nguyenthanhthe/uet-robotic-arm/docs/media/frames_assembly_check/frame_12.5s.jpg

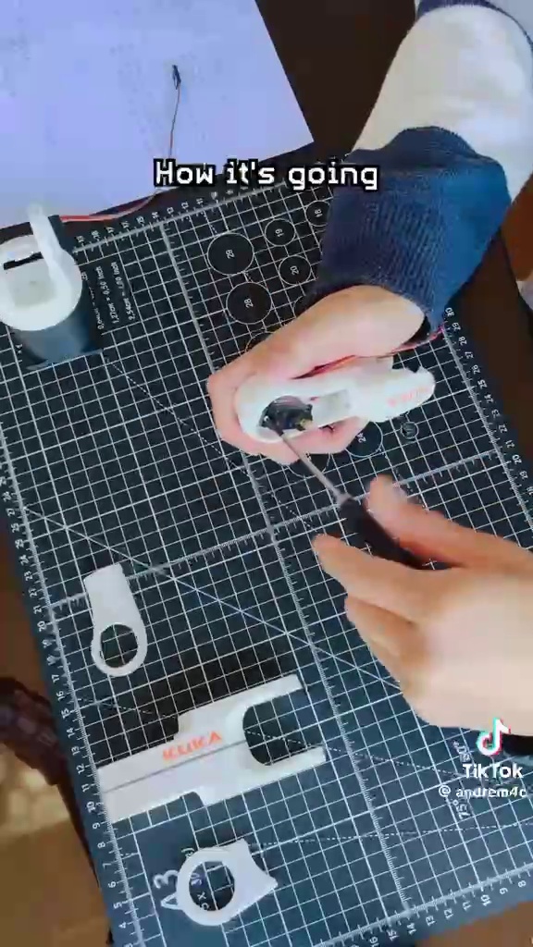
docs/media/frames_assembly_check/frame_12.5s.jpg
