nguyenthanhthe/uet-robotic-arm/docs/archive/rebrand-v2.md

note: not publish modified cad files, focus on completely on v2RAD, remove unnessary components detailed in cad step files: 
1, Base-Cover-rebranded.step: a triangle 55x68mm Protrude by 1mm. 
2, forearm-cover
3, forearm-main
