nguyenthanhthe/uet-robotic-arm/cad/exports/v2rad/engraving-Base-Cover.png

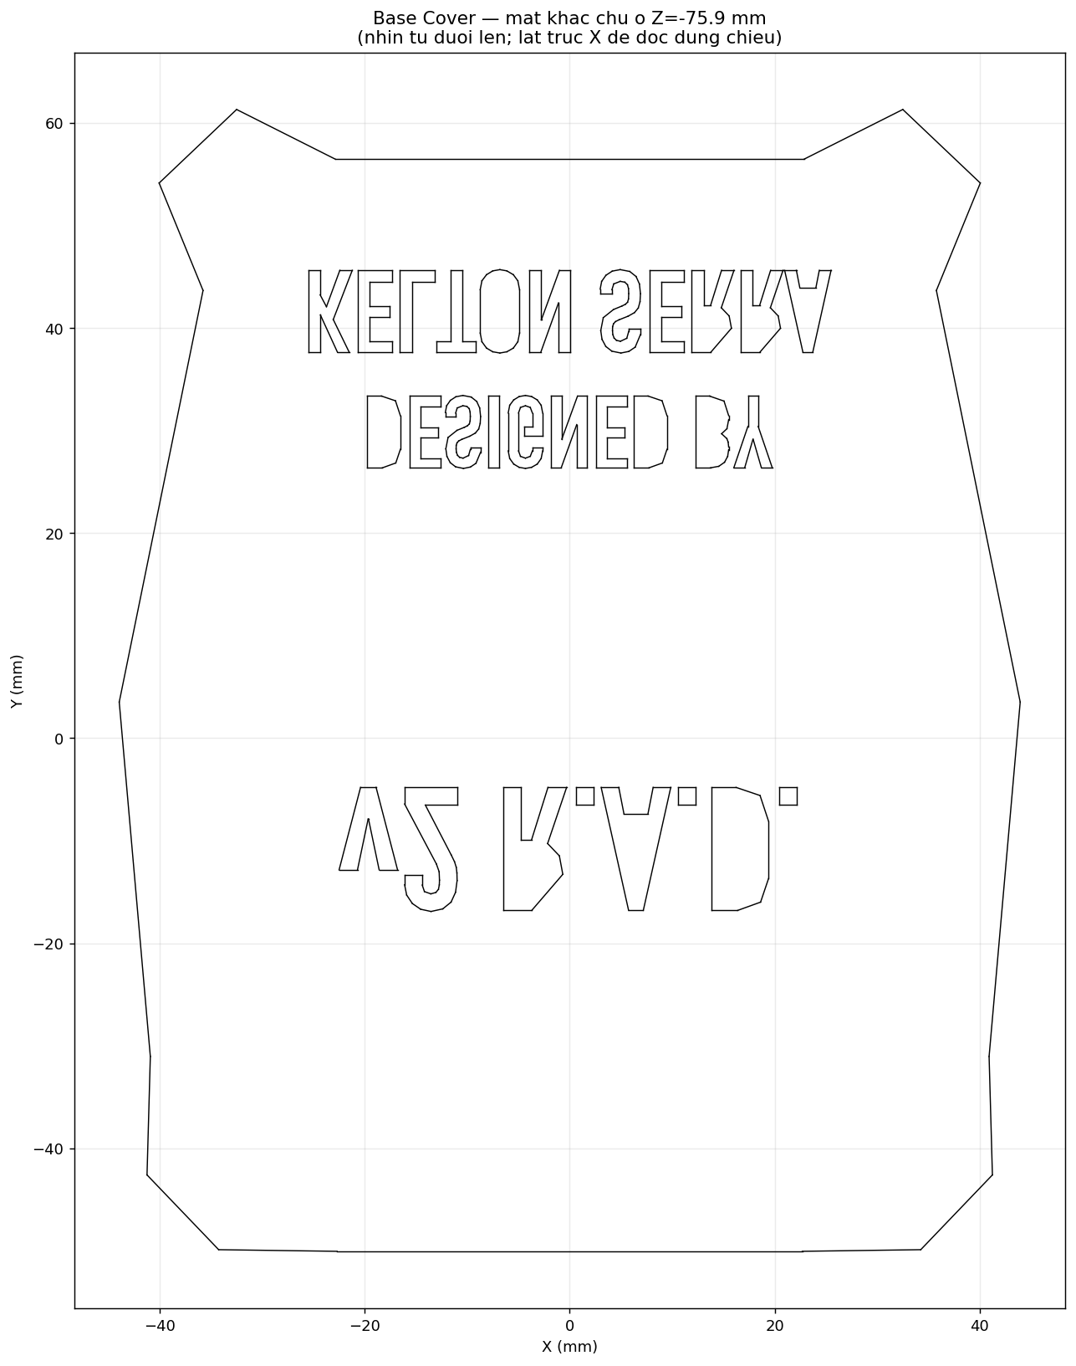
cad/exports/v2rad/engraving-Base-Cover.png
