nguyenthanhthe/uet-robotic-arm/cad/reference/02_Base_Turret_preview.png

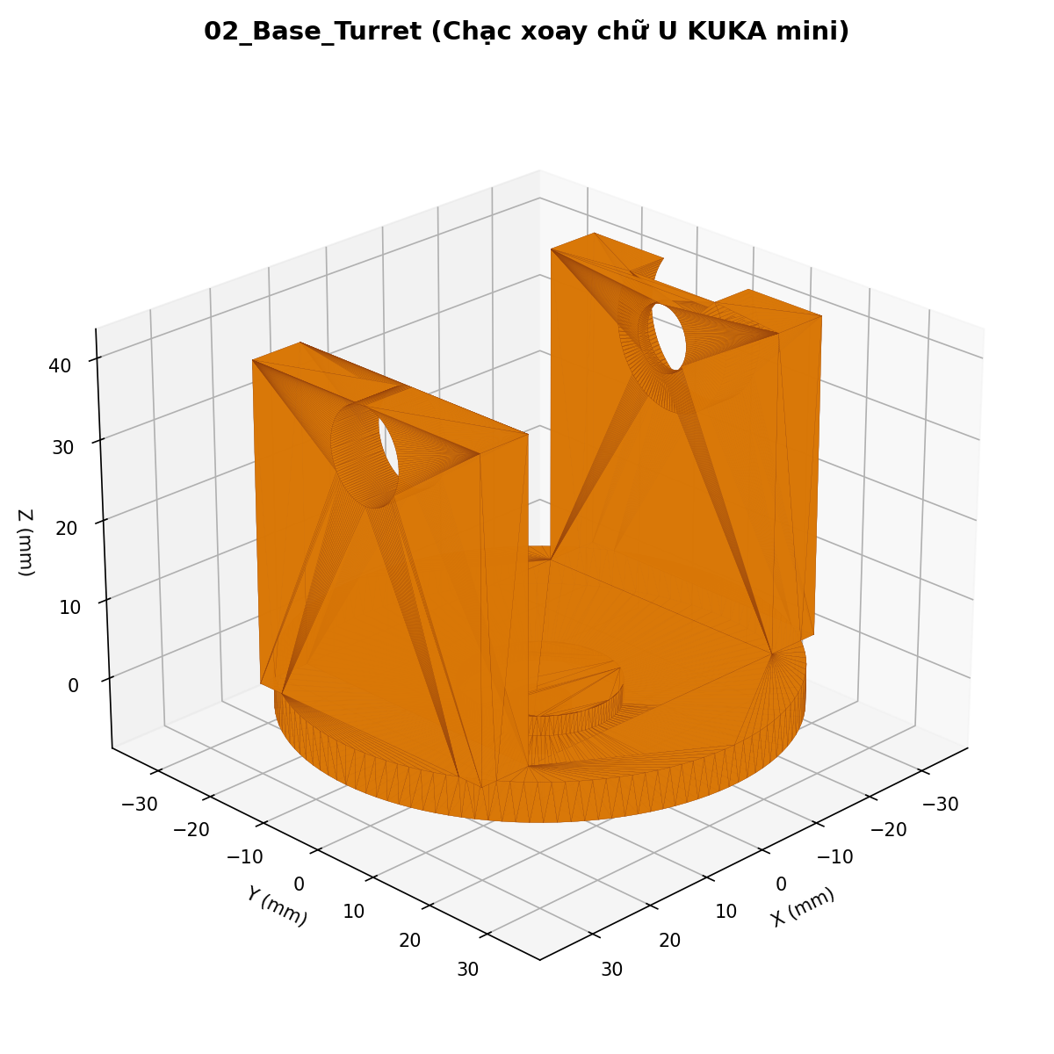
cad/reference/02_Base_Turret_preview.png
