nguyenthanhthe/uet-robotic-arm/cad/reference/fusion_live_viewport.png

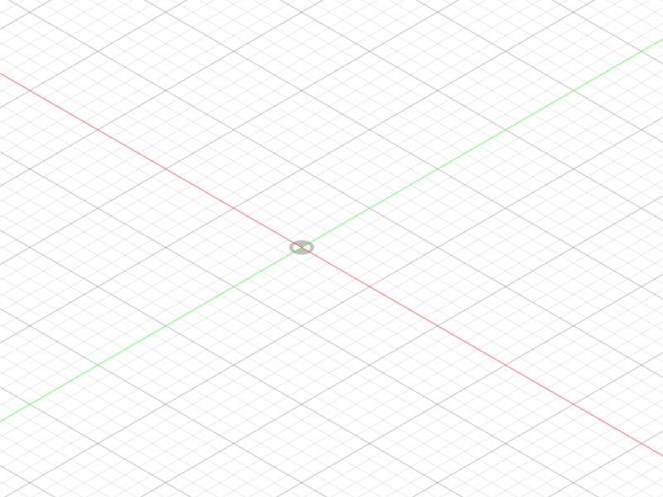
cad/reference/fusion_live_viewport.png
