nguyenthanhthe/uet-robotic-arm/cad/reference/fusion_skeleton_viewport.png

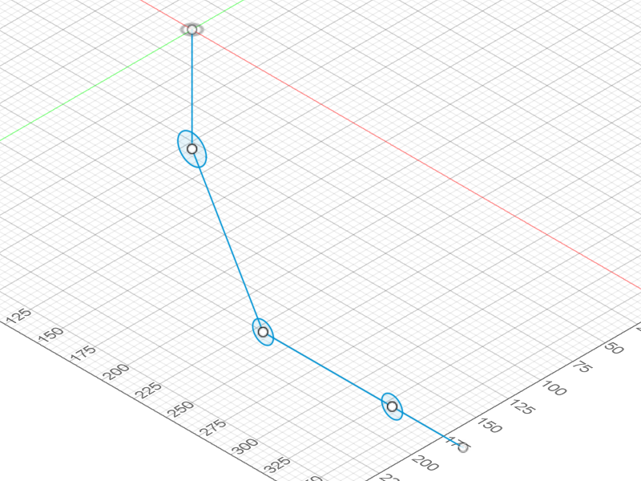
cad/reference/fusion_skeleton_viewport.png
