nguyenthanhthe/uet-robotic-arm/cad/reference/kuka_kr3_link_1_reference.png

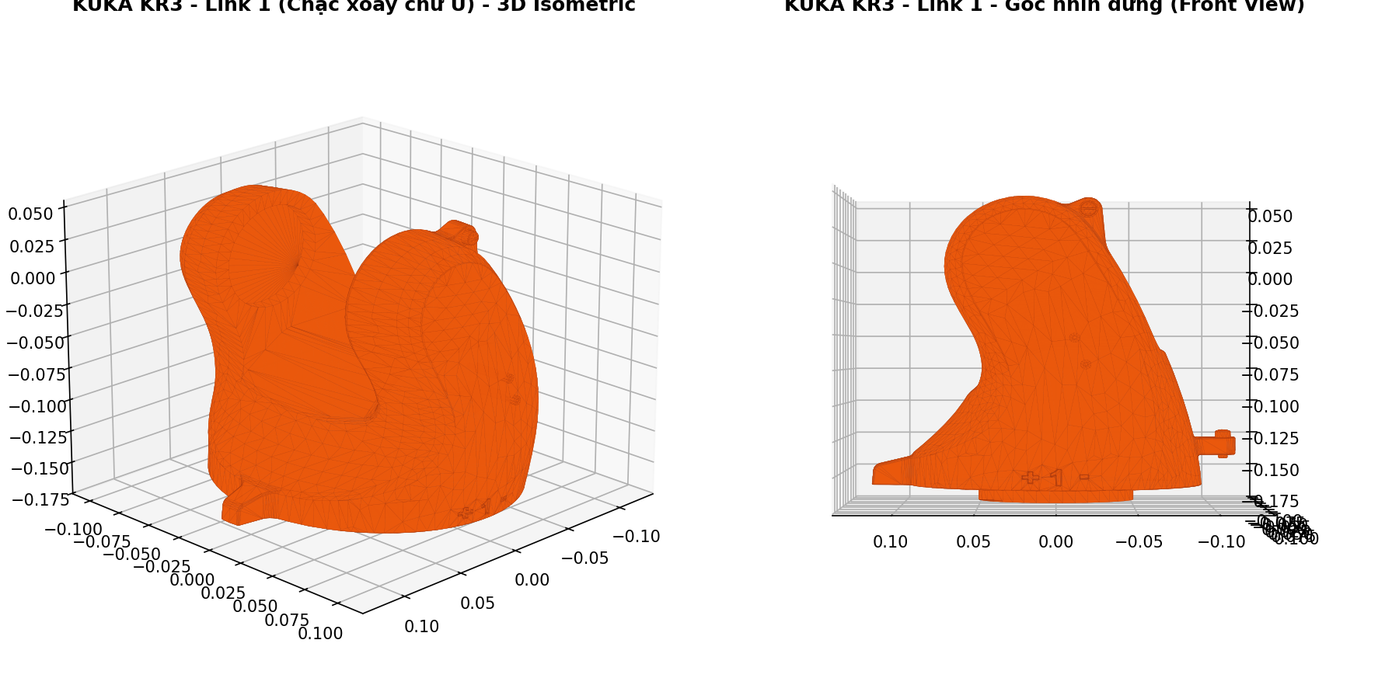
cad/reference/kuka_kr3_link_1_reference.png
