nguyenthanhthe/uet-robotic-arm/docs/images/v2rad.png

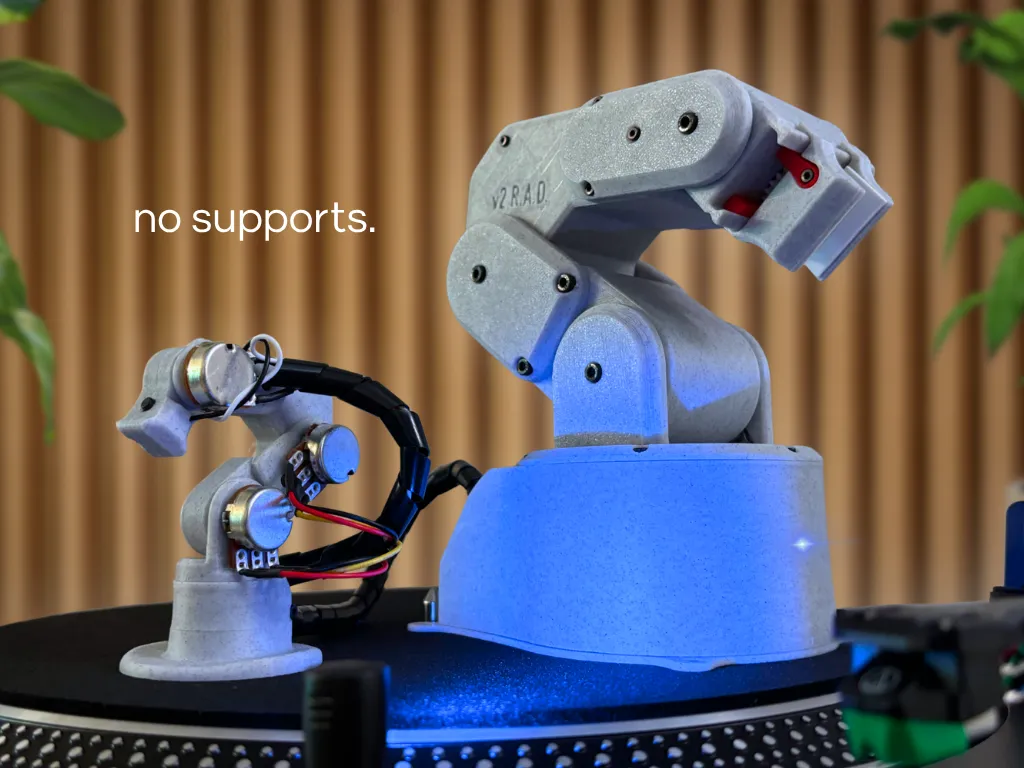
docs/images/v2rad.png
