nguyenthanhthe/uet-robotic-arm/docs/media/frames_base/asm_0_10.9s.jpg

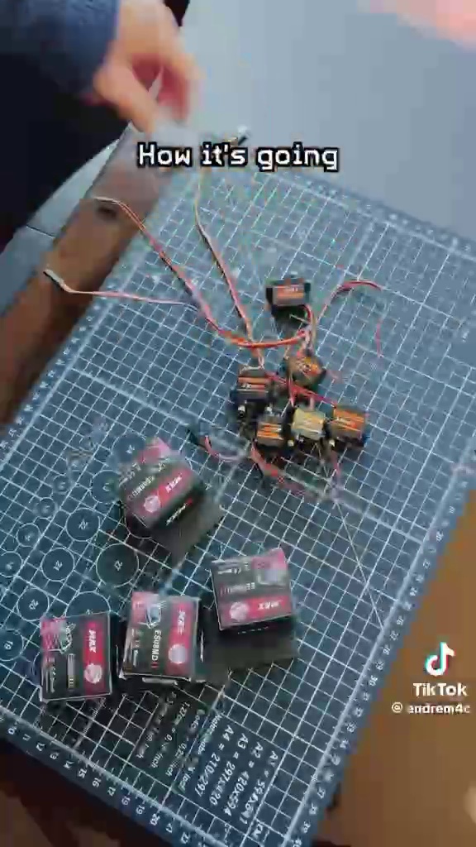
docs/media/frames_base/asm_0_10.9s.jpg
