nguyenthanhthe/uet-robotic-arm/docs/media/frames_base/asm_1_11.1s.jpg

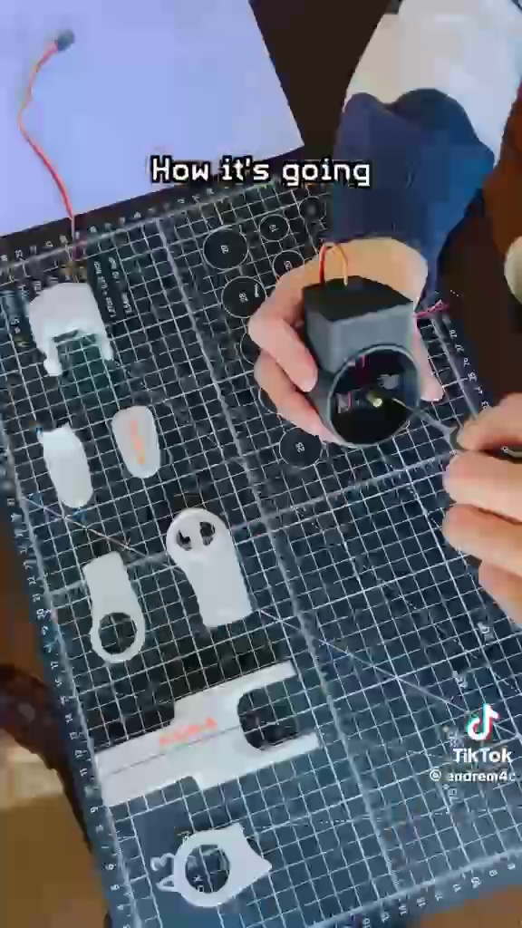
docs/media/frames_base/asm_1_11.1s.jpg
