nguyenthanhthe/uet-robotic-arm/docs/media/frames_base/asm_3_11.7s.jpg

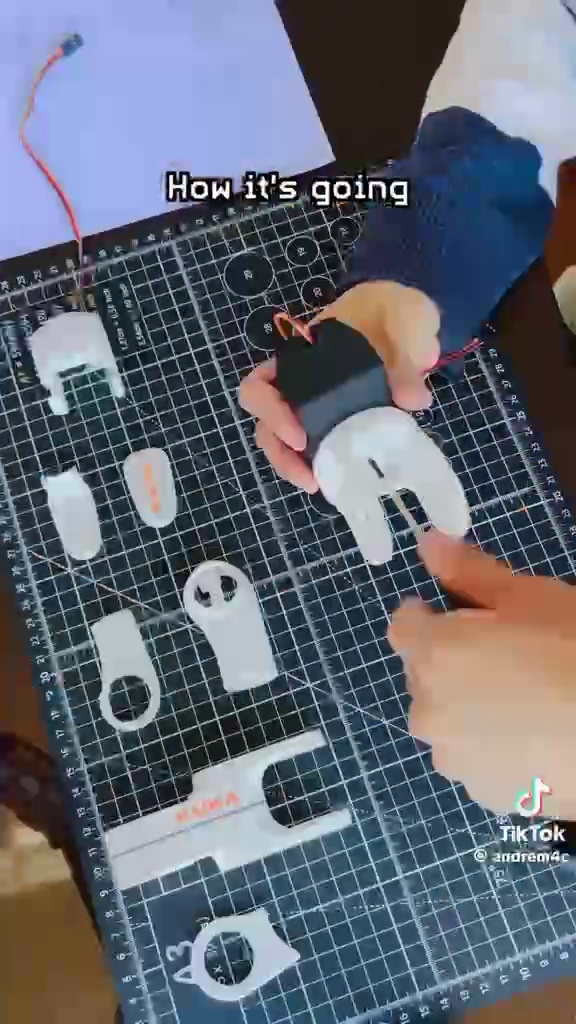
docs/media/frames_base/asm_3_11.7s.jpg
