nguyenthanhthe/uet-robotic-arm/docs/media/frames_base/detail_0_3.3s.jpg

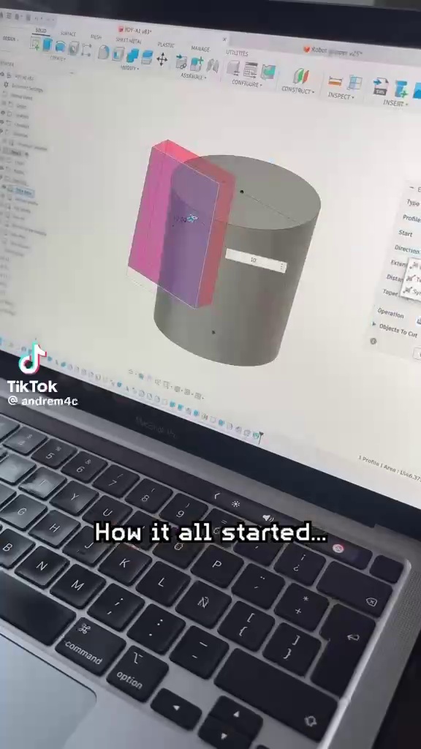
docs/media/frames_base/detail_0_3.3s.jpg
