nguyenthanhthe/uet-robotic-arm/docs/media/frames_base/detail_1_3.7s.jpg

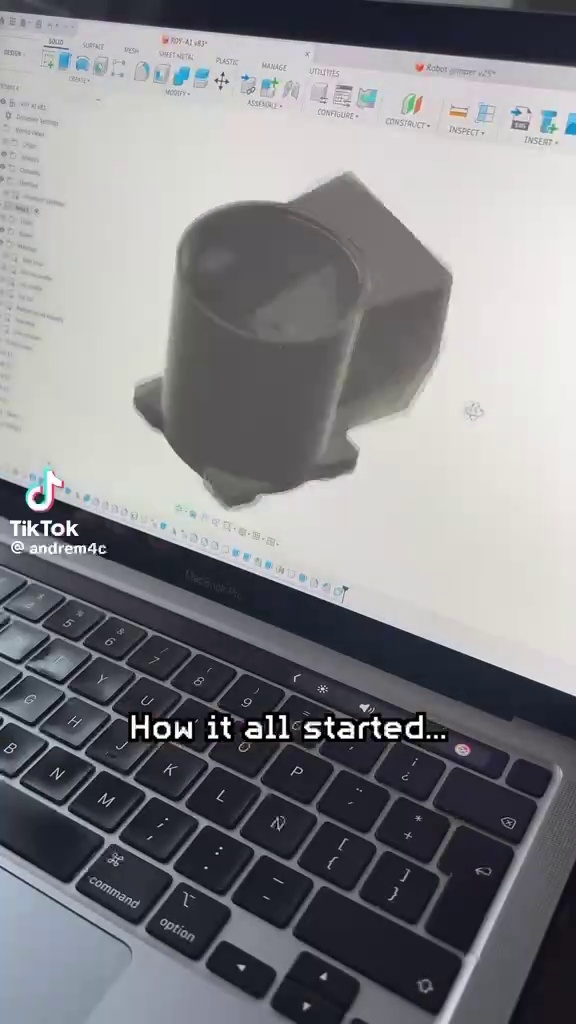
docs/media/frames_base/detail_1_3.7s.jpg
