nguyenthanhthe/uet-robotic-arm/docs/media/frames_base/detail_2_4.0s.jpg

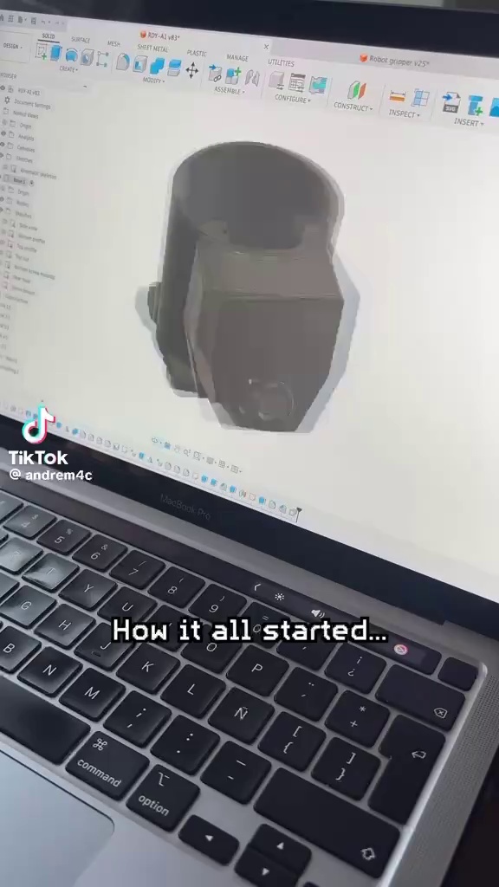
docs/media/frames_base/detail_2_4.0s.jpg
