nguyenthanhthe/uet-robotic-arm/docs/media/frames_base/detail_3_9.5s.jpg

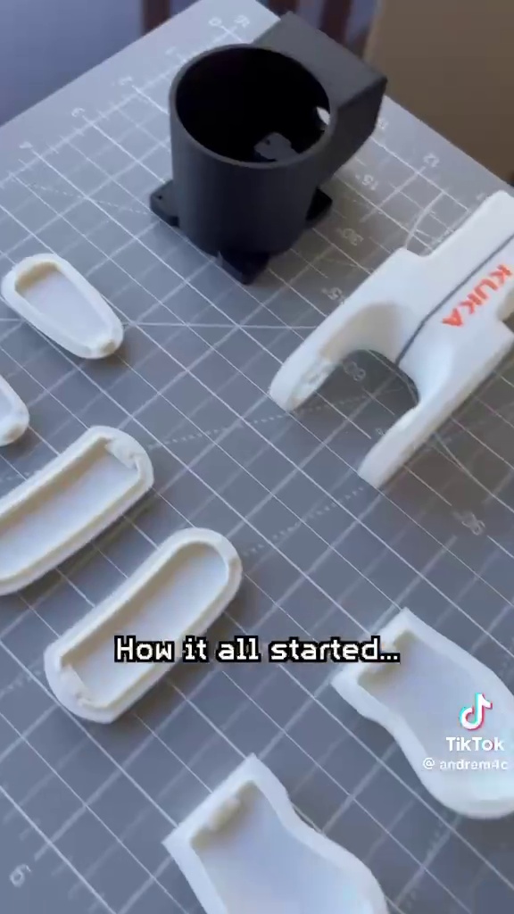
docs/media/frames_base/detail_3_9.5s.jpg
