nguyenthanhthe/uet-robotic-arm/docs/media/frames_base/detail_4_10.2s.jpg

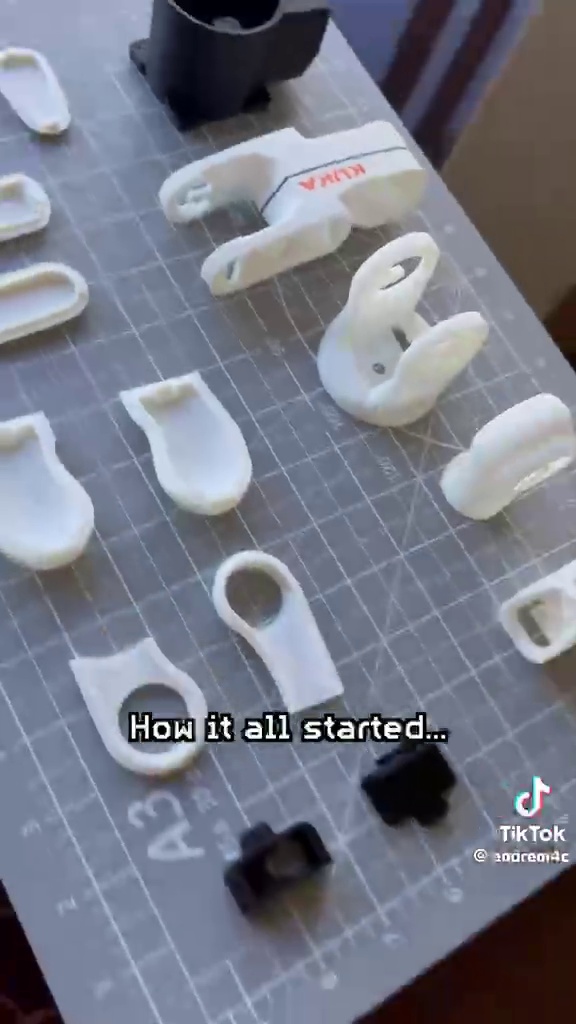
docs/media/frames_base/detail_4_10.2s.jpg
