nguyenthanhthe/uet-robotic-arm/docs/media/frames_base/frame_0_2.5s.jpg

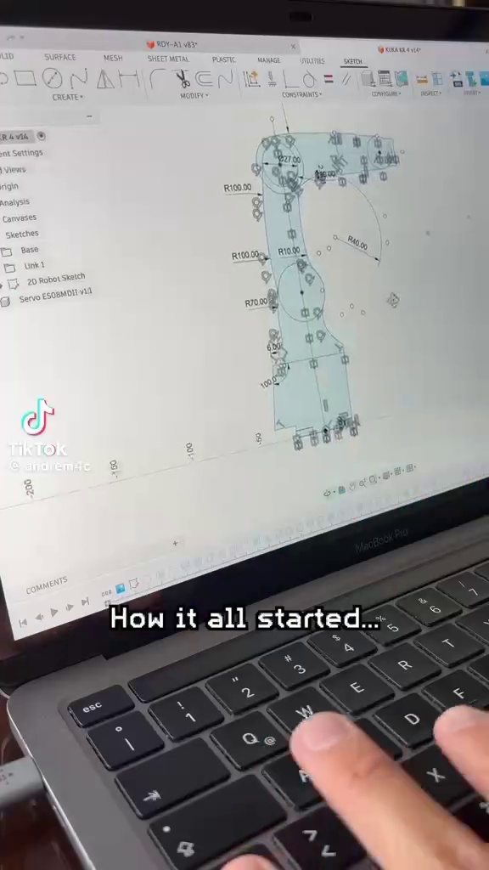
docs/media/frames_base/frame_0_2.5s.jpg
