nguyenthanhthe/uet-robotic-arm/docs/media/frames_base/frame_2_9.2s.jpg

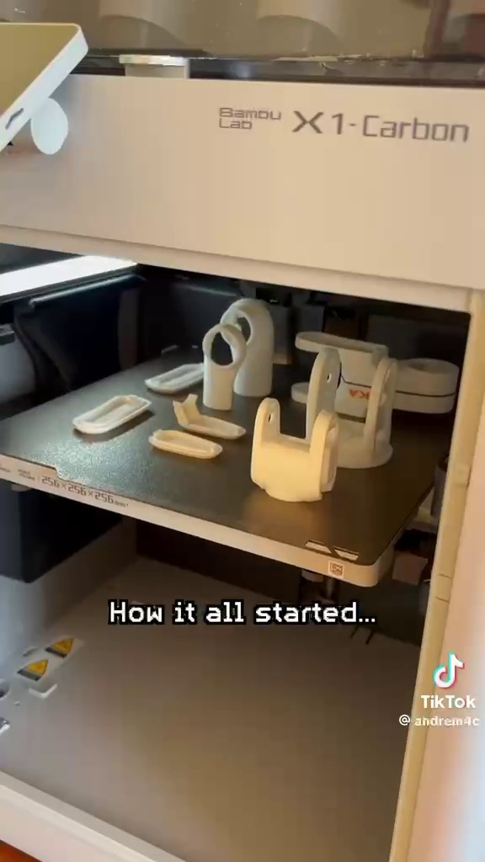
docs/media/frames_base/frame_2_9.2s.jpg
