nguyenthanhthe/uet-robotic-arm/docs/media/frames_base/frame_3_10.5s.jpg

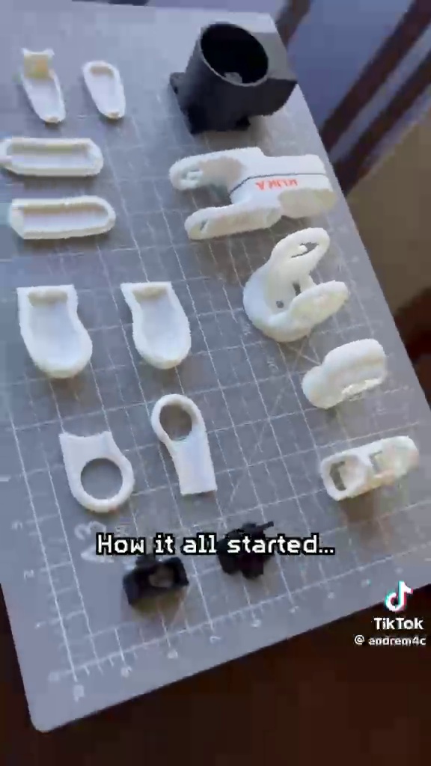
docs/media/frames_base/frame_3_10.5s.jpg
