nguyenthanhthe/uet-robotic-arm/docs/media/Metadata/plate_1.png

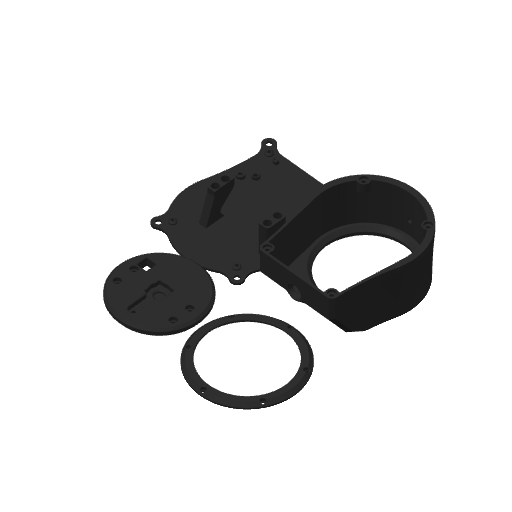
docs/media/Metadata/plate_1.png
