nguyenthanhthe/uet-robotic-arm/docs/media/Metadata/plate_2.png

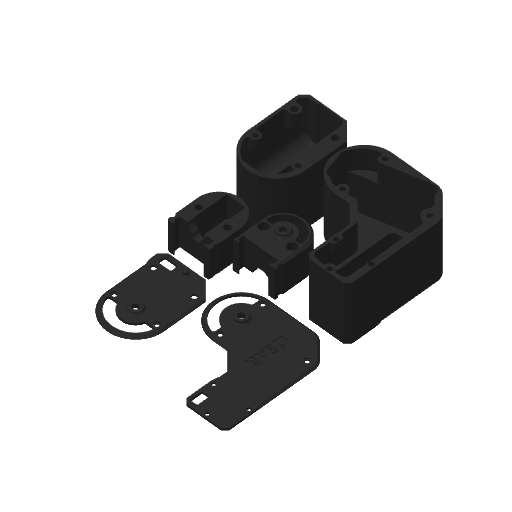
docs/media/Metadata/plate_2.png
