nguyenthanhthe/uet-robotic-arm/docs/media/Metadata/plate_3.png

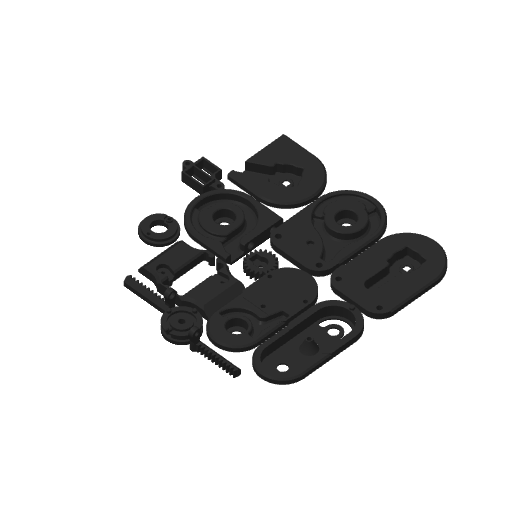
docs/media/Metadata/plate_3.png
