nguyenthanhthe/uet-robotic-arm/docs/media/Metadata/plate_4.png

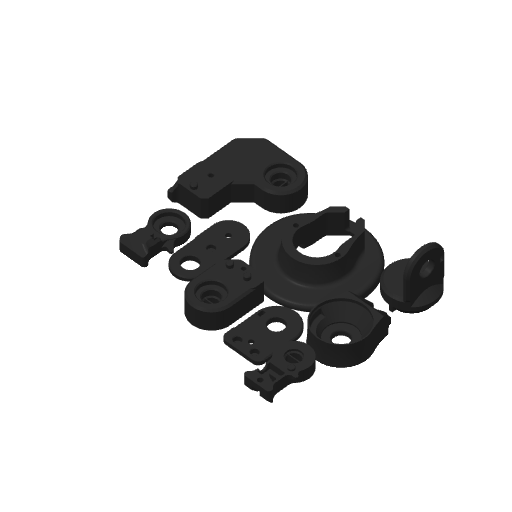
docs/media/Metadata/plate_4.png
