nguyenthanhthe/uet-robotic-arm/hardware/reference/kuka_kr3_r540/KR3-R450.png

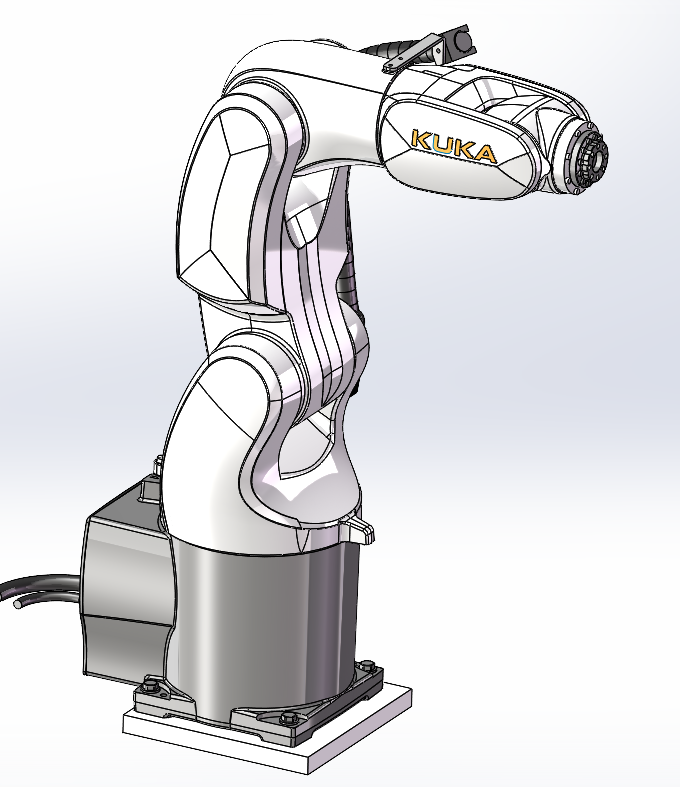
hardware/reference/kuka_kr3_r540/KR3-R450.png
