nguyenthanhthe/uet-robotic-arm/cad/exports/v2rad/PARTS.md

# Danh sách chi tiết — Cánh tay robot (v2RAD)

Nguồn: `hardware/reference/v2rad-all-parts.step`  
Số chi tiết: **24**  
Tổng thể tích: **317.31 cm³**  
Khối lượng PLA (1.24 g/cm³): **393.5 g**

> Sinh tự động bởi `cad/tools/split_step_parts.py` — **không sửa tay**.

## Cánh tay trên (main arm)

| # | Chi tiết | File | Kích thước (mm) | Thể tích | KL (PLA) | Lỗ ổ bi lớn nhất |
|---|---|---|---|---|---|---|
| 0 | **Main Arm Cover** | `Main-Arm-Cover.step` | 3.8 × 59.0 × 40.0 | 2.68 cm³ | 3.3 g | Ø33.0 mm |
| 5 | **Shoulder Right** | `Shoulder-Right.step` | 7.8 × 40.0 × 41.0 | 7.09 cm³ | 8.8 g | Ø33.0 mm |
| 6 | **Shoulder Left** | `Shoulder-Left.step` | 7.8 × 40.0 × 41.0 | 8.17 cm³ | 10.1 g | Ø40.0 mm |
| 7 | **Main Arm Right** | `Main-Arm-Right.step` | 8.0 × 59.0 × 40.0 | 11.49 cm³ | 14.2 g | Ø34.0 mm |
| 8 | **Main Arm Main** | `Main-Arm-Main.step` | 42.5 × 59.0 × 40.0 | 34.66 cm³ | 43.0 g | Ø40.0 mm |
| 9 | **Main Arm Left** | `Main-Arm-Left.step` | 8.0 × 59.0 × 40.0 | 12.76 cm³ | 15.8 g | Ø40.0 mm |

## Cẳng tay (forearm)

| # | Chi tiết | File | Kích thước (mm) | Thể tích | KL (PLA) | Lỗ ổ bi lớn nhất |
|---|---|---|---|---|---|---|
| 1 | **Forearm Main** | `Forearm-Main.step` | 42.5 × 81.5 × 70.0 | 60.44 cm³ | 74.9 g | Ø40.0 mm |
| 10 | **Forearm Cover** | `Forearm-Cover.step` | 3.8 × 81.5 × 70.0 | 5.06 cm³ | 6.3 g | Ø34.0 mm |
| 11 | **Forearm Right** | `Forearm-Right.step` | 8.0 × 65.5 × 30.0 | 10.88 cm³ | 13.5 g | Ø11.2 mm |
| 12 | **Forearm Left** | `Forearm-Left.step` | 9.5 × 65.5 × 30.0 | 4.72 cm³ | 5.9 g | Ø22.0 mm |

## Cổ tay (wrist)

| # | Chi tiết | File | Kích thước (mm) | Thể tích | KL (PLA) | Lỗ ổ bi lớn nhất |
|---|---|---|---|---|---|---|
| 2 | **Wrist Right** | `Wrist-Right.step` | 24.2 × 40.1 × 40.1 | 11.10 cm³ | 13.8 g | Ø30.0 mm |
| 13 | **Pulley Servo Horn** | `Pulley-Servo-Horn.step` | 4.0 × 20.8 × 20.8 | 0.89 cm³ | 1.1 g | Ø20.8 mm |
| 20 | **Wrist Pulley** | `Wrist-Pulley.step` | 8.5 × 20.8 × 20.8 | 1.83 cm³ | 2.3 g | Ø20.8 mm |
| 21 | **Wrist Left** | `Wrist-Left.step` | 22.0 × 40.1 × 40.1 | 12.45 cm³ | 15.4 g | Ø30.0 mm |

## Base / thân xoay

| # | Chi tiết | File | Kích thước (mm) | Thể tích | KL (PLA) | Lỗ ổ bi lớn nhất |
|---|---|---|---|---|---|---|
| 3 | **Shoulder Base** | `Shoulder-Base.step` | 74.0 × 74.0 × 8.0 | 29.89 cm³ | 37.1 g | Ø74.0 mm |
| 4 | **Shoulder Ring** | `Shoulder-Ring.step` | 88.0 × 88.0 × 4.5 | 7.12 cm³ | 8.8 g | Ø88.0 mm |
| 22 | **Base Main** | `Base-Main.step` | 92.0 × 112.5 × 48.4 | 61.95 cm³ | 76.8 g | Ø82.0 mm |
| 23 | **Base Cover** | `Base-Cover.step` | 92.0 × 119.5 × 30.5 | 25.07 cm³ | 31.1 g | Ø92.0 mm |

## Khác

| # | Chi tiết | File | Kích thước (mm) | Thể tích | KL (PLA) | Lỗ ổ bi lớn nhất |
|---|---|---|---|---|---|---|
| 14 | **Controller Plug Cover** | `Controller-Plug-Cover.step` | 27.2 × 14.0 × 16.4 | 0.80 cm³ | 1.0 g | — |

## Tay gắp (gripper)

| # | Chi tiết | File | Kích thước (mm) | Thể tích | KL (PLA) | Lỗ ổ bi lớn nhất |
|---|---|---|---|---|---|---|
| 15 | **Gripper Gear** | `Gripper-Gear.step` | 17.5 × 15.9 × 15.9 | 0.76 cm³ | 0.9 g | — |
| 16 | **Gripper Rack Left** | `Gripper-Rack-Left.step` | 30.3 × 14.1 × 12.6 | 0.65 cm³ | 0.8 g | — |
| 17 | **Gripper Left** | `Gripper-Left.step` | 7.0 × 37.9 × 37.9 | 3.11 cm³ | 3.9 g | Ø22.0 mm |
| 18 | **Gripper Rack Right** | `Gripper-Rack-Right.step` | 30.3 × 12.6 × 14.1 | 0.65 cm³ | 0.8 g | — |
| 19 | **Gripper Right** | `Gripper-Right.step` | 7.0 × 37.9 × 37.9 | 3.11 cm³ | 3.9 g | Ø22.0 mm |
