nguyenthanhthe/uet-robotic-arm/cad/exports/v2rad/step/Main-Arm-Left.step

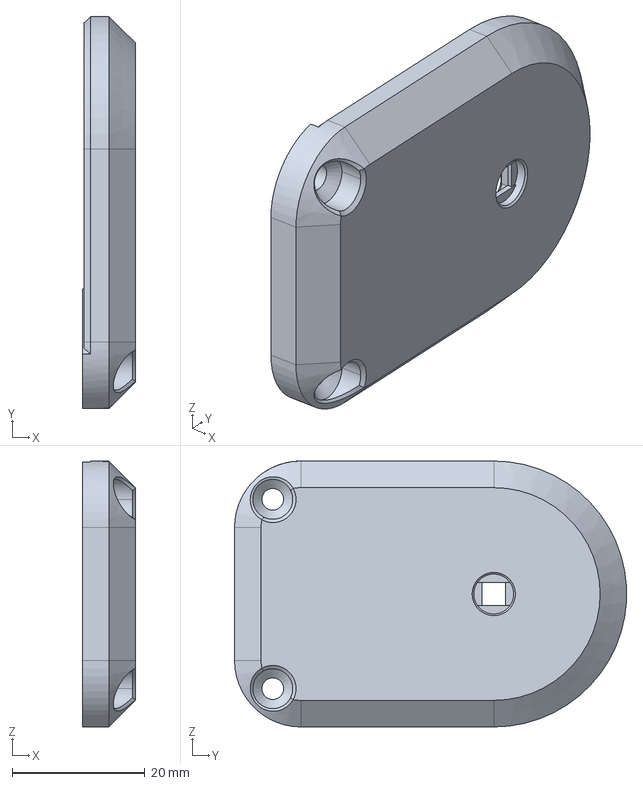
[picture p25: CAD file, 2026-09-25]
cad/exports/v2rad/step/Main-Arm-Left.step
8.00 x 59.0 x 40.0 mm
