nguyenthanhthe/uet-robotic-arm/cad/exports/v2rad/v2rad.SLDASM

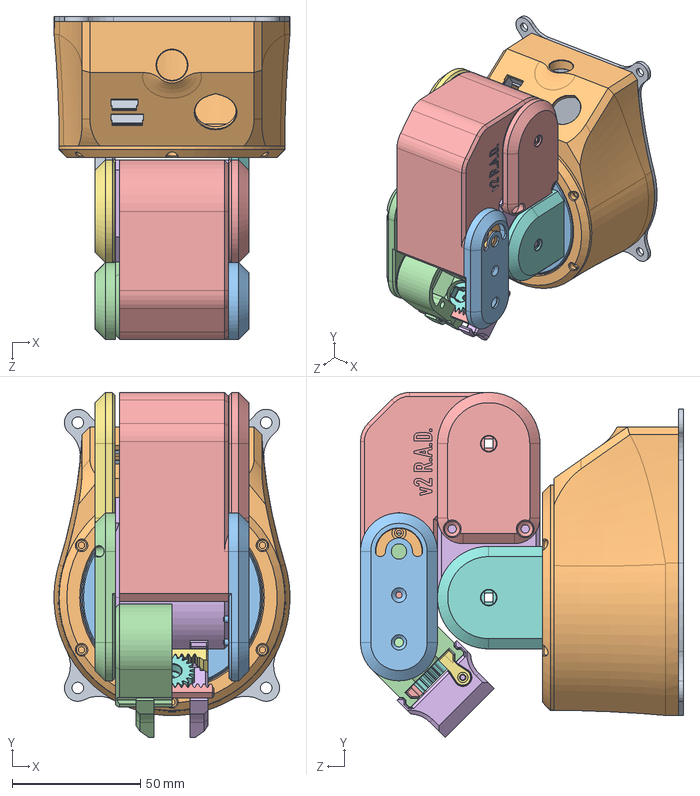
[picture p26: CAD file, 2026-09-25]
cad/exports/v2rad/v2rad.SLDASM
92.0 x 134.6 x 125.9 mm
Main Arm Cover[1]
Forearm Main[1]
Wrist Right[1]
Shoulder Base[1]
Shoulder Ring[1]
Shoulder Right[1]
Shoulder Left[1]
Main Arm Right[1]
Main Arm Main[1]
Main Arm Left[1]
Forearm Right[1]
Forearm Left[1]
Pulley Servo Horn[1]
Controller Plug Cover[1]
Gripper Gear[1]
Gripper Rack Left[1]
Gripper Left[1]
Gripper Rack Right[1]
Gripper Right[1]
Wrist Pulley[1]
Base Main[1]
Base Cover[1]
