nguyenthanhthe/uet-robotic-arm/cad/parts/00_Robot_J1J2_Assembly.SLDASM

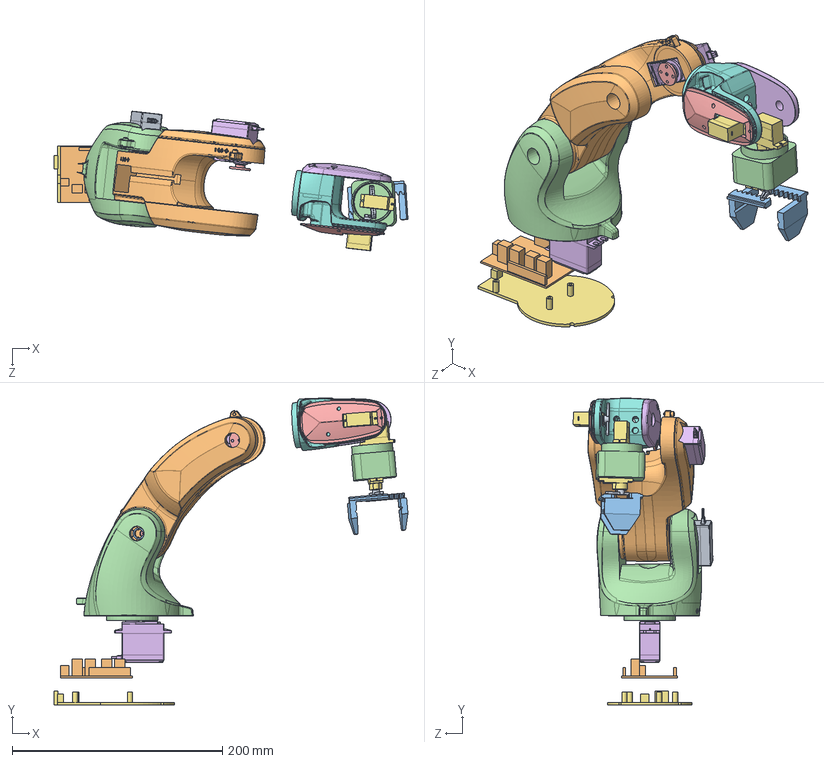
[picture p27: CAD file, 2026-10-11]
cad/parts/00_Robot_J1J2_Assembly.SLDASM
336.8 x 291.9 x 132.9 mm
01_Base_Tray
servoMotorMG996R x 2
Servo horn v2 x 3
02_Turret_ForkKuka
03_J2_BearingSpacer
03_UpperArmKuka
DS3225SG
04_Forearm_ForkKuka
MG90S_body x 3
04_Forearm_CoverPivot
04_Forearm_CoverServo
06_Gripper_Base
06_Gripper_Jaw x 2
PCA9685_Servo_Shield
MG90S_Horn_2arm x 3
