nguyenthanhthe/uet-robotic-arm/hardware/reference/v2rad_parts/Forearm Main[1].SLDPRT

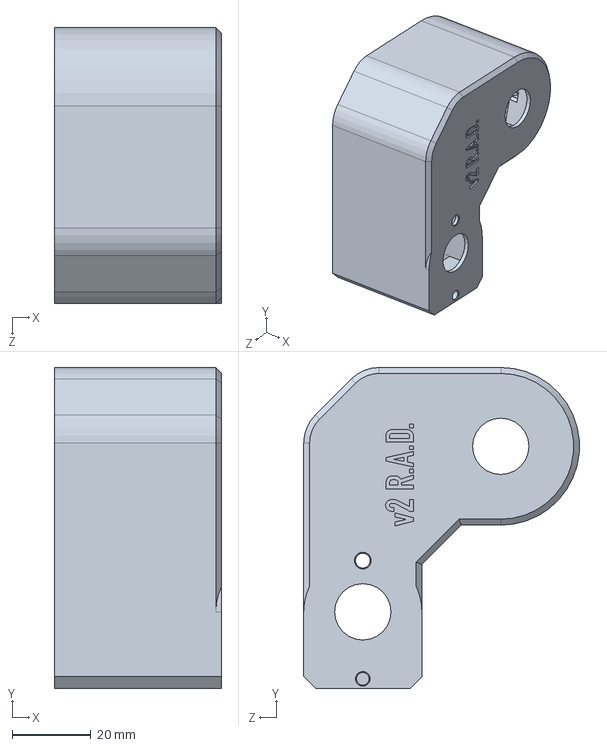
[picture p28: CAD file, 2026-09-27]
hardware/reference/v2rad_parts/Forearm Main[1].SLDPRT
42.5 x 81.5 x 69.9 mm
