nguyenthanhthe/uet-robotic-arm/hardware/reference/v2rad_parts/Main Arm Main[1].SLDPRT

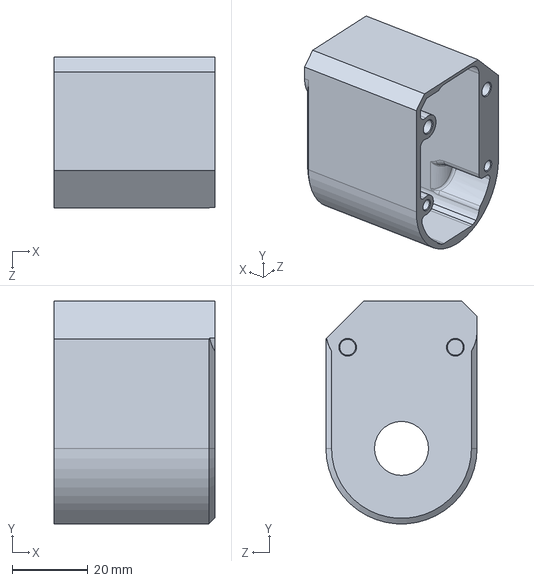
[picture p29: CAD file, 2026-09-27]
hardware/reference/v2rad_parts/Main Arm Main[1].SLDPRT
42.5 x 59.0 x 40.0 mm
