nguyenthanhthe/uet-robotic-arm/cad/exports/v2rad/step/Main-Arm-Right.step

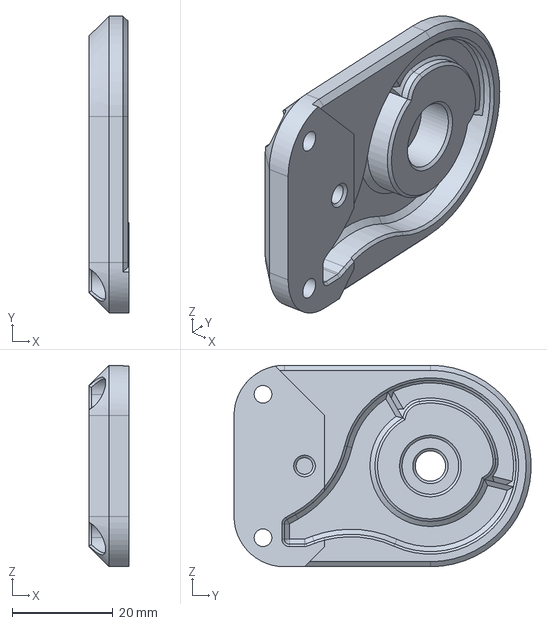
[picture p30: CAD file, 2026-09-25]
cad/exports/v2rad/step/Main-Arm-Right.step
8.00 x 59.0 x 40.0 mm
