nguyenthanhthe/uet-robotic-arm/hardware/reference/v2rad_parts/Base Main[1].SLDPRT

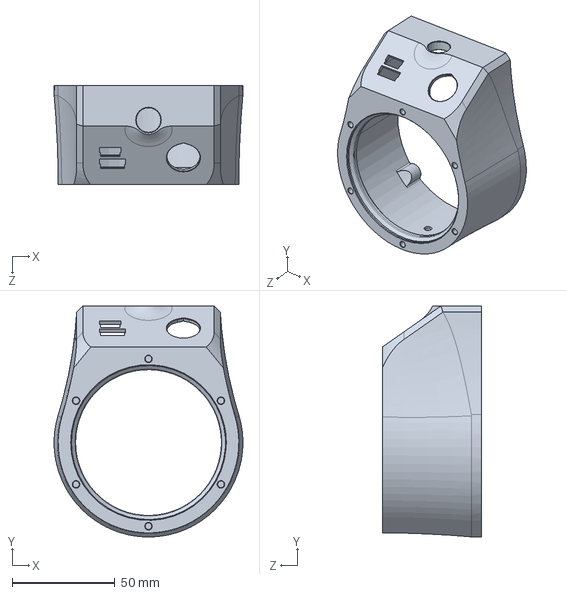
[picture p31: CAD file, 2026-09-27]
hardware/reference/v2rad_parts/Base Main[1].SLDPRT
91.9 x 112.5 x 48.4 mm
