nguyenthanhthe/uet-robotic-arm/cad/exports/v2rad/step/Main-Arm-Cover.step

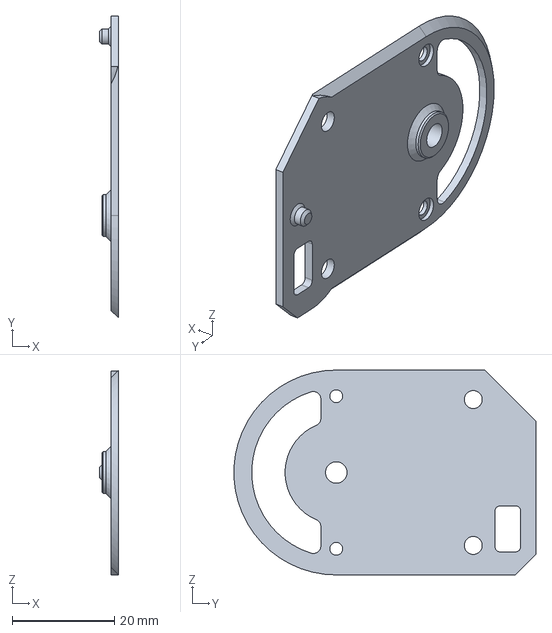
[picture p32: CAD file, 2026-09-25]
cad/exports/v2rad/step/Main-Arm-Cover.step
3.75 x 59.0 x 40.0 mm
