nguyenthanhthe/uet-robotic-arm/hardware/reference/cots_parts/Assembly SERVO.stp

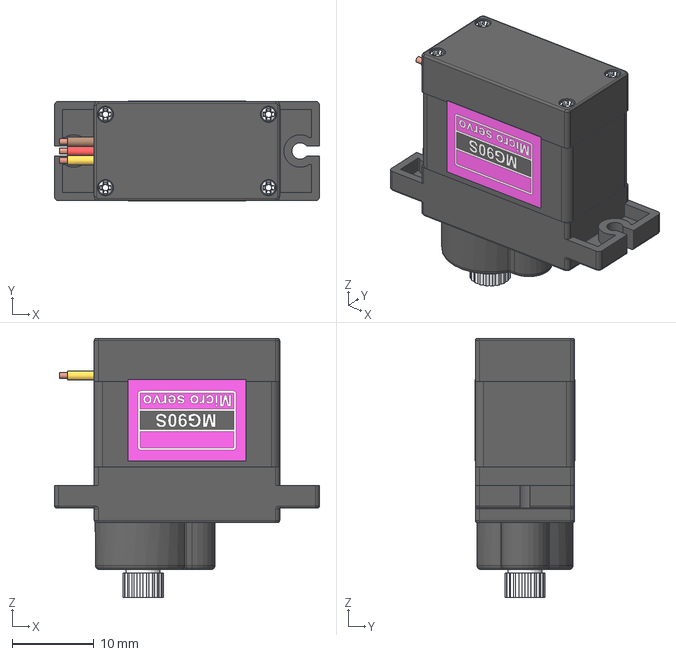
[picture p33: CAD file, 2026-09-27]
hardware/reference/cots_parts/Assembly SERVO.stp
32.5 x 12.3 x 31.8 mm
Assembly servo inside
Assembly servo outside
