nguyenthanhthe/uet-robotic-arm/cad/parts/02_Turret_ForkKuka_SubAssembly.SLDASM

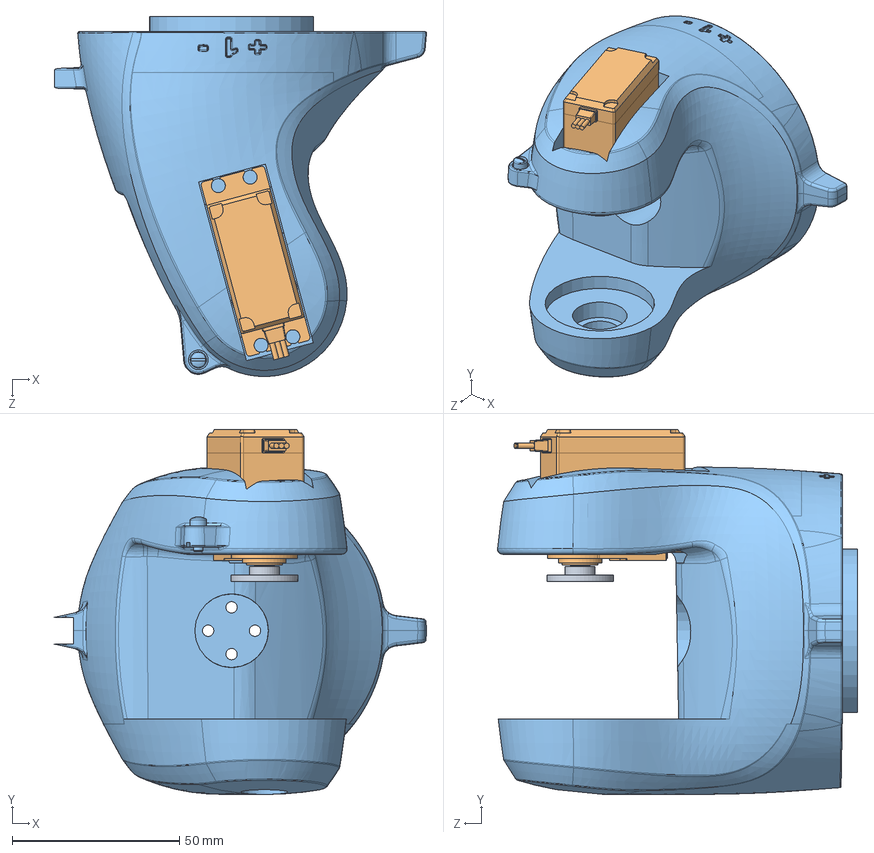
[picture p34: CAD file, 2026-10-10]
cad/parts/02_Turret_ForkKuka_SubAssembly.SLDASM
111.3 x 109.2 x 107.7 mm
02_Turret_ForkKuka
servoMotorMG996R
Servo horn v2
