nguyenthanhthe/uet-robotic-arm/hardware/reference/cots_parts/Servo horn v2.SLDPRT

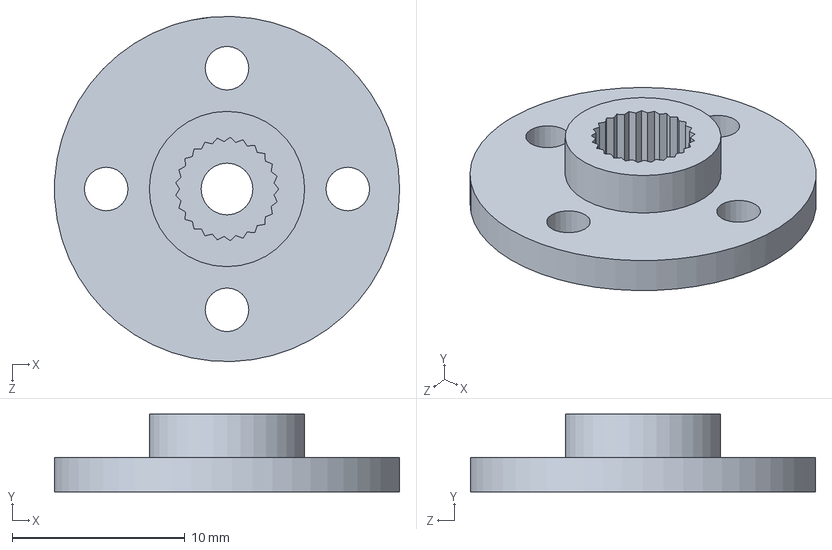
[picture p35: CAD file, 2026-10-10]
hardware/reference/cots_parts/Servo horn v2.SLDPRT
20.0 x 4.50 x 20.0 mm
