nguyenthanhthe/uet-robotic-arm/hardware/reference/cults3d_kuka/5.stl

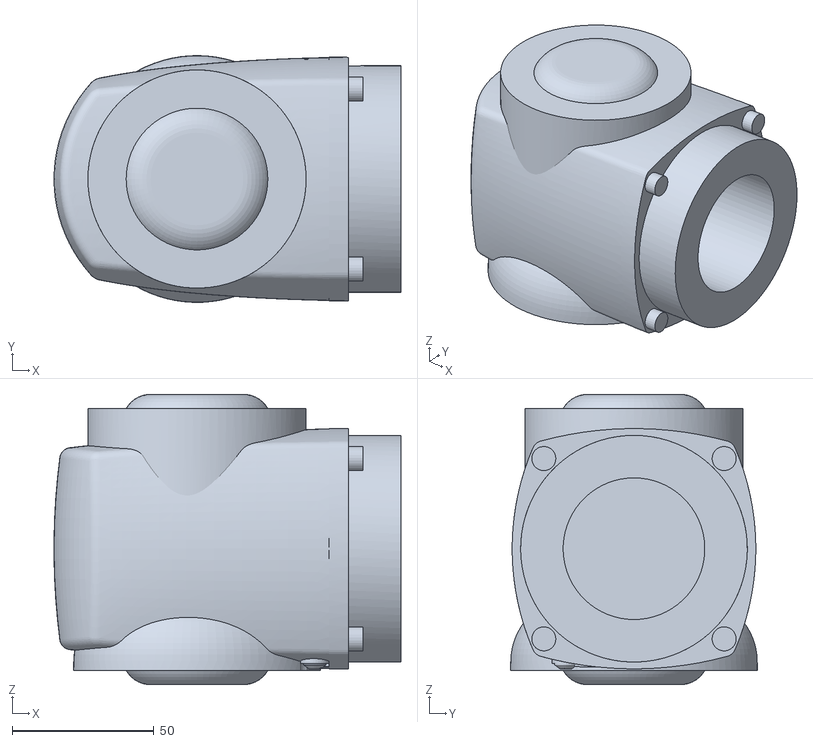
[picture p36: CAD file, 2026-09-27]
hardware/reference/cults3d_kuka/5.stl
122.5 x 87.1 x 102.5
