nguyenthanhthe/uet-robotic-arm/hardware/reference/Forearm Left[1].SLDPRT

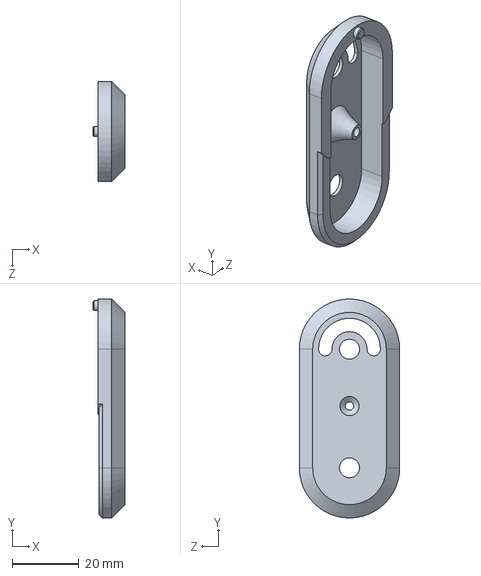
[picture p37: CAD file, 2026-09-25]
hardware/reference/Forearm Left[1].SLDPRT
9.50 x 65.5 x 30.0 mm
