nguyenthanhthe/uet-robotic-arm/cad/exports/v2rad/step/Gripper-Gear.step

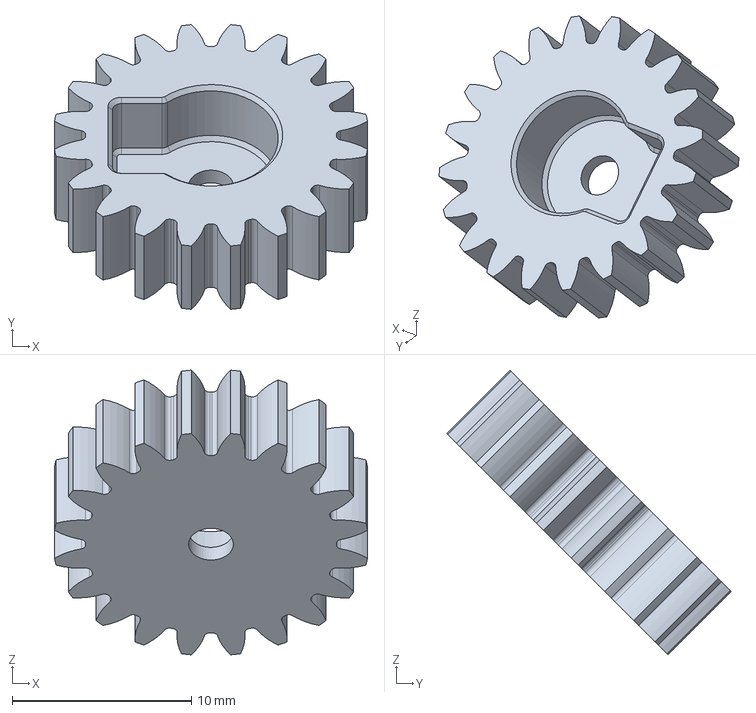
[picture p38: CAD file, 2026-09-25]
cad/exports/v2rad/step/Gripper-Gear.step
17.5 x 15.9 x 15.9 mm
