nguyenthanhthe/uet-robotic-arm/cad/parts/04_Forearm_CoverServo.SLDPRT

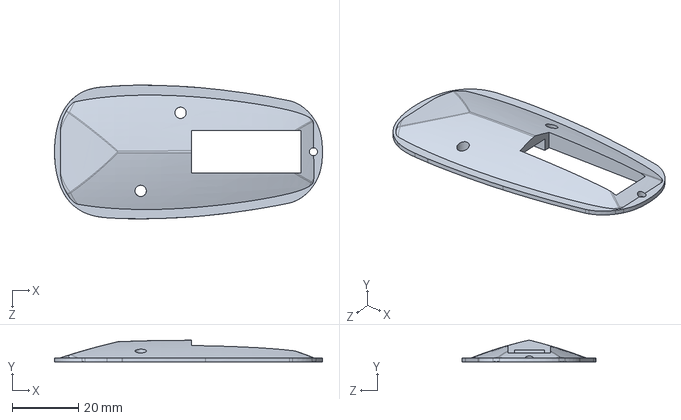
[picture p39: CAD file, 2026-10-11]
cad/parts/04_Forearm_CoverServo.SLDPRT
80.7 x 6.49 x 40.3 mm
