nguyenthanhthe/uet-robotic-arm/hardware/reference/cots_parts/MG90S_Horn_2arm.SLDPRT

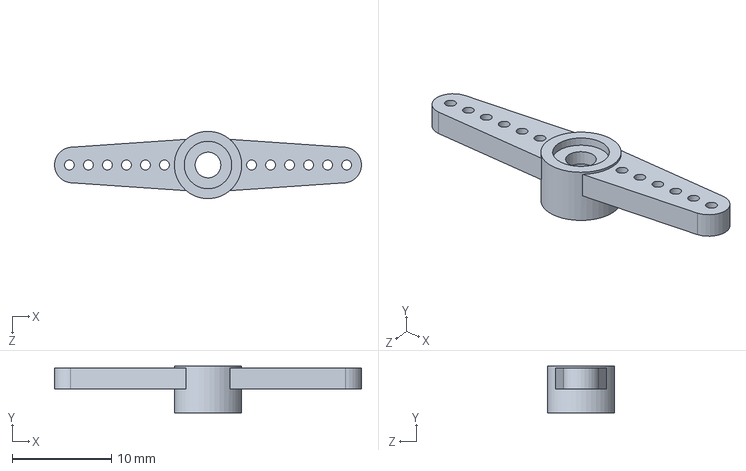
[picture p40: CAD file, 2026-10-10]
hardware/reference/cots_parts/MG90S_Horn_2arm.SLDPRT
31.0 x 4.70 x 6.80 mm
