nguyenthanhthe/uet-robotic-arm/hardware/reference/cults3d_kuka/0.stl

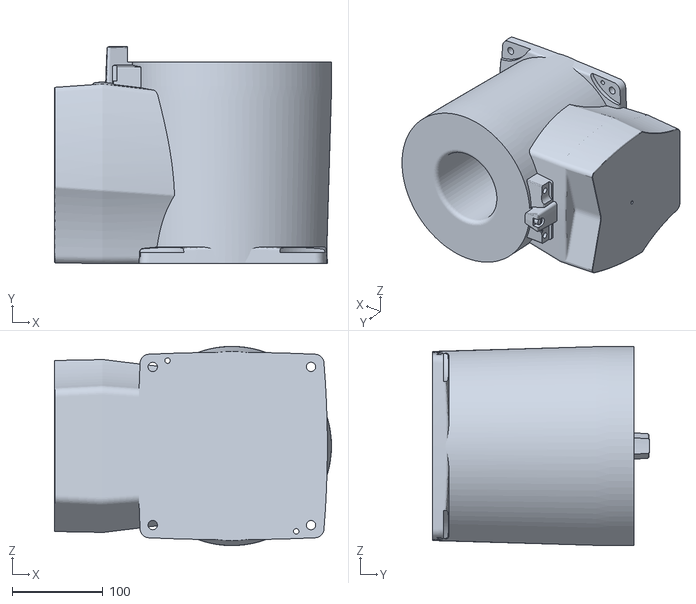
[picture p41: CAD file, 2026-09-27]
hardware/reference/cults3d_kuka/0.stl
304.5 x 238.8 x 219.0
