nguyenthanhthe/uet-robotic-arm/hardware/reference/v2rad_parts/Wrist Pulley[1].SLDPRT

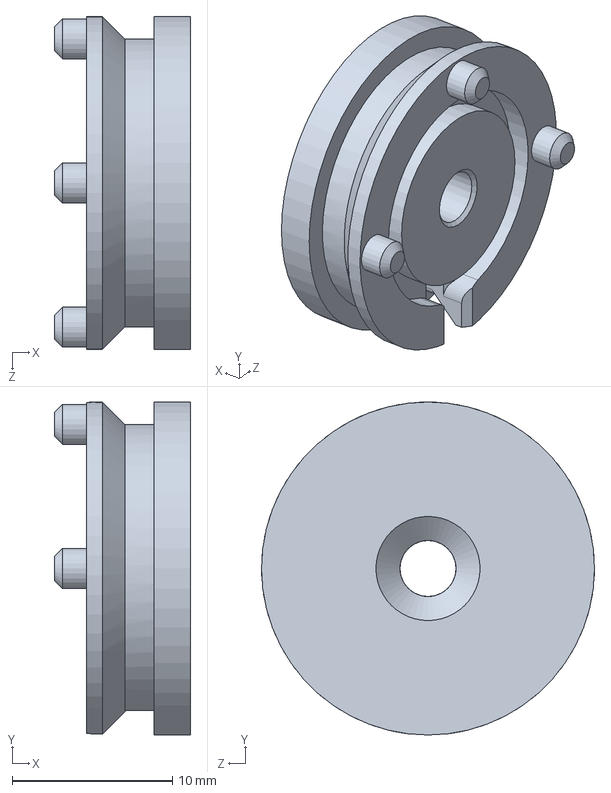
[picture p42: CAD file, 2026-09-27]
hardware/reference/v2rad_parts/Wrist Pulley[1].SLDPRT
8.50 x 20.8 x 20.8 mm
