nguyenthanhthe/uet-robotic-arm/cad/parts/02_Turret_ForkKuka.SLDPRT

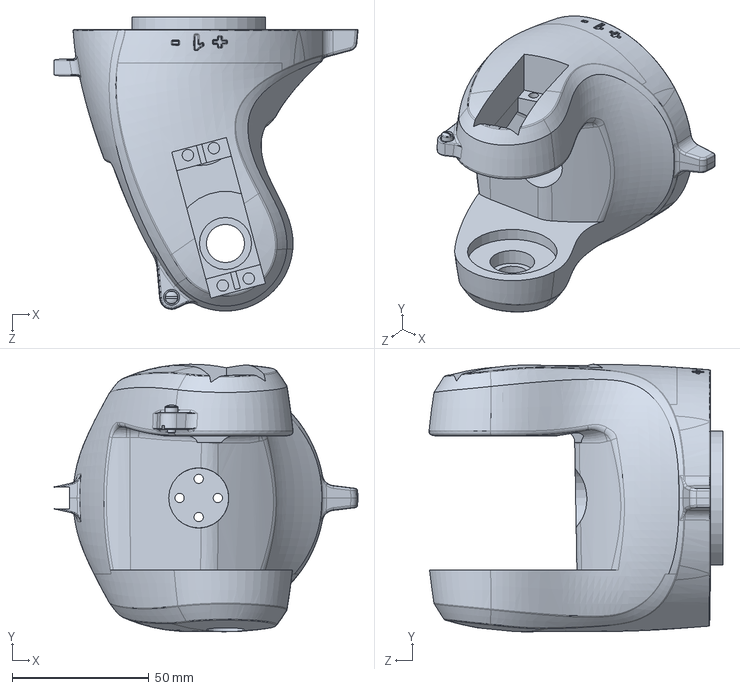
[picture p43: CAD file, 2026-10-11]
cad/parts/02_Turret_ForkKuka.SLDPRT
111.3 x 98.0 x 107.7 mm
