nguyenthanhthe/uet-robotic-arm/hardware/reference/cots_parts/servoMotorMG996R.SLDPRT

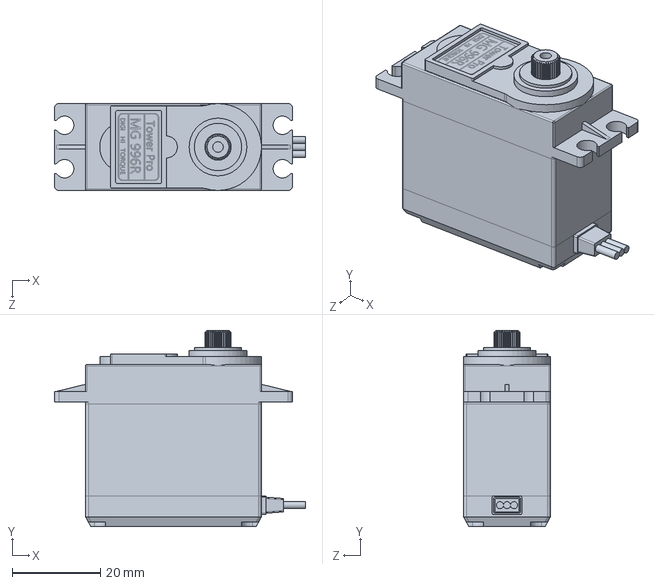
[picture p44: CAD file, 2026-10-10]
hardware/reference/cots_parts/servoMotorMG996R.SLDPRT
57.0 x 44.5 x 19.7 mm
