nguyenthanhthe/uet-robotic-arm/hardware/reference/cults3d_kuka/2.stl

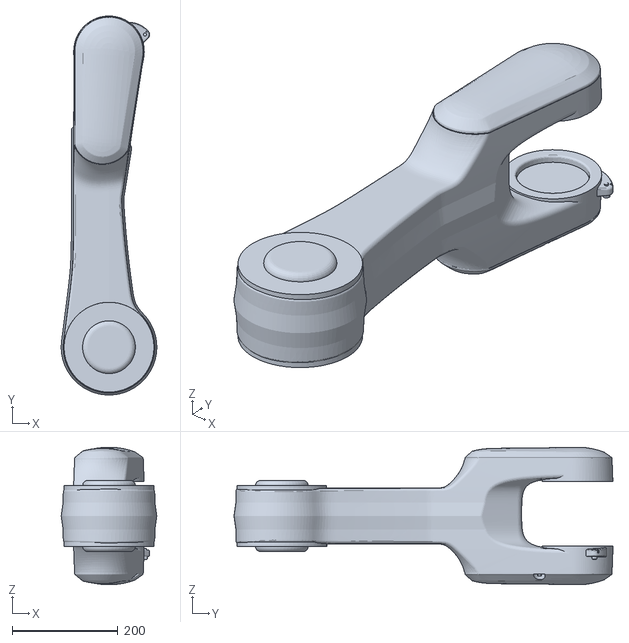
[picture p45: CAD file, 2026-09-27]
hardware/reference/cults3d_kuka/2.stl
180.9 x 717.2 x 260.1
