nguyenthanhthe/uet-robotic-arm/hardware/reference/Gripper Right[1].SLDPRT

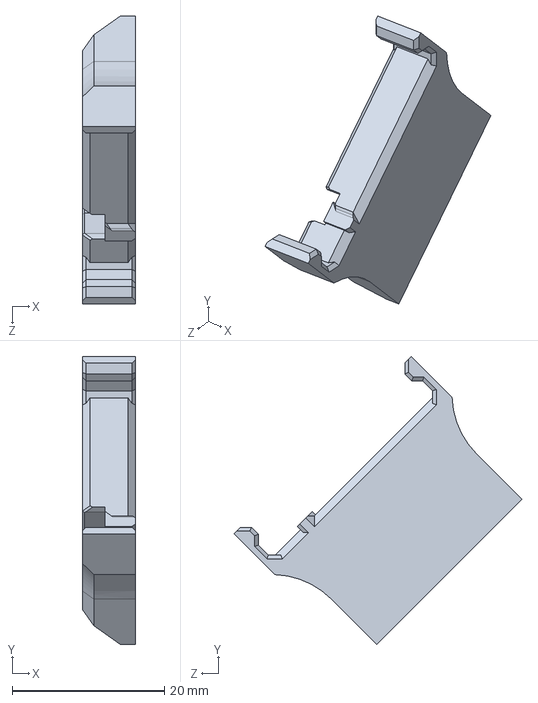
[picture p46: CAD file, 2026-09-25]
hardware/reference/Gripper Right[1].SLDPRT
7.00 x 37.9 x 37.9 mm
