nguyenthanhthe/uet-robotic-arm/cad/parts/06_Gripper_Base.SLDPRT

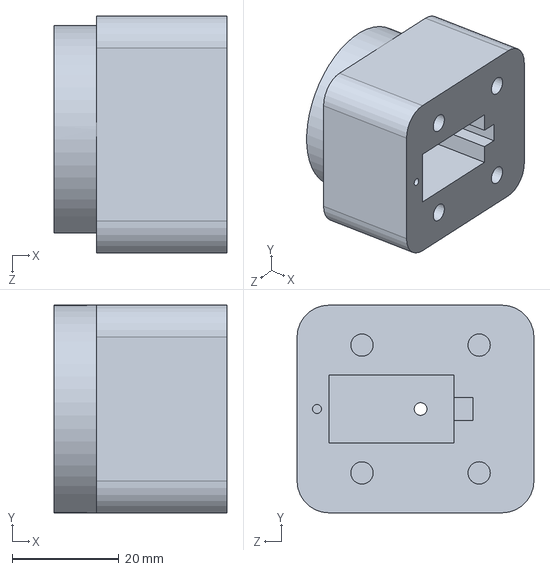
[picture p47: CAD file, 2026-10-11]
cad/parts/06_Gripper_Base.SLDPRT
32.4 x 39.0 x 44.5 mm
