nguyenthanhthe/uet-robotic-arm/hardware/reference/cots_parts/PCA9685_Servo_Shield.SLDPRT

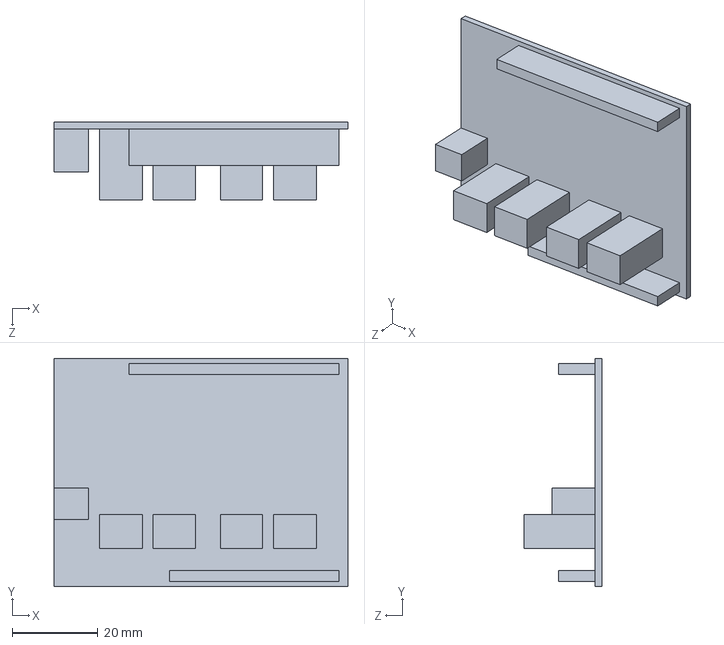
[picture p48: CAD file, 2026-10-10]
hardware/reference/cots_parts/PCA9685_Servo_Shield.SLDPRT
68.6 x 53.3 x 18.1 mm
