nguyenthanhthe/uet-robotic-arm/hardware/reference/cults3d_kuka/4.stl

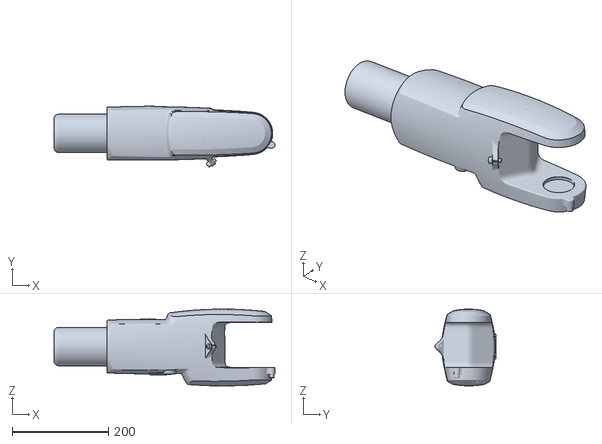
[picture p49: CAD file, 2026-09-27]
hardware/reference/cults3d_kuka/4.stl
458.5 x 127.0 x 159.5
