nguyenthanhthe/uet-robotic-arm/cad/parts/06_Gripper_Jaw.SLDPRT

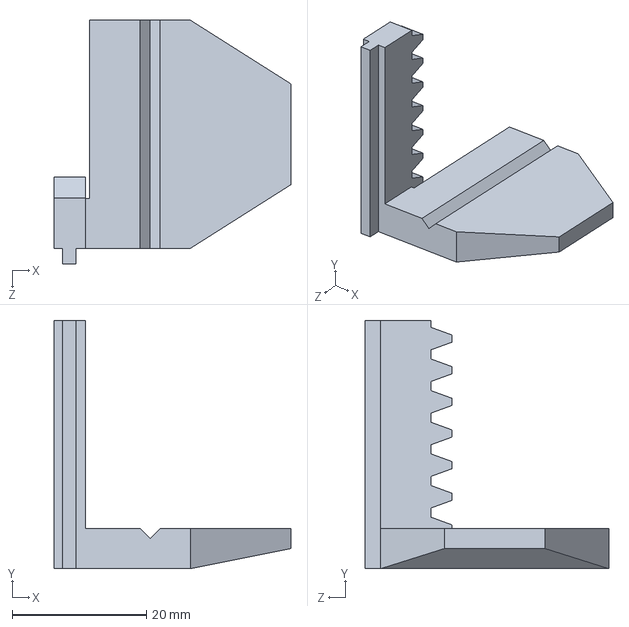
[picture p50: CAD file, 2026-10-11]
cad/parts/06_Gripper_Jaw.SLDPRT
35.3 x 37.0 x 36.3 mm
