nguyenthanhthe/uet-robotic-arm/hardware/reference/cots_parts/DS3225SG 25KG + Its Horns.STEP

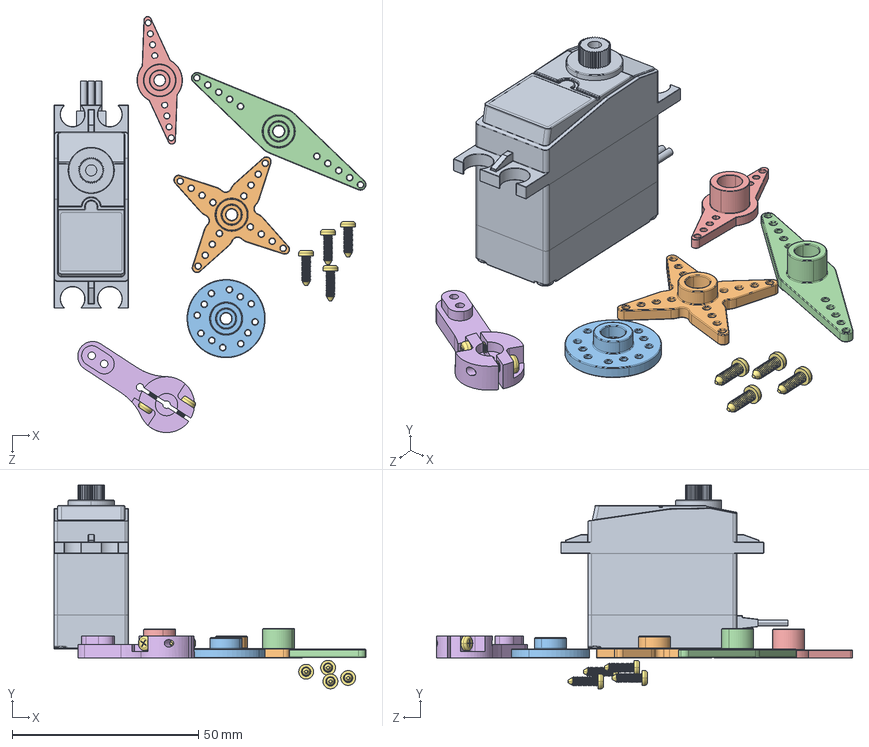
[picture p51: CAD file, 2026-10-10]
hardware/reference/cots_parts/DS3225SG 25KG + Its Horns.STEP
83.8 x 54.7 x 111.7 mm
DS3225SG 25KG
Star-Shaped Servo Horn
Circular Servo Horn
Dual Arm Servo Horn
Single Arm Servo Horn
Metal Servo Arm
M2X8 x 6
