nguyenthanhthe/uet-robotic-arm/hardware/reference/cults3d_kuka/6.stl

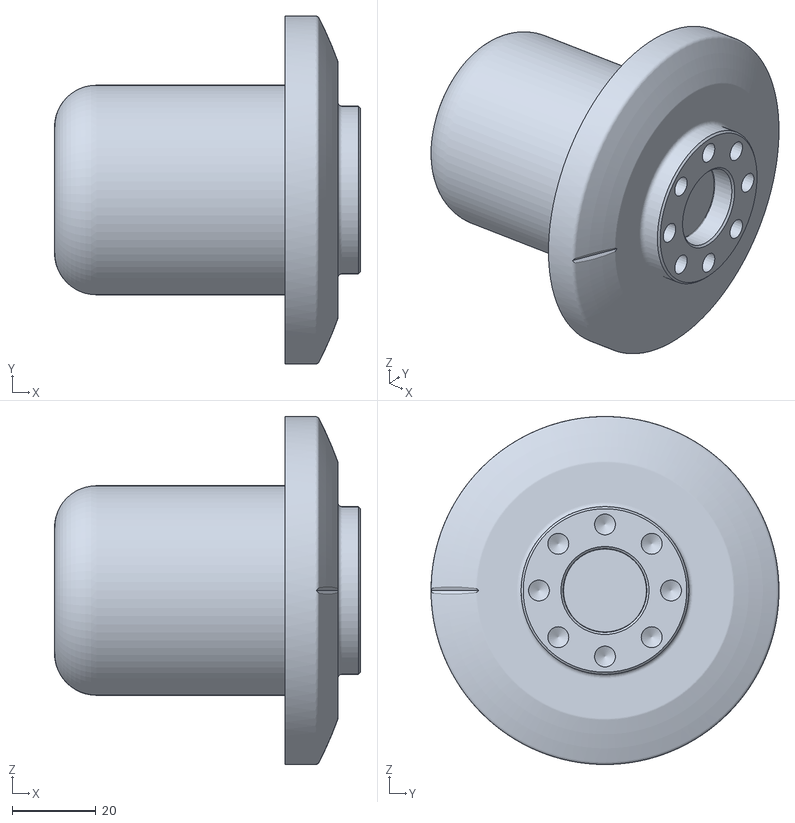
[picture p52: CAD file, 2026-09-27]
hardware/reference/cults3d_kuka/6.stl
73.0 x 83.0 x 83.0
