nguyenthanhthe/uet-robotic-arm/hardware/reference/Shoulder Ring[1].SLDPRT

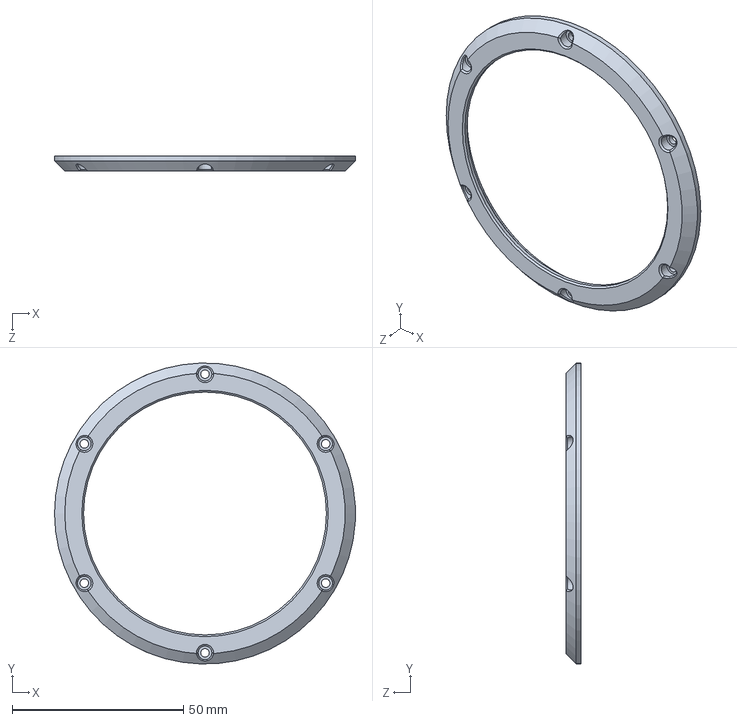
[picture p53: CAD file, 2026-09-25]
hardware/reference/Shoulder Ring[1].SLDPRT
88.0 x 88.0 x 4.50 mm
