nguyenthanhthe/uet-robotic-arm/hardware/reference/v2rad_parts/Pulley Servo Horn[1].SLDPRT

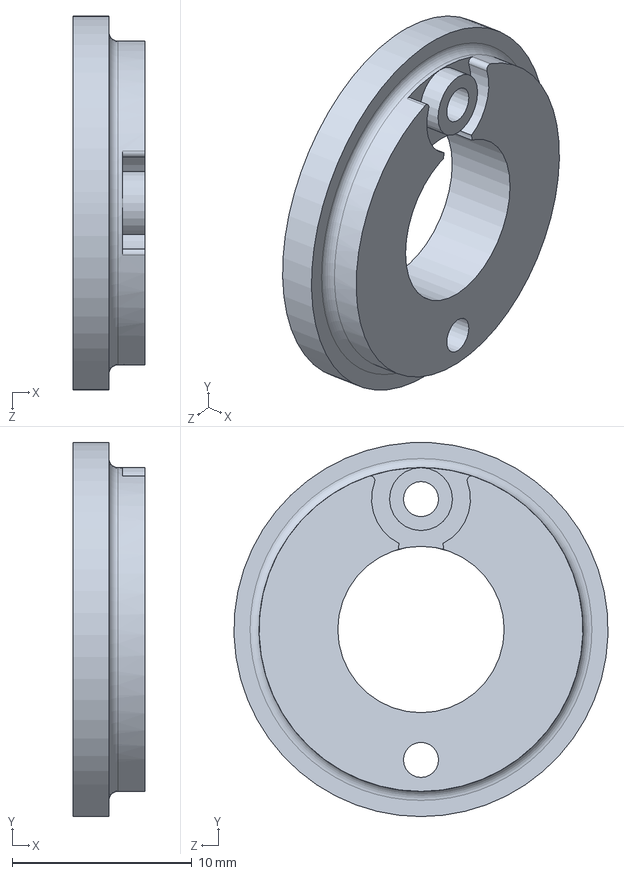
[picture p54: CAD file, 2026-09-27]
hardware/reference/v2rad_parts/Pulley Servo Horn[1].SLDPRT
4.00 x 20.8 x 20.8 mm
