nguyenthanhthe/uet-robotic-arm/cad/exports/v2rad/step/Controller-Plug-Cover.step

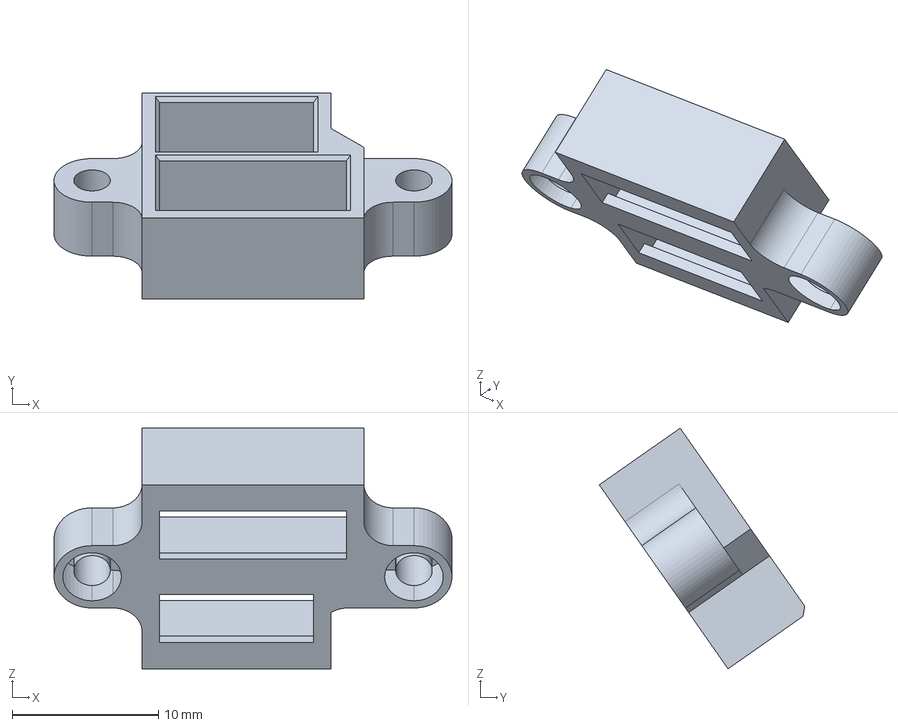
[picture p55: CAD file, 2026-09-25]
cad/exports/v2rad/step/Controller-Plug-Cover.step
27.2 x 14.0 x 16.4 mm
