nguyenthanhthe/uet-robotic-arm/cad/parts/04_Forearm_CoverPivot.SLDPRT

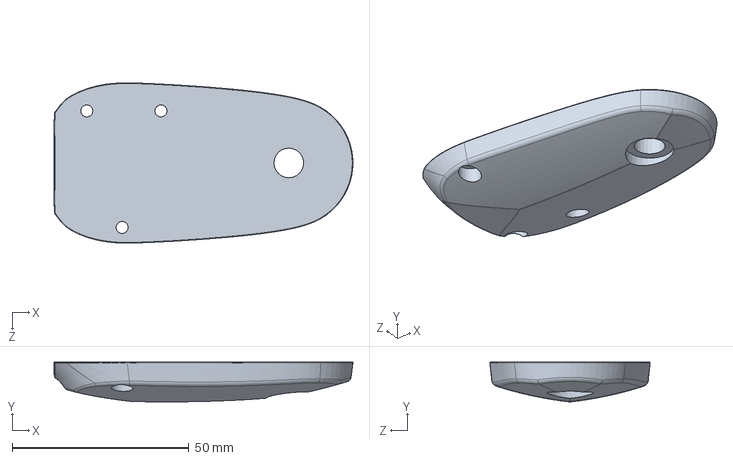
[picture p56: CAD file, 2026-10-11]
cad/parts/04_Forearm_CoverPivot.SLDPRT
84.7 x 11.3 x 45.4 mm
