nguyenthanhthe/uet-robotic-arm/hardware/reference/cots_parts/MG90S_body.SLDPRT

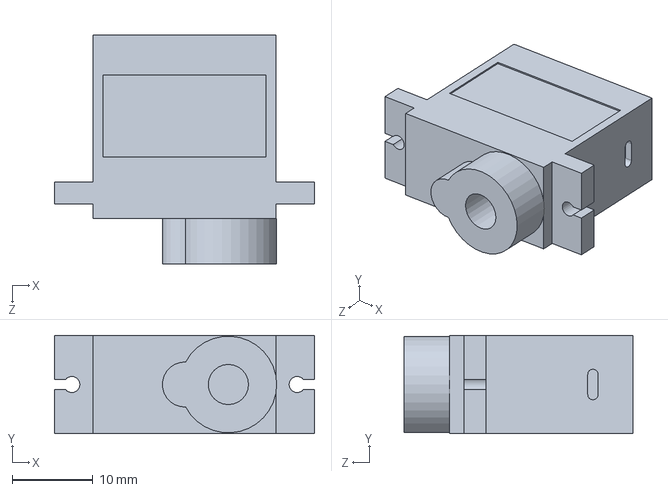
[picture p57: CAD file, 2026-10-10]
hardware/reference/cots_parts/MG90S_body.SLDPRT
32.3 x 12.2 x 28.5 mm
