nguyenthanhthe/uet-robotic-arm/hardware/reference/cults3d_kuka/1.stl

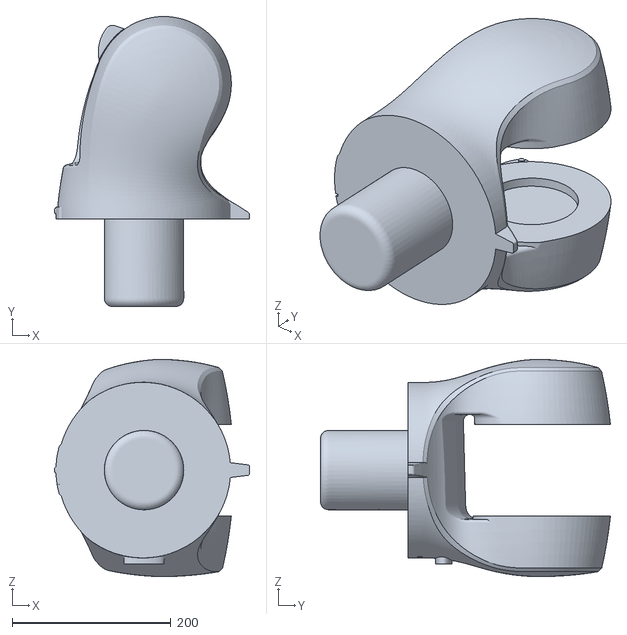
[picture p58: CAD file, 2026-09-27]
hardware/reference/cults3d_kuka/1.stl
246.0 x 365.3 x 273.7
