nguyenthanhthe/uet-robotic-arm/hardware/reference/v2rad-all-parts.step.SLDPRT

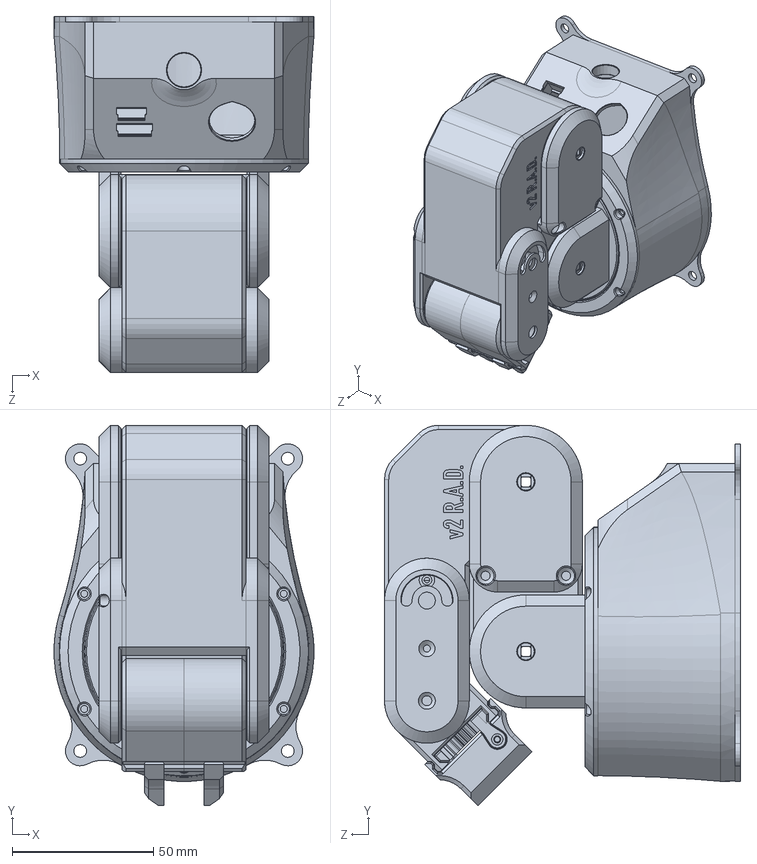
[picture p59: CAD file, 2026-09-25]
hardware/reference/v2rad-all-parts.step.SLDPRT
92.0 x 134.6 x 125.9 mm
