nguyenthanhthe/uet-robotic-arm/hardware/reference/v2rad_parts/Gripper Rack Left[1].SLDPRT

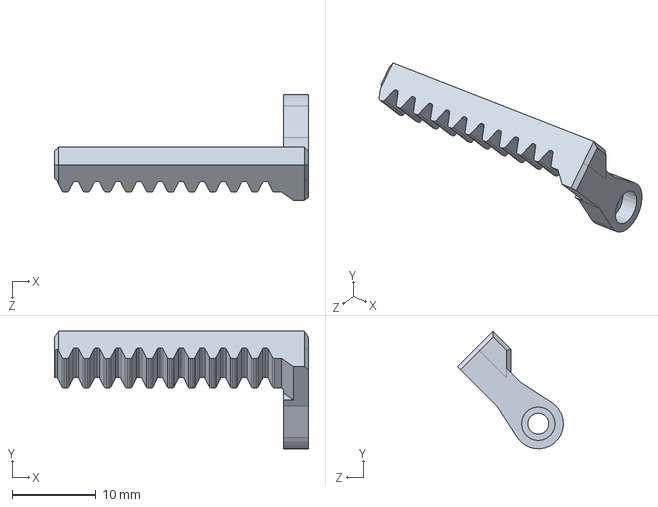
[picture p60: CAD file, 2026-09-27]
hardware/reference/v2rad_parts/Gripper Rack Left[1].SLDPRT
30.3 x 14.0 x 12.6 mm
