nguyenthanhthe/uet-robotic-arm/cad/parts/03_J2_BearingSpacer.SLDPRT

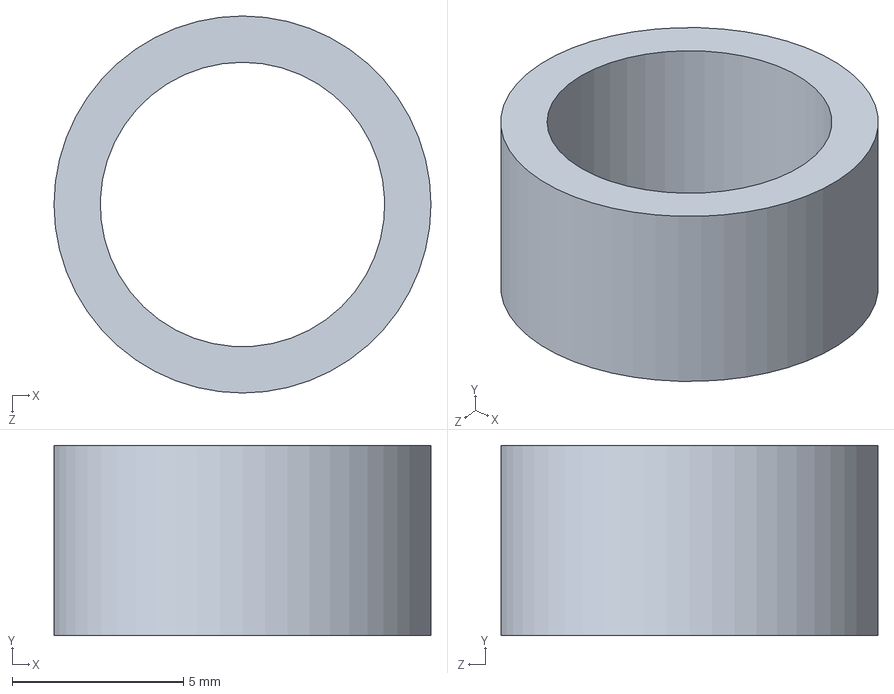
[picture p61: CAD file, 2026-10-11]
cad/parts/03_J2_BearingSpacer.SLDPRT
11.0 x 5.55 x 11.0 mm
