nguyenthanhthe/uet-robotic-arm/hardware/reference/Base Cover[1].SLDPRT

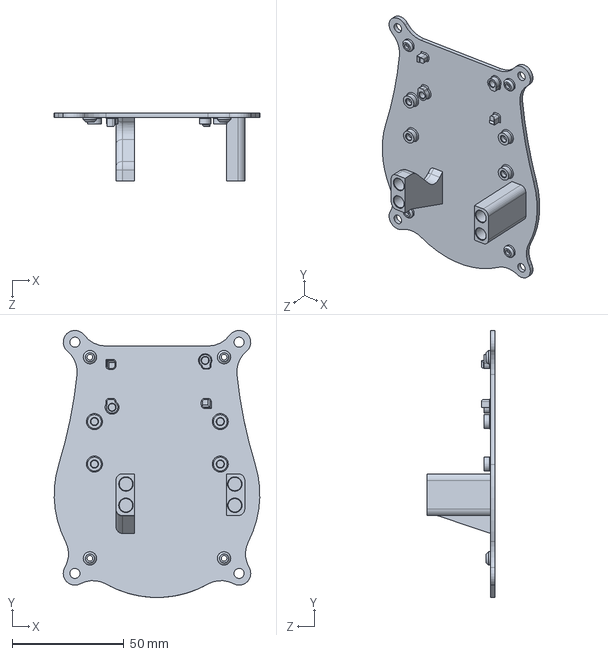
[picture p62: CAD file, 2026-09-25]
hardware/reference/Base Cover[1].SLDPRT
92.0 x 119.4 x 30.5 mm
