nguyenthanhthe/uet-robotic-arm/hardware/reference/cots_parts/DS3225SG.SLDPRT

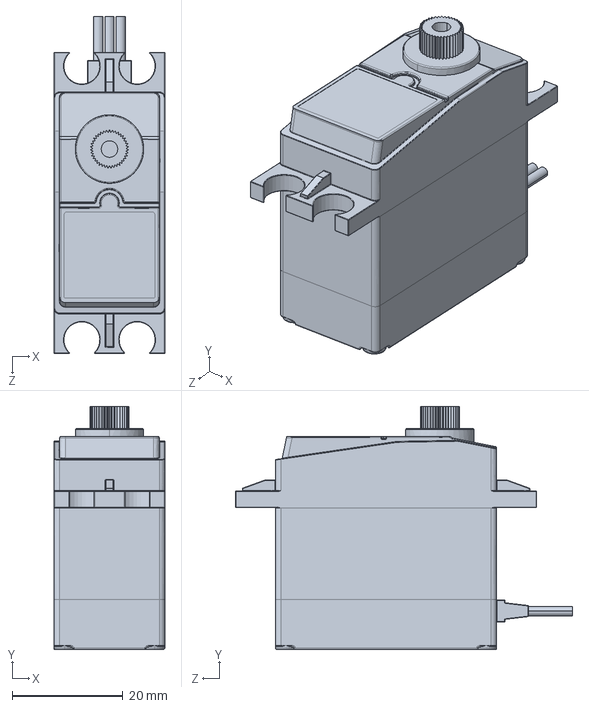
[picture p63: CAD file, 2026-10-10]
hardware/reference/cots_parts/DS3225SG.SLDPRT
20.0 x 44.0 x 61.0 mm
