nguyenthanhthe/uet-robotic-arm/hardware/reference/v2rad_parts/Wrist Right[1].SLDPRT

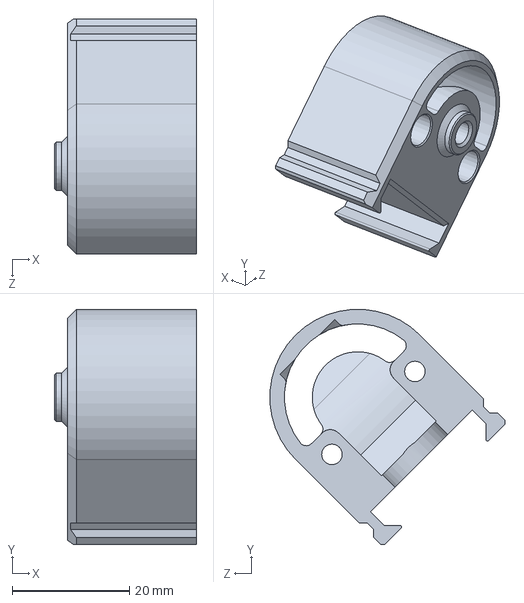
[picture p64: CAD file, 2026-09-27]
hardware/reference/v2rad_parts/Wrist Right[1].SLDPRT
24.2 x 40.1 x 40.1 mm
