nguyenthanhthe/uet-robotic-arm/cad/parts/01_Base_Tray.SLDPRT

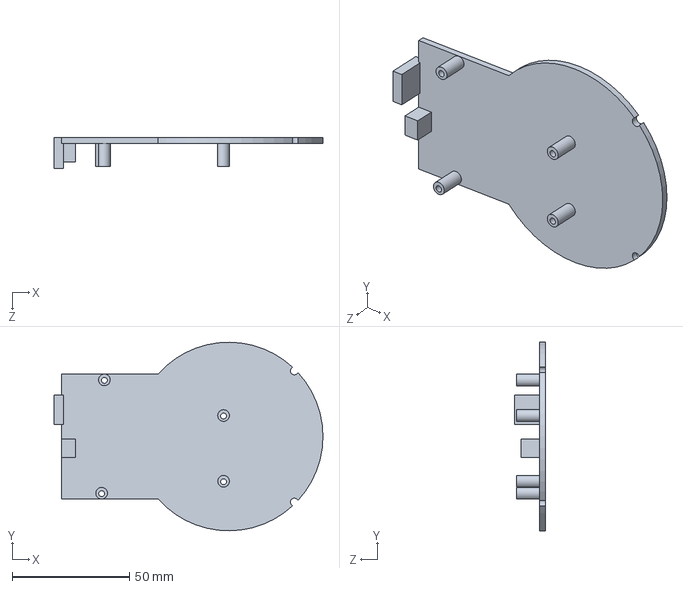
[picture p65: CAD file, 2026-10-11]
cad/parts/01_Base_Tray.SLDPRT
114.7 x 80.4 x 13.3 mm
