nguyenthanhthe/uet-robotic-arm/hardware/reference/Shoulder Right[1].SLDPRT

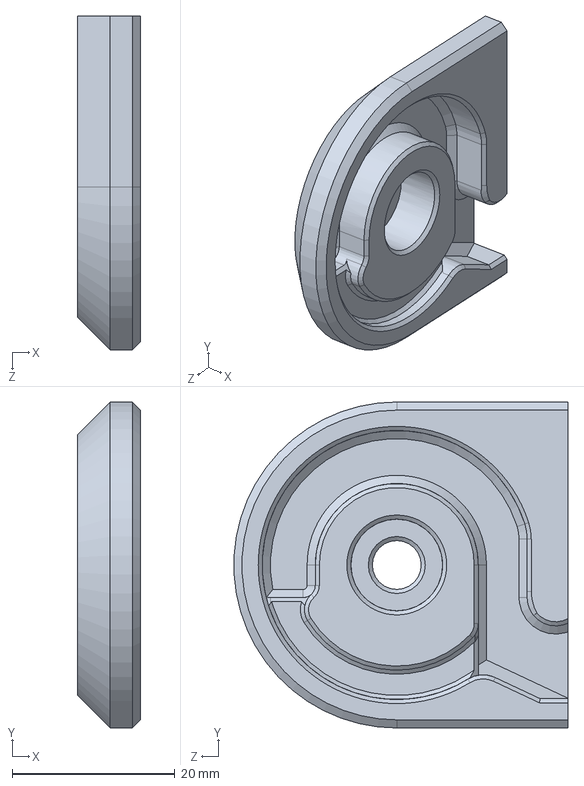
[picture p66: CAD file, 2026-09-25]
hardware/reference/Shoulder Right[1].SLDPRT
7.75 x 40.0 x 41.0 mm
