nguyenthanhthe/uet-robotic-arm/hardware/reference/v2rad_parts/Shoulder Base[1].SLDPRT

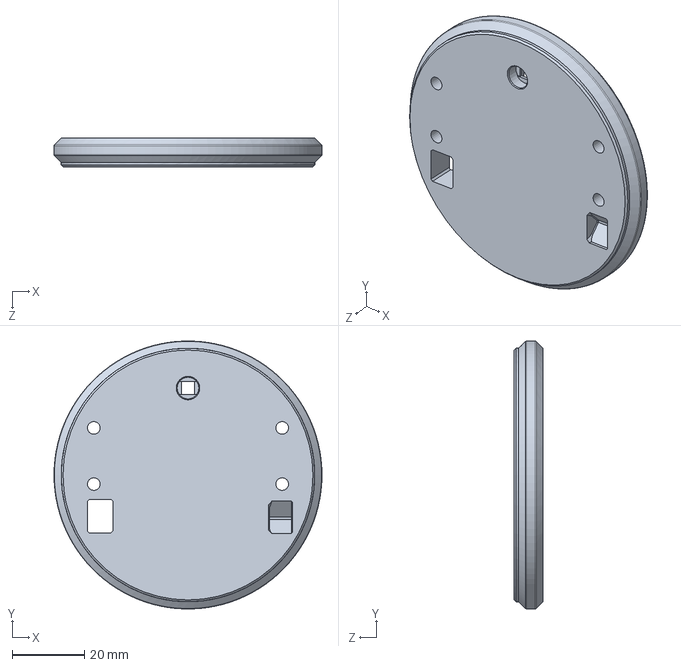
[picture p67: CAD file, 2026-09-27]
hardware/reference/v2rad_parts/Shoulder Base[1].SLDPRT
74.0 x 74.0 x 8.00 mm
