nguyenthanhthe/uet-robotic-arm/cad/exports/v2rad/step/Shoulder-Left.step

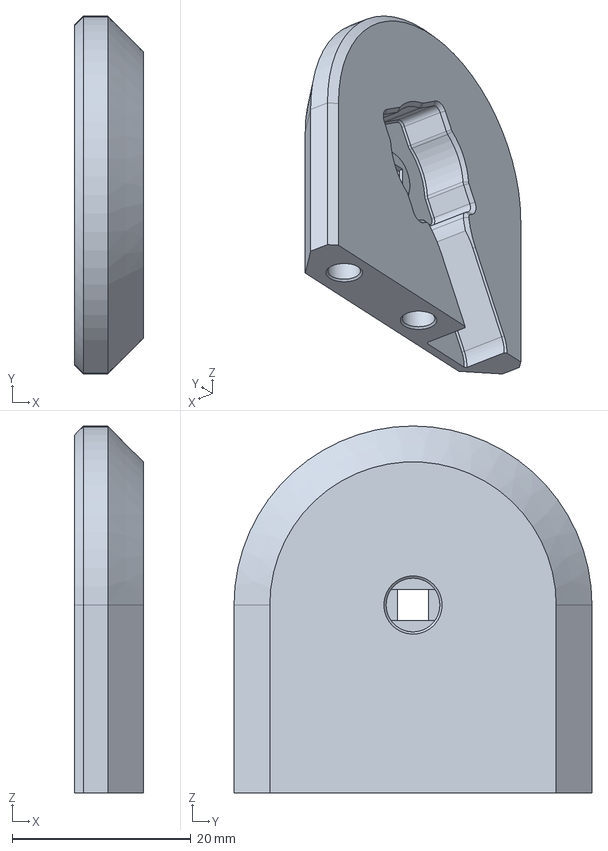
[picture p68: CAD file, 2026-09-25]
cad/exports/v2rad/step/Shoulder-Left.step
7.75 x 40.0 x 41.0 mm
