nguyenthanhthe/uet-robotic-arm/cad/parts/04_Forearm_ForkKuka.SLDPRT

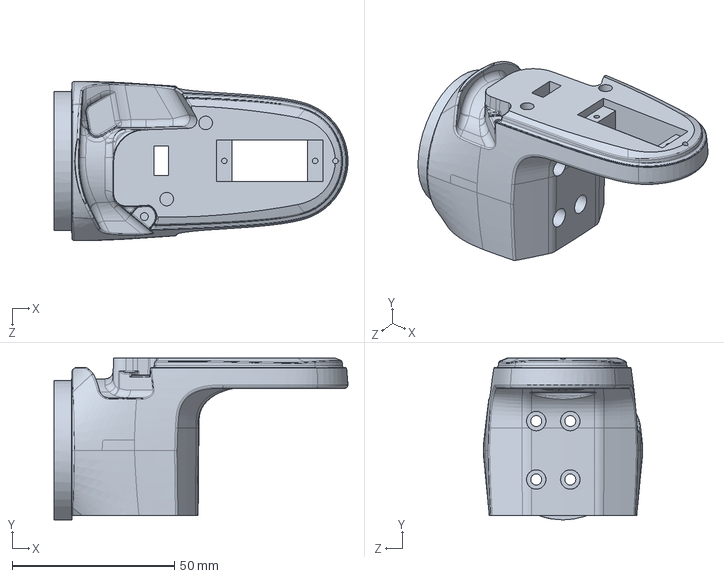
[picture p69: CAD file, 2026-10-11]
cad/parts/04_Forearm_ForkKuka.SLDPRT
90.6 x 49.9 x 49.2 mm
