nguyenthanhthe/uet-robotic-arm/hardware/reference/Forearm Right[1].SLDPRT

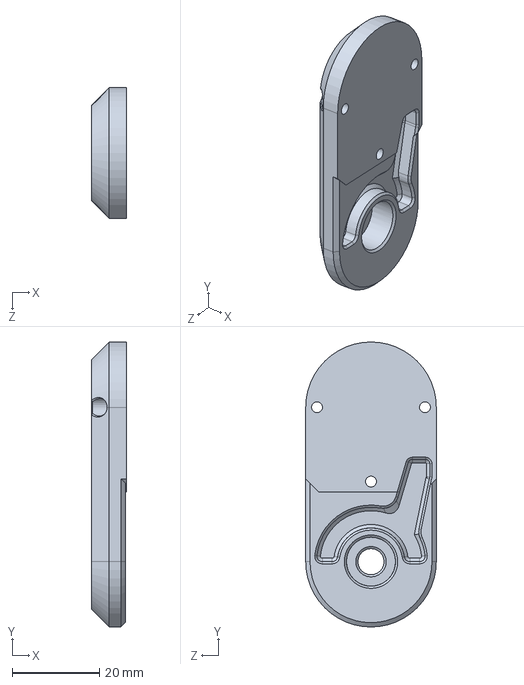
[picture p70: CAD file, 2026-09-25]
hardware/reference/Forearm Right[1].SLDPRT
8.00 x 65.5 x 30.0 mm
