nguyenthanhthe/uet-robotic-arm/hardware/reference/v2rad_parts/Shoulder Left[1].SLDPRT

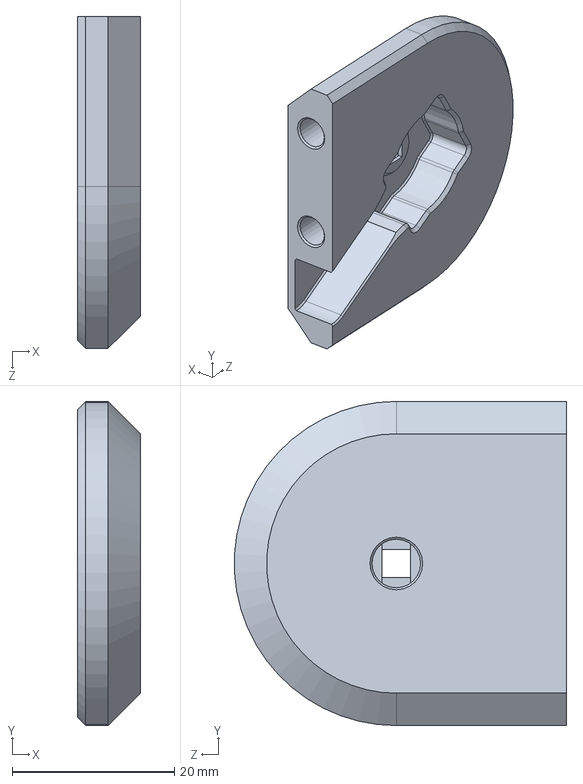
[picture p71: CAD file, 2026-09-27]
hardware/reference/v2rad_parts/Shoulder Left[1].SLDPRT
7.75 x 40.0 x 41.0 mm
