nguyenthanhthe/uet-robotic-arm/cad/parts/03_UpperArmKuka.SLDPRT

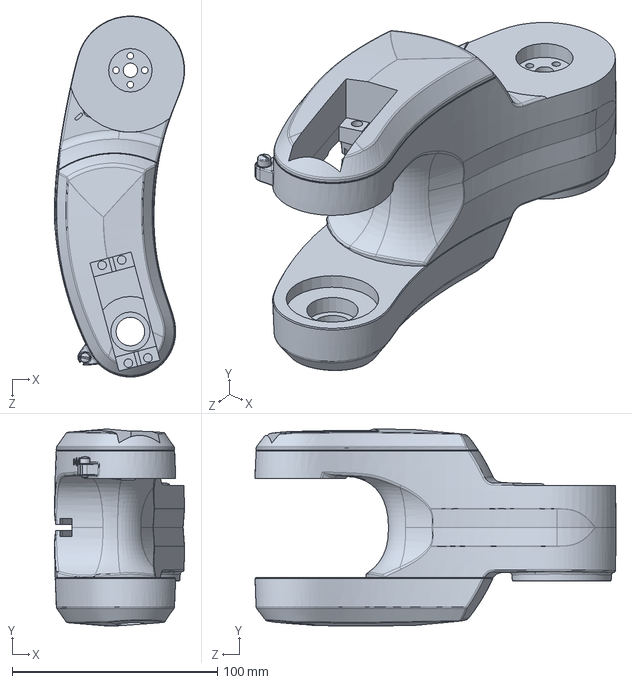
[picture p72: CAD file, 2026-10-11]
cad/parts/03_UpperArmKuka.SLDPRT
63.4 x 96.0 x 176.0 mm
