nguyenthanhthe/uet-robotic-arm/hardware/reference/cots_parts/bergE5F4F25F1bc4[3].SLDPRT

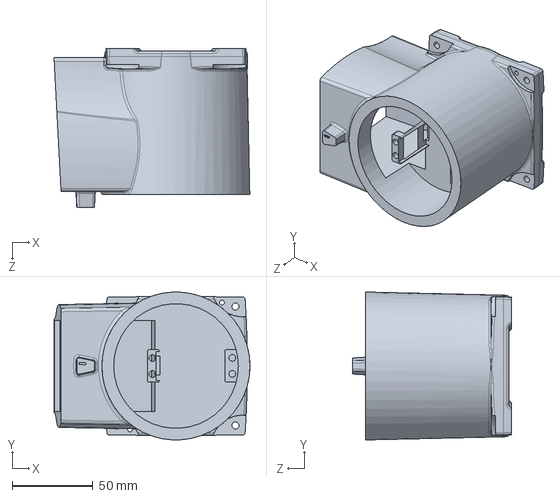
[picture p73: CAD file, 2026-09-27]
hardware/reference/cots_parts/bergE5F4F25F1bc4[3].SLDPRT
121.1 x 91.4 x 98.0 mm
