nguyenthanhthe/uet-robotic-arm/hardware/reference/v2rad_parts/Controller Plug Cover[1].SLDPRT

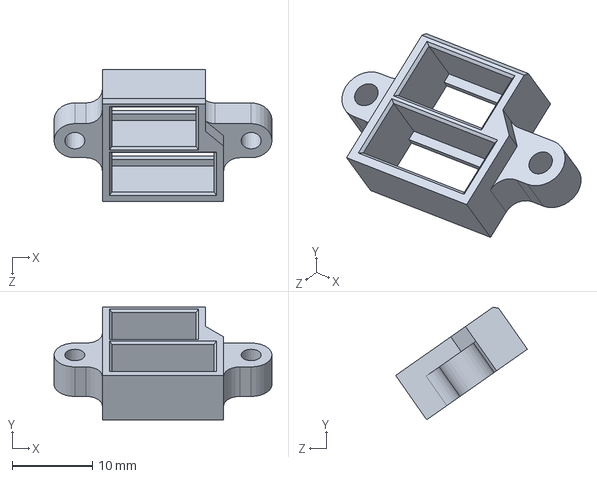
[picture p74: CAD file, 2026-09-27]
hardware/reference/v2rad_parts/Controller Plug Cover[1].SLDPRT
27.2 x 14.0 x 16.4 mm
