nguyenthanhthe/uet-robotic-arm/cad/exports/v2rad/step/Forearm-Cover.step

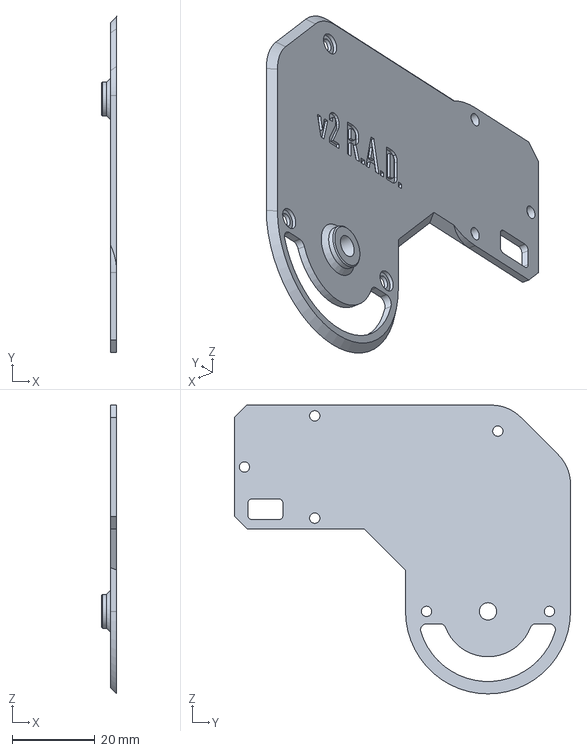
[picture p75: CAD file, 2026-09-25]
cad/exports/v2rad/step/Forearm-Cover.step
3.75 x 81.5 x 70.0 mm
