nguyenthanhthe/uet-robotic-arm/cad/parts/05_WristKuka.SLDPRT

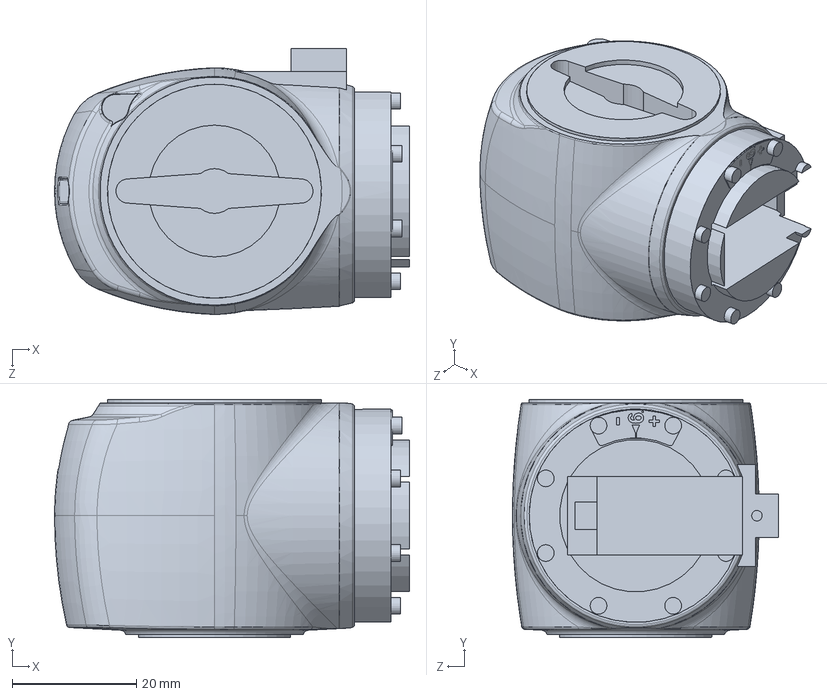
[picture p76: CAD file, 2026-10-11]
cad/parts/05_WristKuka.SLDPRT
57.1 x 38.3 x 42.8 mm
