nguyenthanhthe/uet-robotic-arm/hardware/reference/cots_parts/Part4.SLDPRT

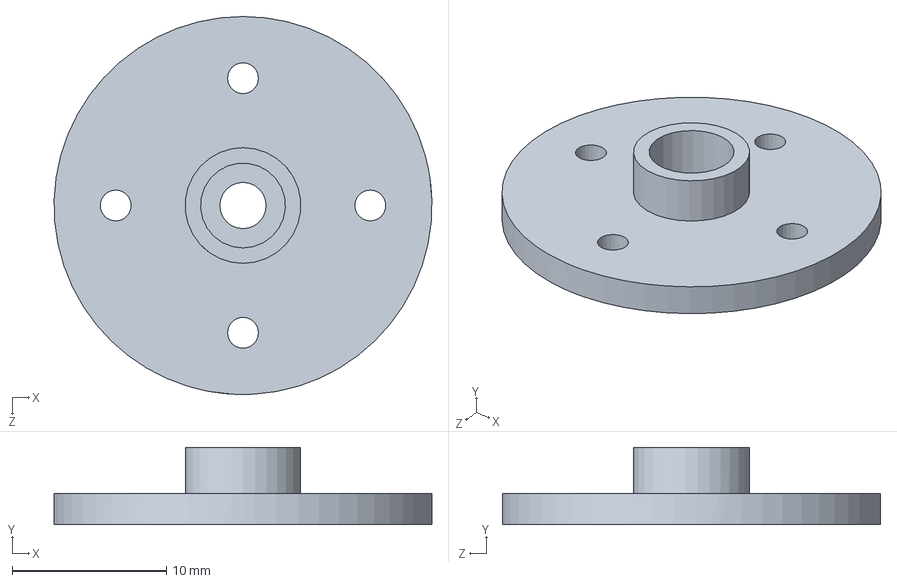
[picture p77: CAD file, 2026-09-27]
hardware/reference/cots_parts/Part4.SLDPRT
24.5 x 5.00 x 24.5 mm
