nguyenthanhthe/uet-robotic-arm/hardware/reference/v2rad_parts/Wrist Left[1].SLDPRT

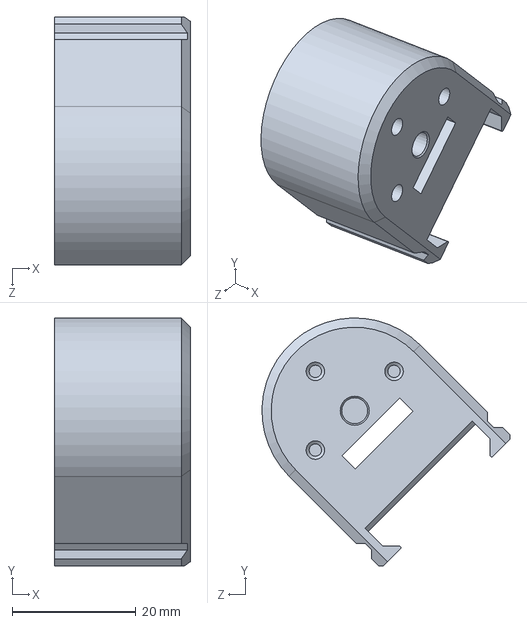
[picture p78: CAD file, 2026-09-27]
hardware/reference/v2rad_parts/Wrist Left[1].SLDPRT
22.0 x 40.1 x 40.1 mm
