nguyenthanhthe/uet-robotic-arm/cad/parts/06_Gripper_Pinion.SLDPRT

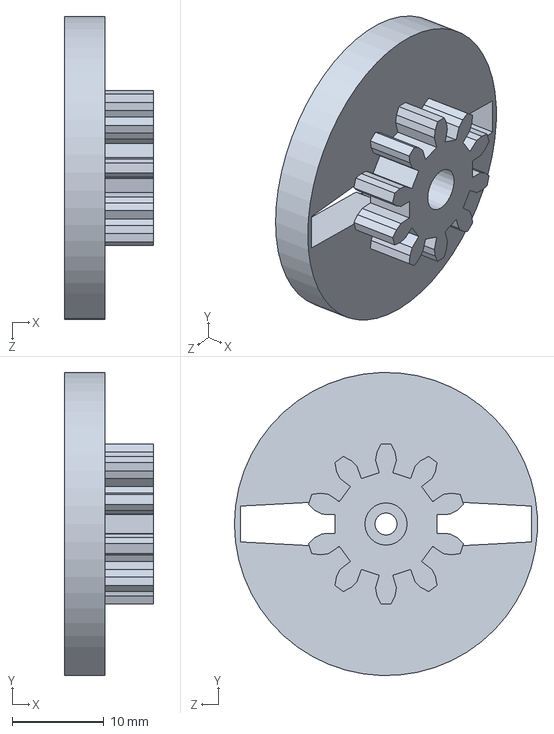
[picture p79: CAD file, 2026-10-11]
cad/parts/06_Gripper_Pinion.SLDPRT
9.70 x 33.0 x 33.0 mm
