nguyenthanhthe/uet-robotic-arm/cad/parts/06_Gripper_Guide.SLDPRT

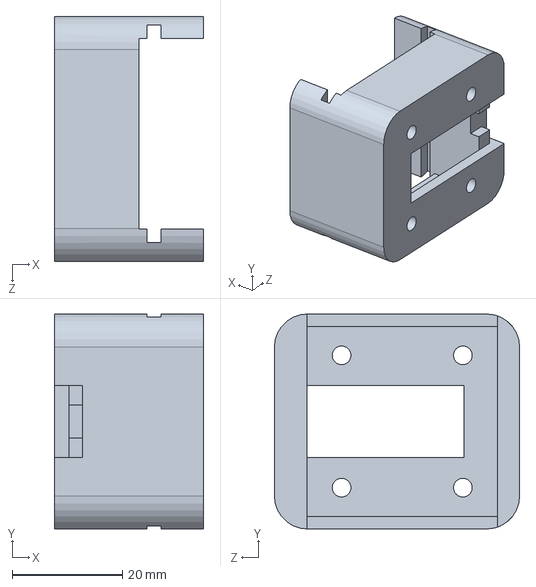
[picture p80: CAD file, 2026-10-11]
cad/parts/06_Gripper_Guide.SLDPRT
27.1 x 39.0 x 44.5 mm
