nguyenthanhthe/uet-robotic-arm/cad/parts/04_J4_PivotPin.SLDPRT

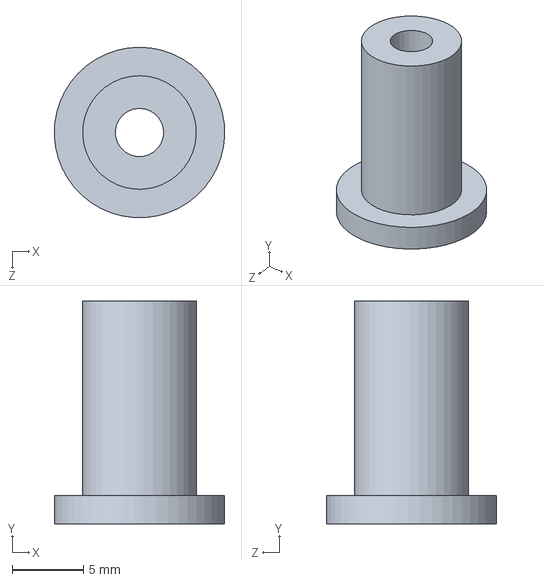
[picture p81: CAD file, 2026-10-10]
cad/parts/04_J4_PivotPin.SLDPRT
12.0 x 15.7 x 12.0 mm
