nguyenthanhthe/uet-robotic-arm/cad/parts/KR3 R540.SLDPRT

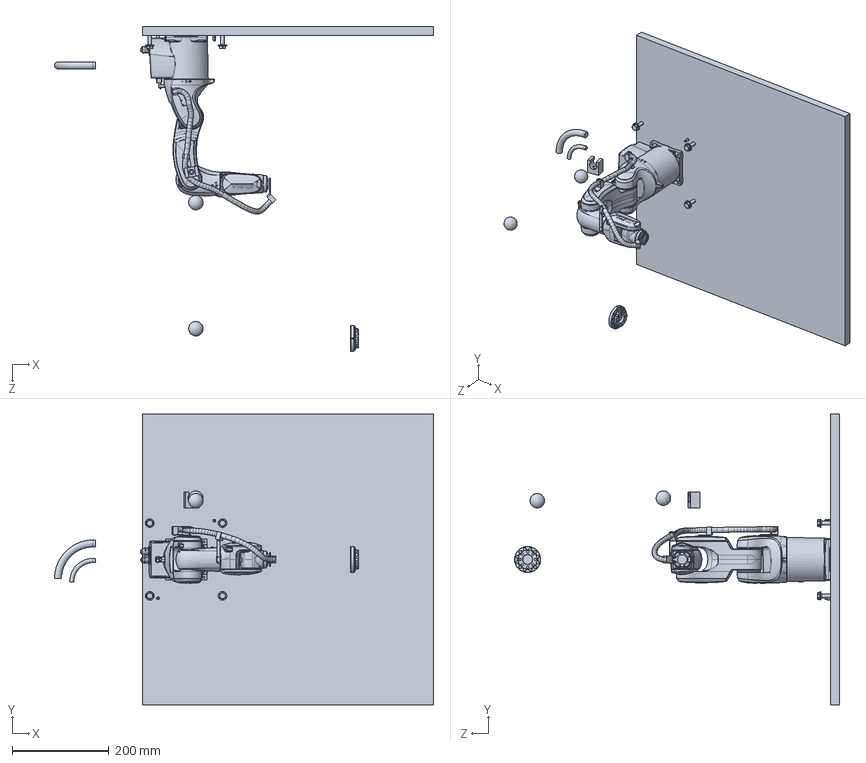
[picture p82: CAD file, 2026-10-10]
cad/parts/KR3 R540.SLDPRT
781.5 x 600.0 x 670.0 mm
