nguyenthanhthe/uet-robotic-arm/hardware/reference/cots_parts/MG90S Servo Horn (4 spork).step

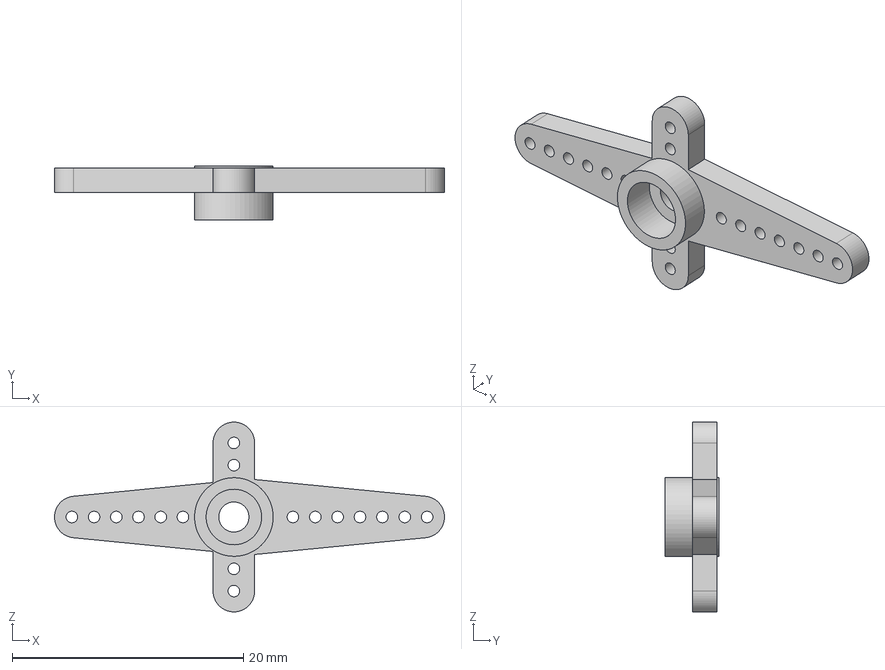
[picture p83: CAD file, 2026-09-27]
hardware/reference/cots_parts/MG90S Servo Horn (4 spork).step
33.7 x 4.70 x 16.4 mm
