nguyenthanhthe/uet-robotic-arm/cad/parts/02_Turret_BaseDisc.SLDPRT

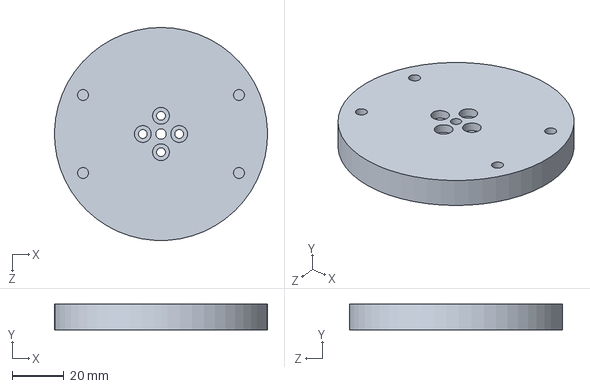
[picture p84: CAD file, 2026-10-10]
cad/parts/02_Turret_BaseDisc.SLDPRT
82.0 x 10.0 x 82.0 mm
