nguyenthanhthe/uet-robotic-arm/hardware/reference/cots_parts/KR3 R540.stp

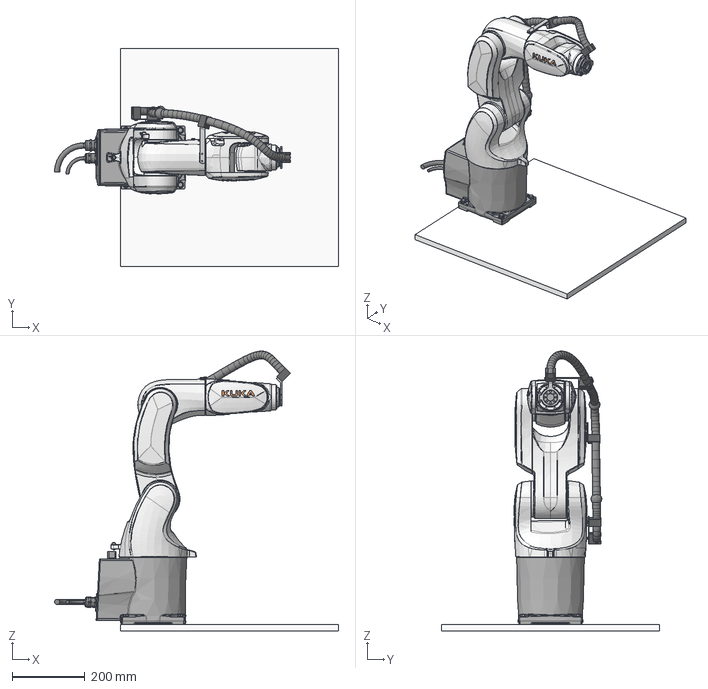
[picture p85: CAD file, 2026-09-27]
hardware/reference/cots_parts/KR3 R540.stp
781.5 x 600.0 x 770.3 mm
