nguyenthanhthe/uet-robotic-arm/cad/parts/Body3.SLDPRT

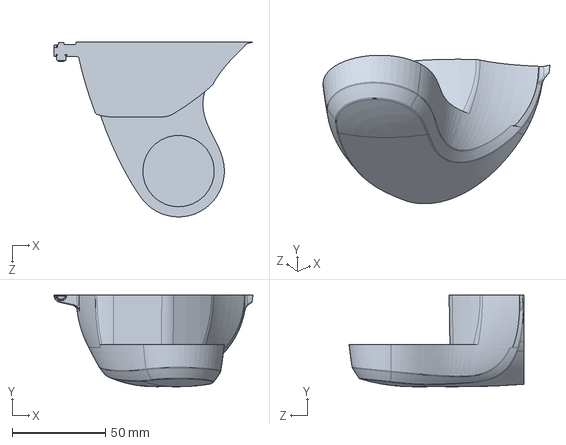
[picture p86: CAD file, 2026-10-10]
cad/parts/Body3.SLDPRT
106.5 x 49.0 x 93.6 mm
