nguyenthanhthe/uet-robotic-arm/hardware/reference/cots_parts/Arduino Uno.STEP

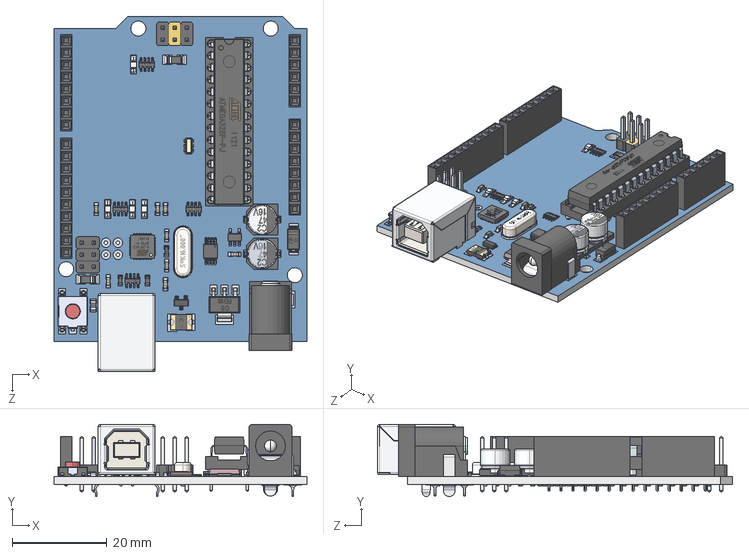
[picture p87: CAD file, 2026-09-27]
hardware/reference/cots_parts/Arduino Uno.STEP
53.3 x 15.3 x 74.9 mm
