nguyenthanhthe/uet-robotic-arm/cad/parts/Solid1[1].SLDPRT

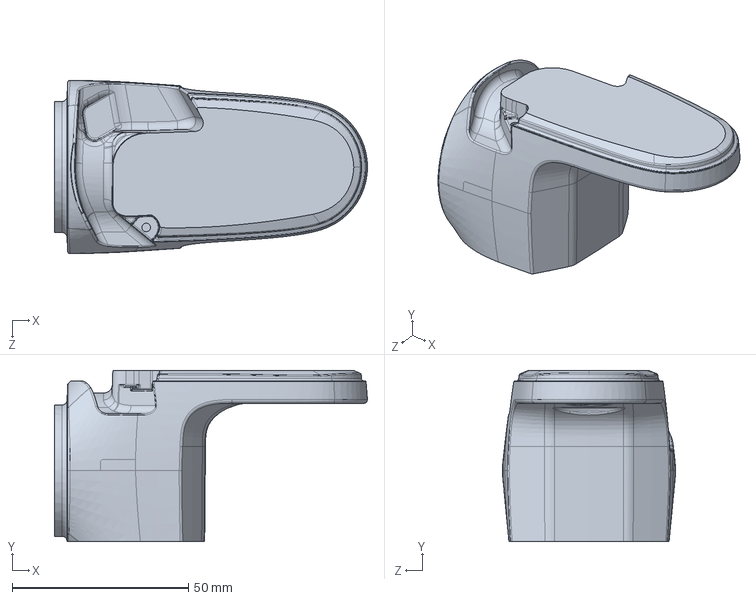
[picture p88: CAD file, 2026-10-10]
cad/parts/Solid1[1].SLDPRT
88.8 x 48.5 x 49.2 mm
