nguyenthanhthe/uet-robotic-arm/cad/exports/v2rad/step/Shoulder-Right.step

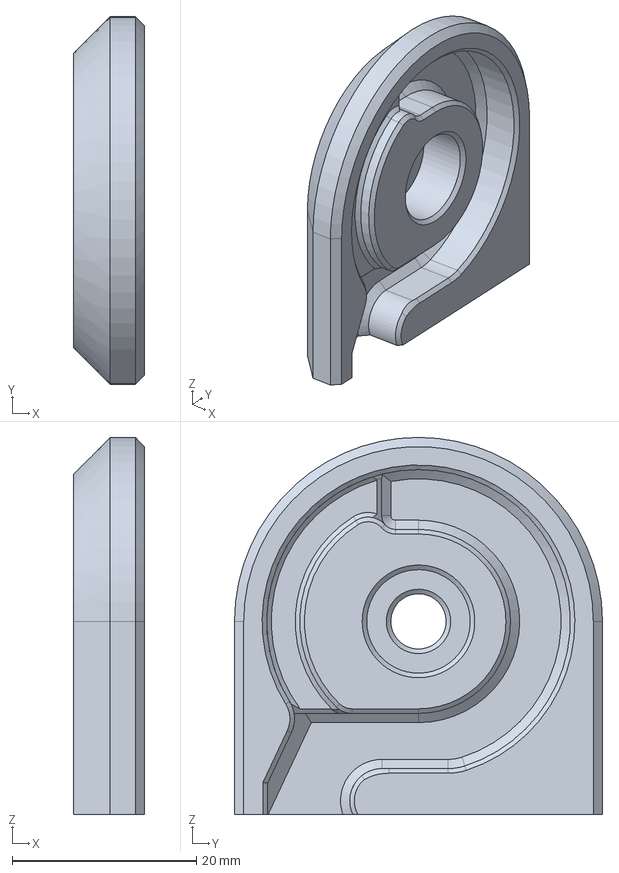
[picture p89: CAD file, 2026-09-25]
cad/exports/v2rad/step/Shoulder-Right.step
7.75 x 40.0 x 41.0 mm
