nguyenthanhthe/uet-robotic-arm/cad/parts/01_Base_Kuka.SLDPRT

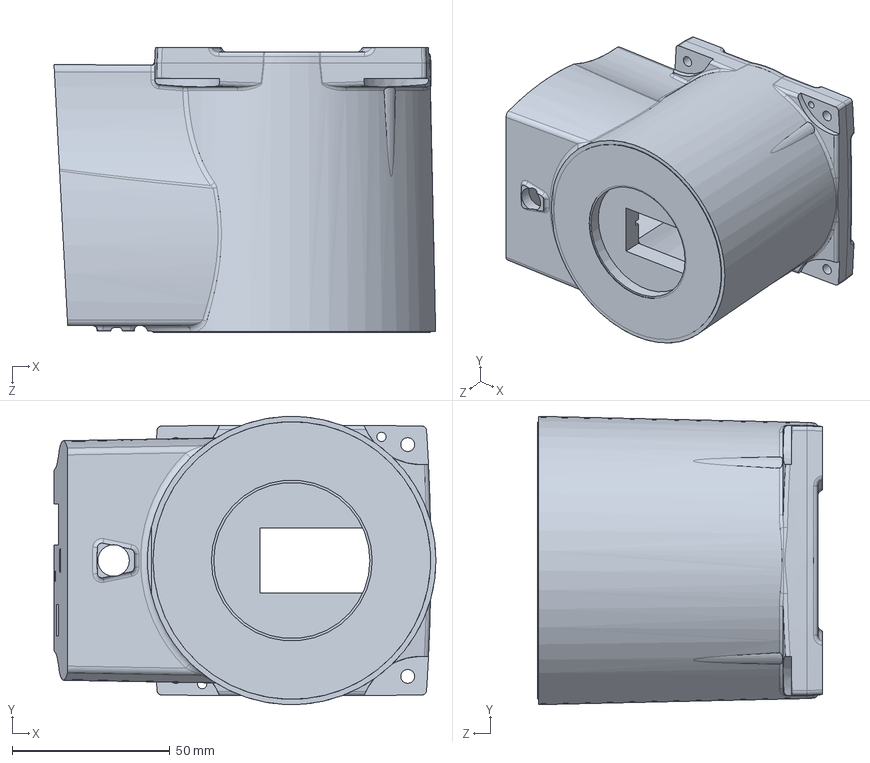
[picture p90: CAD file, 2026-10-10]
cad/parts/01_Base_Kuka.SLDPRT
121.1 x 91.4 x 90.4 mm
