nguyenthanhthe/uet-robotic-arm/hardware/reference/cots_parts/m3-insert-m3x574-insert.step

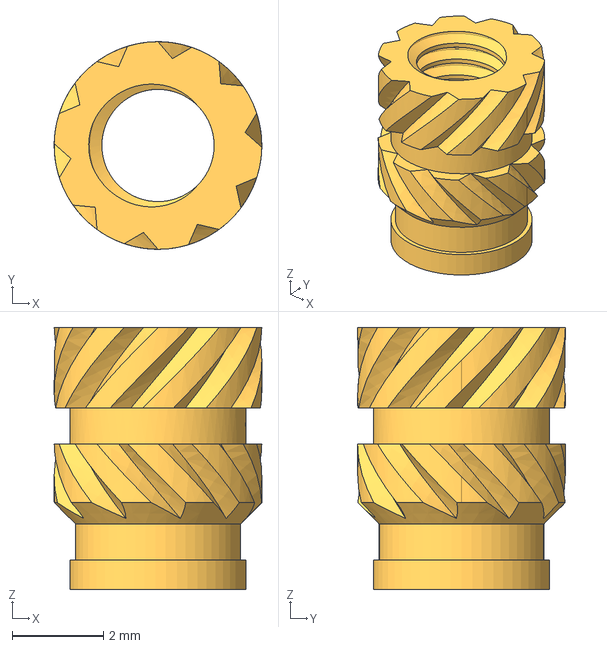
[picture p91: CAD file, 2026-09-27]
hardware/reference/cots_parts/m3-insert-m3x574-insert.step
4.55 x 4.55 x 5.74 mm
