nguyenthanhthe/uet-robotic-arm/cad/exports/v2rad/step/Base-Cover.step

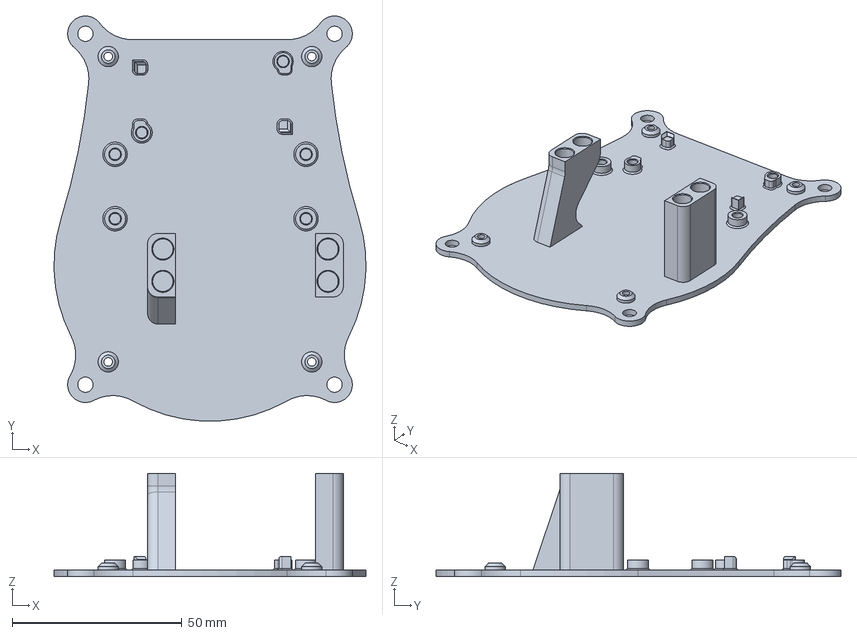
[picture p92: CAD file, 2026-09-25]
cad/exports/v2rad/step/Base-Cover.step
92.0 x 119.4 x 30.5 mm
