nguyenthanhthe/uet-robotic-arm/cad/parts/Part1.SLDPRT

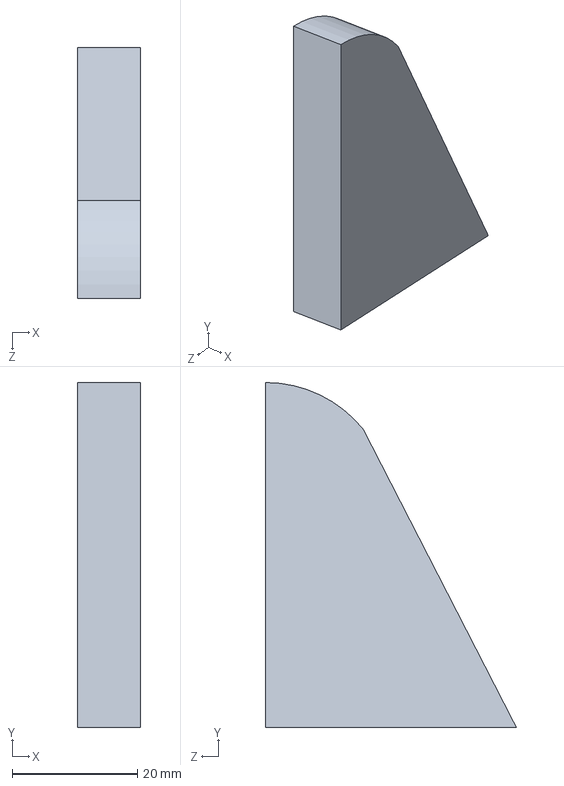
[picture p93: CAD file, 2026-10-10]
cad/parts/Part1.SLDPRT
10.0 x 55.0 x 40.0 mm
