nguyenthanhthe/uet-robotic-arm/hardware/reference/cots_parts/698zz Bearing.STEP

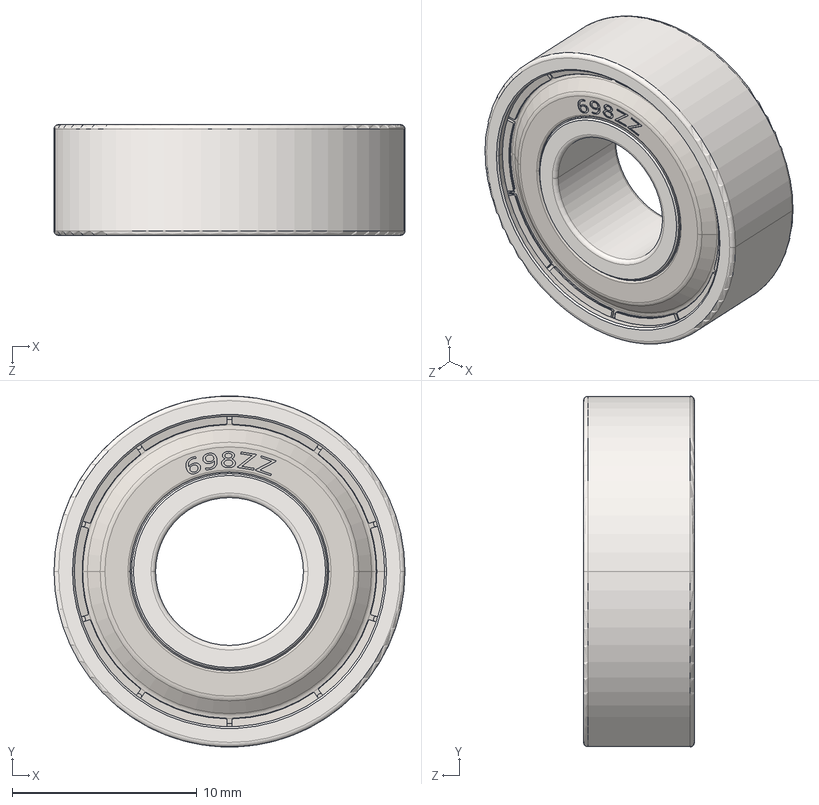
[picture p94: CAD file, 2026-09-27]
hardware/reference/cots_parts/698zz Bearing.STEP
19.0 x 19.0 x 6.00 mm
