nguyenthanhthe/uet-robotic-arm/hardware/reference/cots_parts/bergE5F4F25F1bc4[21].SLDPRT

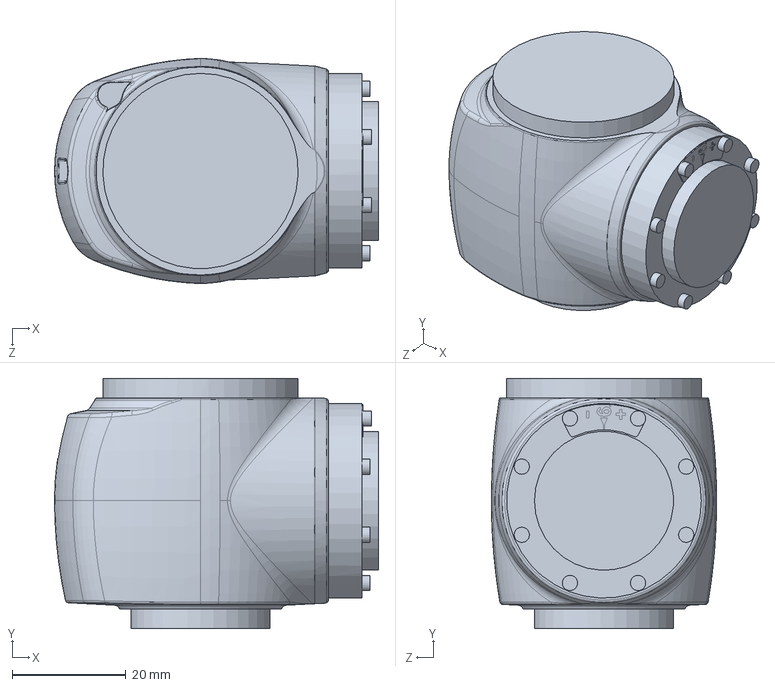
[picture p95: CAD file, 2026-09-27]
hardware/reference/cots_parts/bergE5F4F25F1bc4[21].SLDPRT
57.1 x 44.1 x 39.7 mm
