nguyenthanhthe/uet-robotic-arm/cad/parts/bergE5F4F25F1bc4[45].SLDPRT

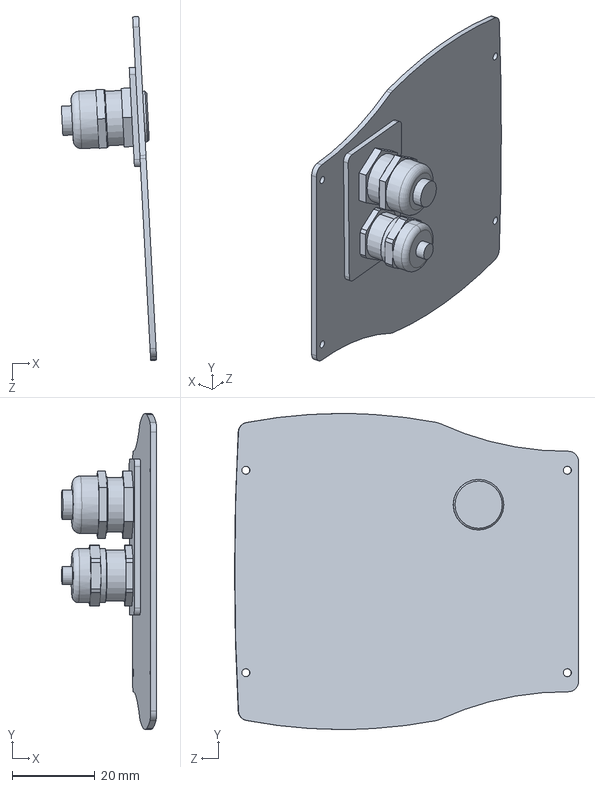
[picture p96: CAD file, 2026-10-10]
cad/parts/bergE5F4F25F1bc4[45].SLDPRT
23.1 x 76.5 x 83.3 mm
