nguyenthanhthe/uet-robotic-arm/cad/parts/04_Forearm_ElbowKuka.SLDPRT

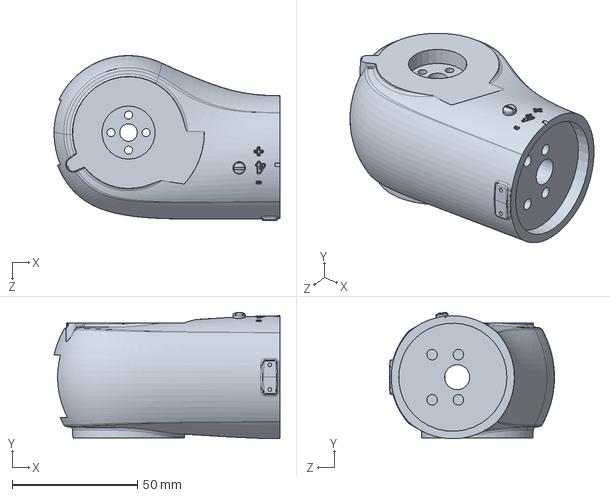
[picture p97: CAD file, 2026-10-10]
cad/parts/04_Forearm_ElbowKuka.SLDPRT
90.1 x 50.4 x 65.8 mm
