nguyenthanhthe/uet-robotic-arm/hardware/reference/cots_parts/bergE5F4F25F1bc4[22].SLDPRT

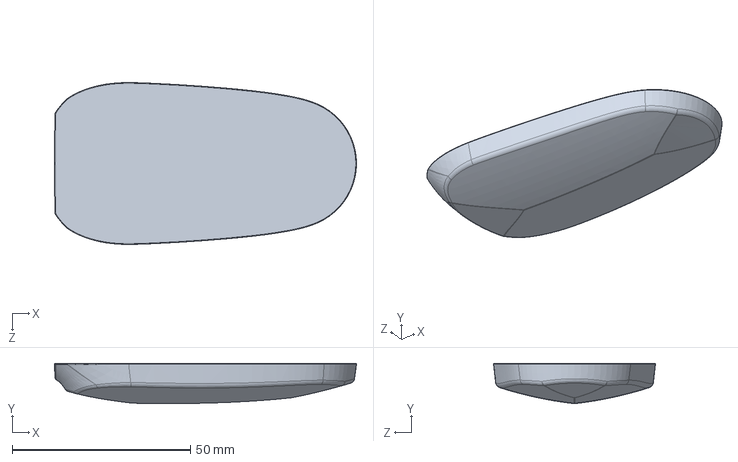
[picture p98: CAD file, 2026-09-27]
hardware/reference/cots_parts/bergE5F4F25F1bc4[22].SLDPRT
84.7 x 11.3 x 45.4 mm
