nguyenthanhthe/uet-robotic-arm/cad/parts/bergE5F4F25F1bc4[18].SLDPRT

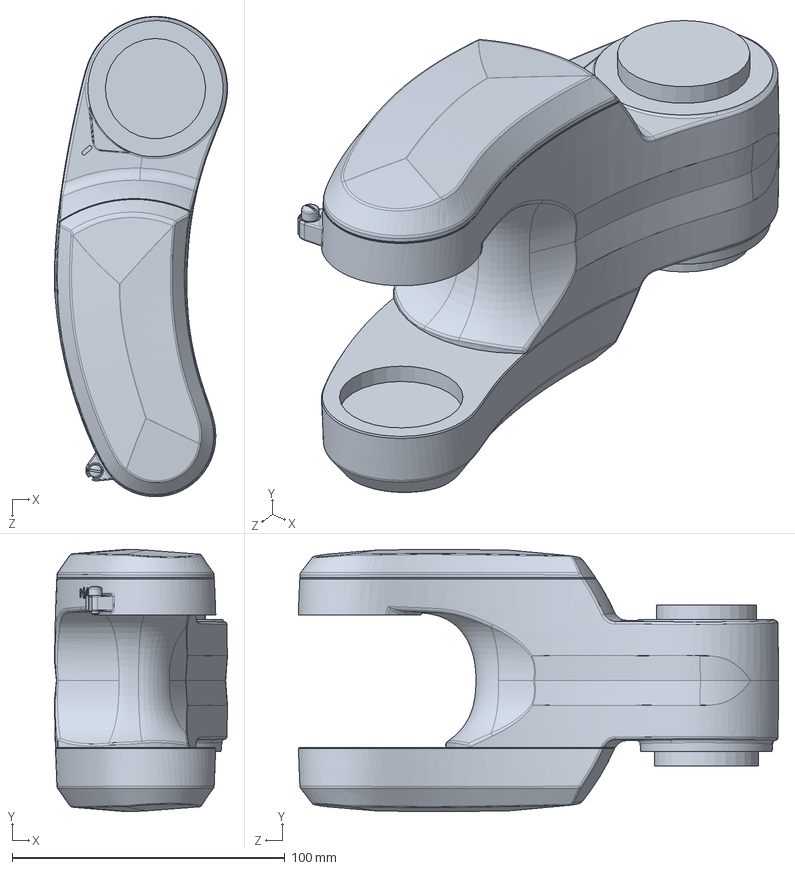
[picture p99: CAD file, 2026-10-10]
cad/parts/bergE5F4F25F1bc4[18].SLDPRT
63.4 x 96.0 x 176.0 mm
