nguyenthanhthe/uet-robotic-arm/hardware/reference/cots_parts/bergE5F4F25F1bc4[2].SLDPRT

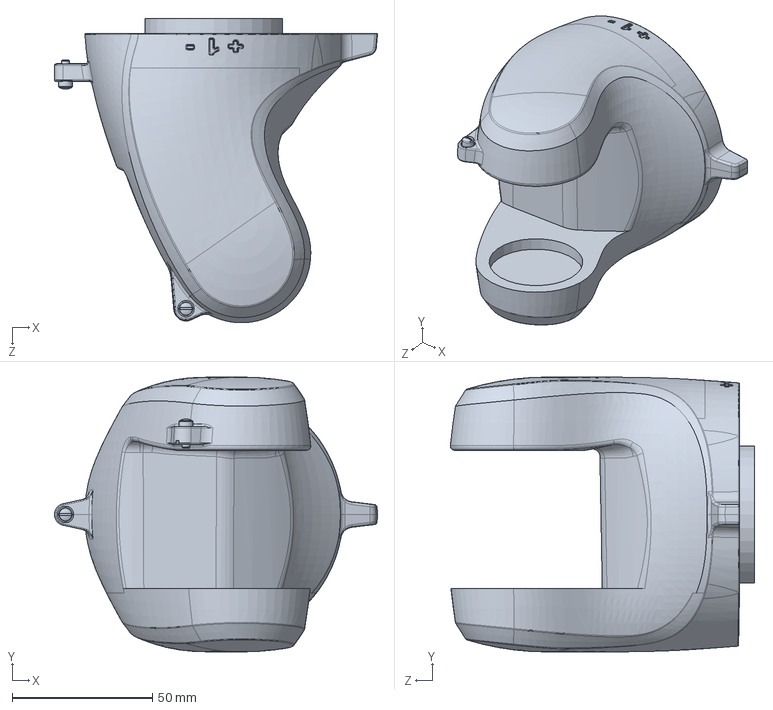
[picture p100: CAD file, 2026-09-27]
hardware/reference/cots_parts/bergE5F4F25F1bc4[2].SLDPRT
115.2 x 98.0 x 108.5 mm
