nguyenthanhthe/uet-robotic-arm/cad/parts/01_Base_Pedestal.SLDPRT

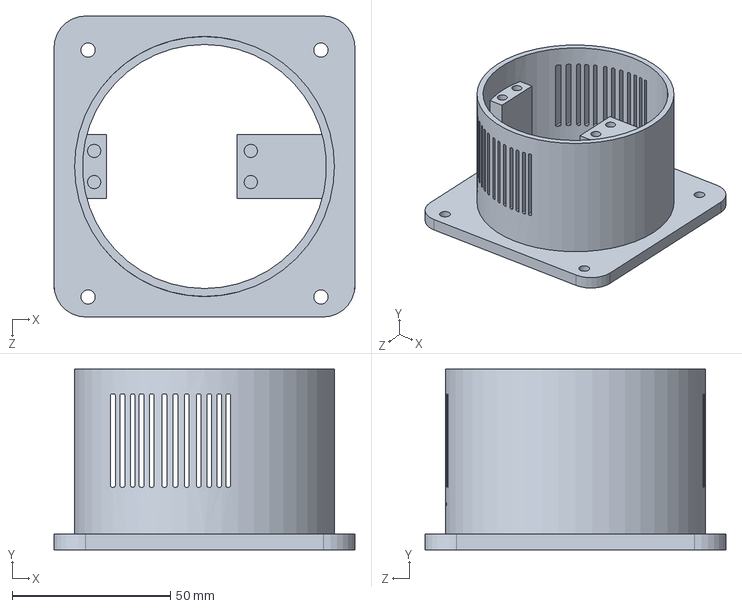
[picture p101: CAD file, 2026-10-10]
cad/parts/01_Base_Pedestal.SLDPRT
95.0 x 57.0 x 95.0 mm
