nguyenthanhthe/uet-robotic-arm/cad/parts/bergE5F4F25F1bc4[23].SLDPRT

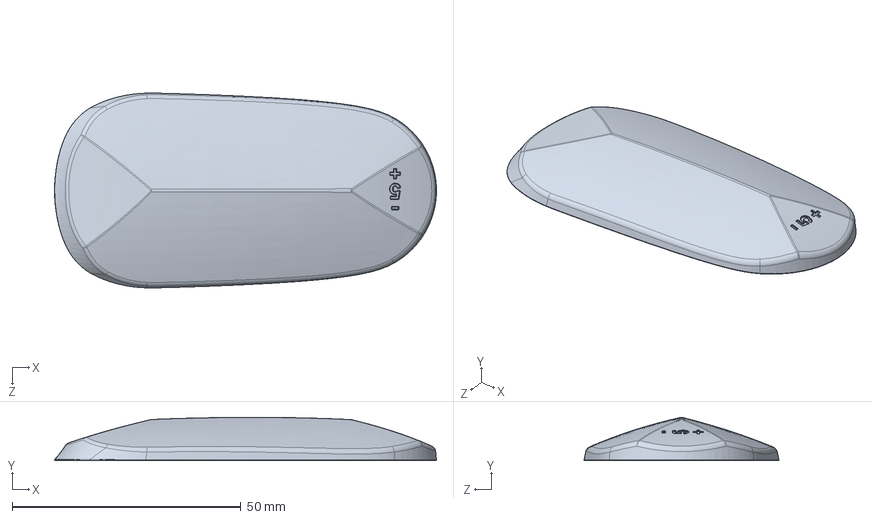
[picture p102: CAD file, 2026-10-10]
cad/parts/bergE5F4F25F1bc4[23].SLDPRT
83.5 x 9.46 x 42.6 mm
