nguyenthanhthe/uet-robotic-arm/cad/parts/bergE5F4F25F1bc4[3].SLDPRT

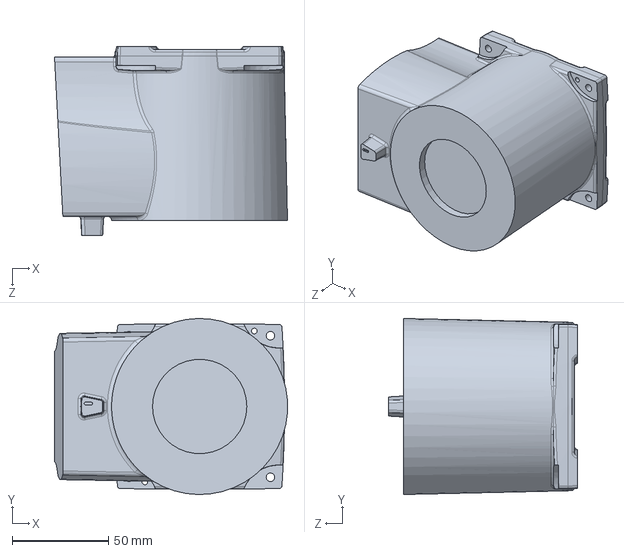
[picture p103: CAD file, 2026-10-10]
cad/parts/bergE5F4F25F1bc4[3].SLDPRT
121.0 x 91.4 x 98.0 mm
