nguyenthanhthe/uet-robotic-arm/cad/parts/02_Turret_Fork.SLDPRT

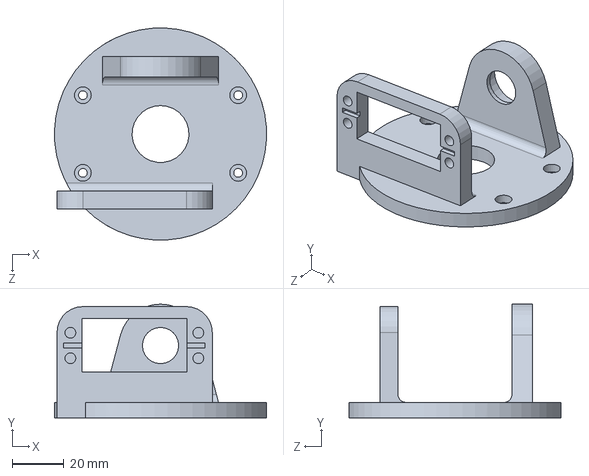
[picture p104: CAD file, 2026-10-10]
cad/parts/02_Turret_Fork.SLDPRT
81.9 x 44.0 x 81.9 mm
