nguyenthanhthe/uet-robotic-arm/cad/parts/02_Base_Turret.SLDPRT

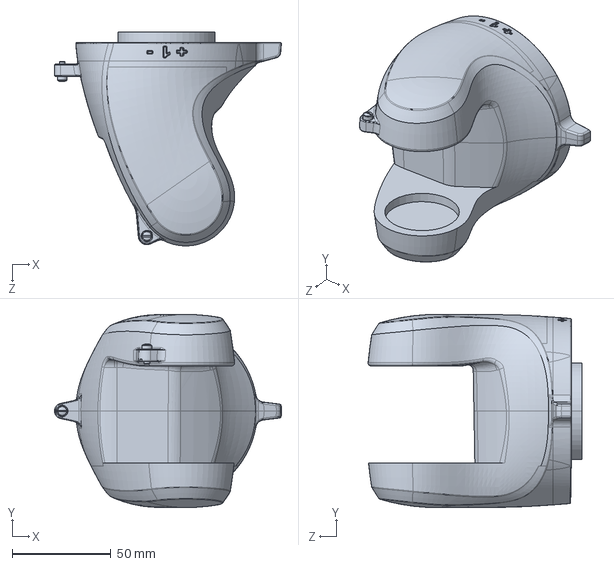
[picture p105: CAD file, 2026-10-10]
cad/parts/02_Base_Turret.SLDPRT
115.2 x 98.0 x 108.5 mm
