nguyenthanhthe/uet-robotic-arm/cad/parts/01_Base_TopCap.SLDPRT

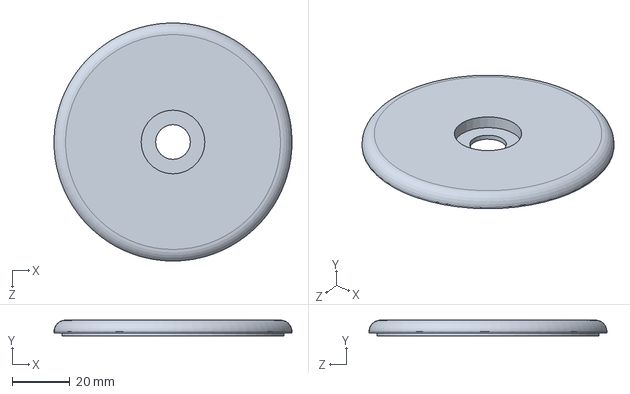
[picture p106: CAD file, 2026-10-10]
cad/parts/01_Base_TopCap.SLDPRT
82.2 x 5.50 x 82.2 mm
