nguyenthanhthe/uet-robotic-arm/cad/parts/02_Turret_ForkKuka_TestSlice.SLDPRT

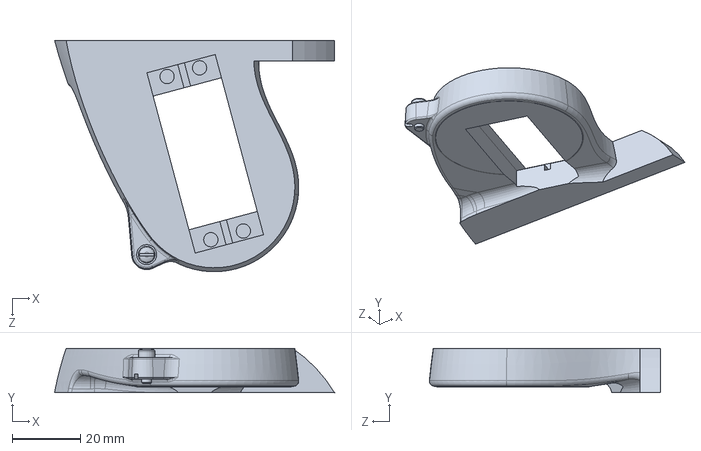
[picture p107: CAD file, 2026-10-10]
cad/parts/02_Turret_ForkKuka_TestSlice.SLDPRT
81.9 x 13.0 x 67.7 mm
