nguyenthanhthe/uet-robotic-arm/cad/parts/Body2.SLDPRT

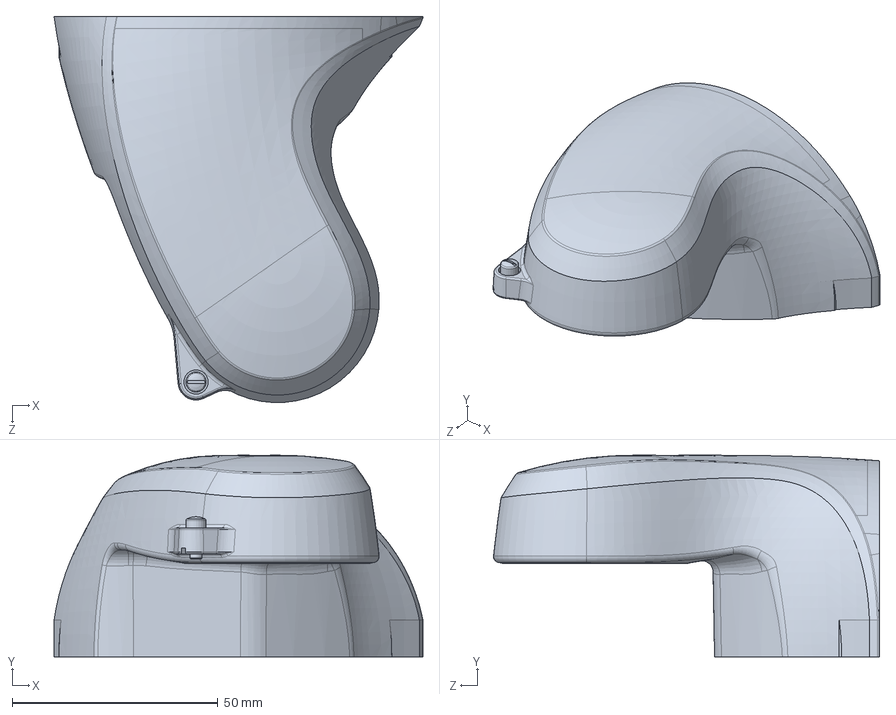
[picture p108: CAD file, 2026-10-10]
cad/parts/Body2.SLDPRT
89.6 x 49.0 x 93.8 mm
