nguyenthanhthe/uet-robotic-arm/cad/parts/bergE5F4F25F1bc4[15].SLDPRT

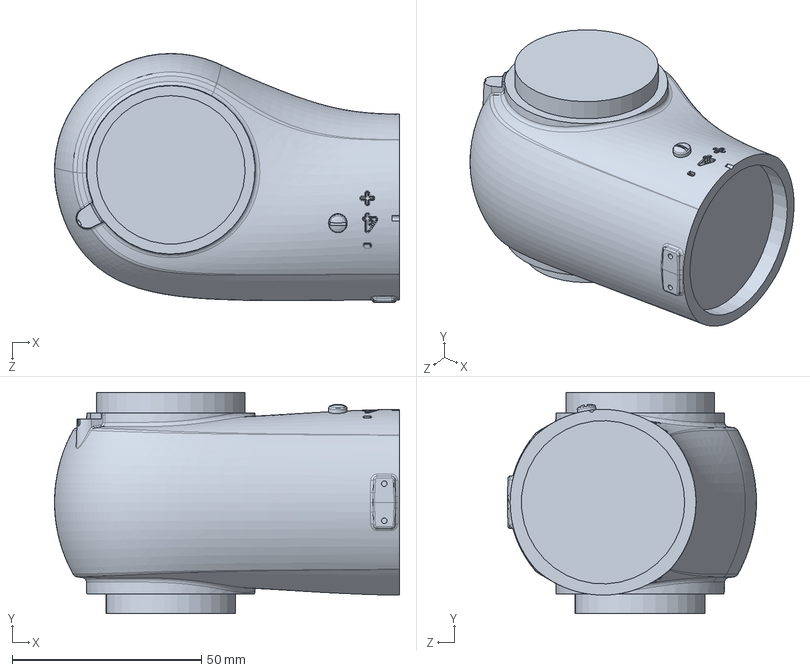
[picture p109: CAD file, 2026-10-10]
cad/parts/bergE5F4F25F1bc4[15].SLDPRT
91.1 x 58.4 x 65.8 mm
