nguyenthanhthe/uet-robotic-arm/cad/parts/03_UpperArm_Frame.SLDPRT

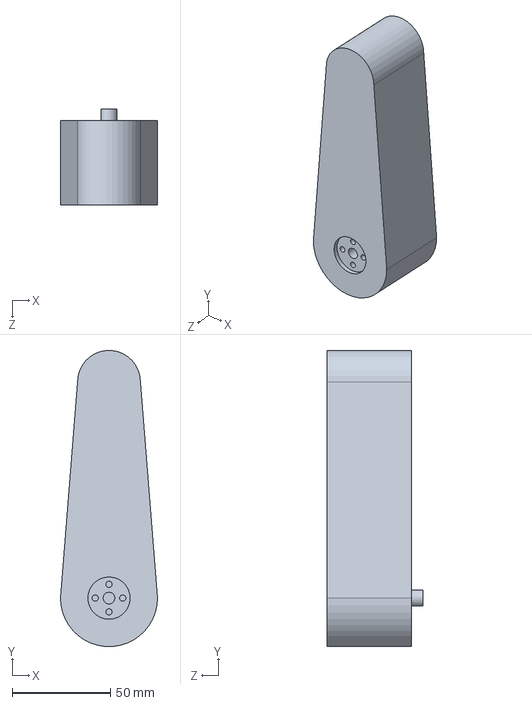
[picture p110: CAD file, 2026-09-27]
cad/parts/03_UpperArm_Frame.SLDPRT
49.4 x 150.5 x 49.0 mm
