nguyenthanhthe/uet-robotic-arm/cad/parts/04_Forearm_Body.SLDPRT

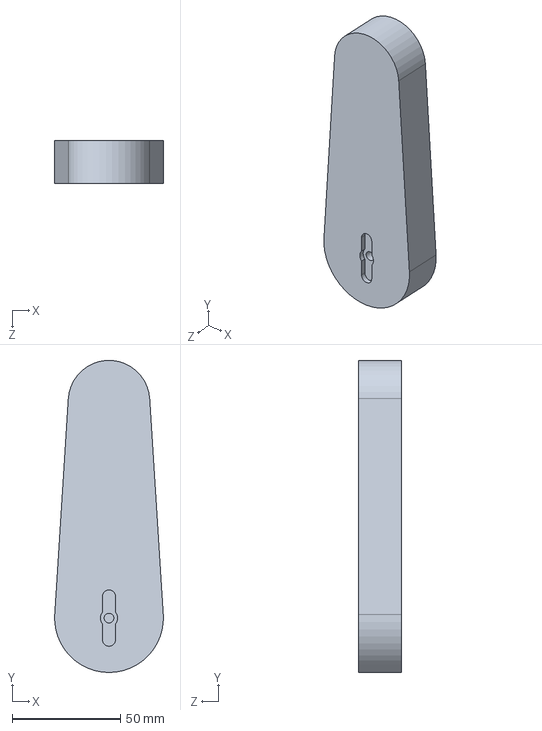
[picture p111: CAD file, 2026-09-27]
cad/parts/04_Forearm_Body.SLDPRT
50.0 x 143.8 x 20.0 mm
