nguyenthanhthe/uet-robotic-arm/hardware/reference/kuka scale 0.49/01_Base_SubAssembly.SLDASM

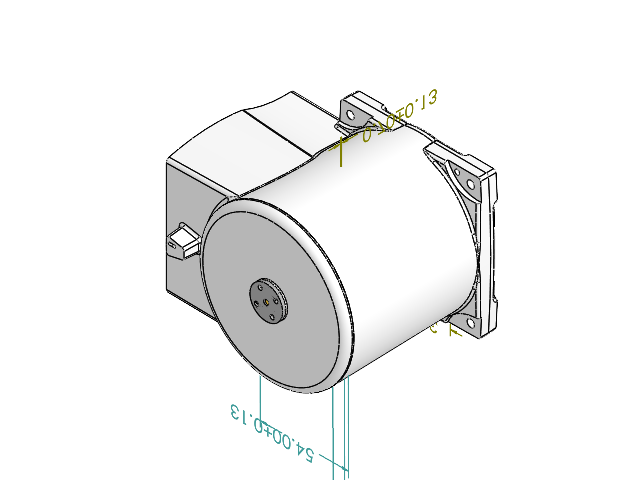
[picture p113: CAD file, 2026-10-10]
hardware/reference/kuka scale 0.49/01_Base_SubAssembly.SLDASM
bergE5F4F25F1bc4[3]
servoMotorMG996R
Arduino Uno
698zz Bearing
01_Base_TopCap
m3-insert-m3x574-insert.step x 4
Servo horn v2.step
