nguyenthanhthe/uet-robotic-arm/cad/parts/02_Turret_SubAssembly.SLDASM

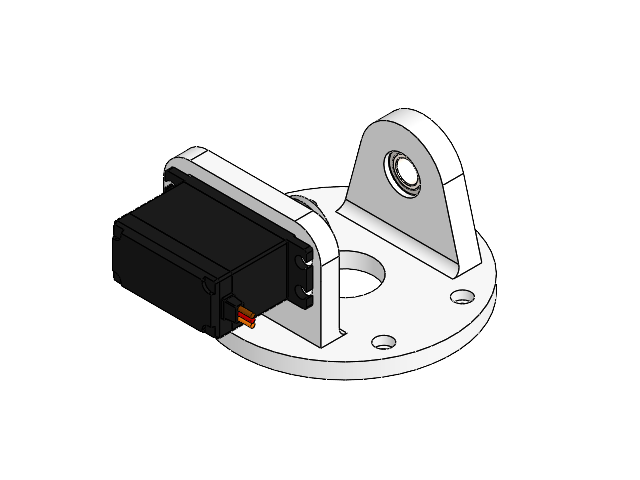
[picture p114: CAD file, 2026-10-10]
cad/parts/02_Turret_SubAssembly.SLDASM
02_Turret_Fork
servoMotorMG996R
Servo horn v2
698zz Bearing
