nguyenthanhthe/uet-robotic-arm/cad/parts/Assem1.SLDASM

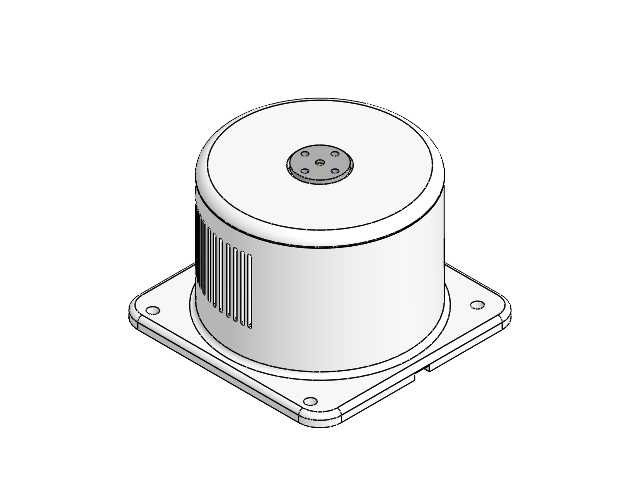
[picture p115: CAD file, 2026-10-10]
cad/parts/Assem1.SLDASM
01_Base_Pedestal
servoMotorMG996R
01_Base_TopCap
m3-insert-m3x574-insert.step x 4
Servo horn v2.step
