nguyenthanhthe/uet-robotic-arm/hardware/reference/cots_parts/Servo Motor MG996R  With Attachments.SLDASM

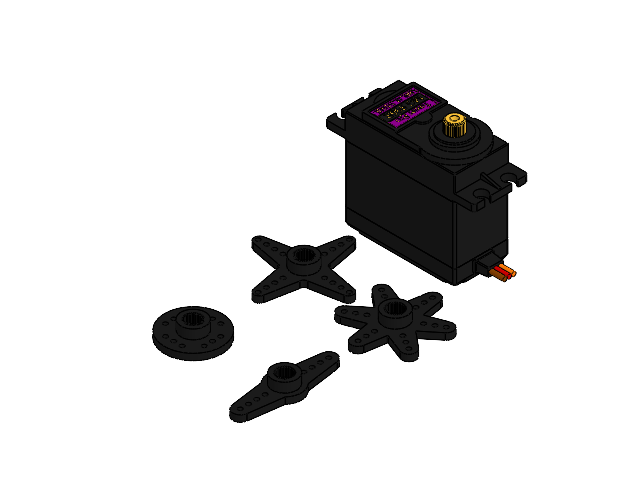
[picture p116: CAD file, 2026-09-27]
hardware/reference/cots_parts/Servo Motor MG996R With Attachments.SLDASM
servoMotorMG996R
attachmentCircular
attachmentCross
attachmentStar
attachmentStraight
