nguyenthanhthe/uet-robotic-arm/cad/parts/kuka scaled.SLDASM

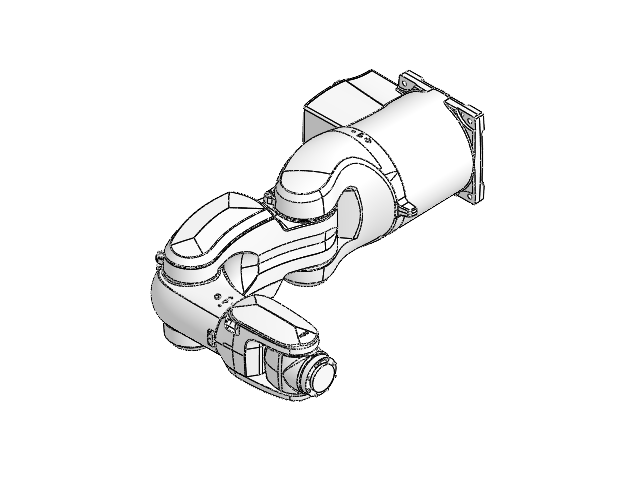
[picture p117: CAD file, 2026-10-10]
cad/parts/kuka scaled.SLDASM
bergE5F4F25F1bc4[3]
bergE5F4F25F1bc4[2]
bergE5F4F25F1bc4[18]
bergE5F4F25F1bc4[15]
Solid1[1]
bergE5F4F25F1bc4[22]
bergE5F4F25F1bc4[21]
bergE5F4F25F1bc4[23]
bergE5F4F25F1bc4[45]
