nguyenthanhthe/uet-robotic-arm/(list of files, cad)

Other CAD files:
cad/exports/v2rad/step/Forearm-Main.step
hardware/reference/Main Arm Left[1].SLDPRT
hardware/reference/Main Arm Cover[1].SLDPRT
hardware/reference/v2rad_parts/Main Arm Right[1].SLDPRT
cad/exports/v2rad/step/Main-Arm-Main.step
cad/exports/v2rad/step/Base-Main.step
hardware/reference/Gripper Gear[1].SLDPRT
cad/exports/v2rad/step/Wrist-Pulley.step
hardware/reference/Gripper Left[1].SLDPRT
cad/exports/v2rad/step/Pulley-Servo-Horn.step
cad/exports/v2rad/step/Wrist-Right.step
hardware/reference/cots_parts/MG90S Servo Horn (2 spork).step
hardware/reference/cots_parts/attachmentStraight.SLDPRT
cad/exports/v2rad/step/Gripper-Rack-Right.step
hardware/reference/Gripper Rack Right[1].SLDPRT
hardware/reference/cots_parts/attachmentStar.SLDPRT
hardware/reference/Forearm Cover[1].SLDPRT
hardware/reference/cots_parts/attachmentCross.SLDPRT
cad/exports/v2rad/step/Gripper-Right.step
cad/exports/v2rad/step/Wrist-Left.step
hardware/reference/cots_parts/Axixi Servo Disc.STEP
cad/exports/v2rad/step/Gripper-Left.step
cad/exports/v2rad/step/Forearm-Right.step
cad/exports/v2rad/step/Gripper-Rack-Left.step
hardware/reference/cots_parts/attachmentCircular.SLDPRT
cad/exports/v2rad/step/Forearm-Left.step
cad/exports/v2rad/step/Shoulder-Base.step
cad/exports/v2rad/step/Shoulder-Ring.step
cad/exports/v2rad/step/v2rad-all-parts.step.SLDPRT
hardware/reference/cots_parts/Axixi Servo Disc1.SLDPRT
cad/parts/bergE5F4F25F1bc4[2].SLDPRT
cad/exports/02_Base_Turret.stl
cad/exports/v2rad/step/Base-Cover.SLDPRT
cad/exports/v2rad/step/Base-Main.SLDPRT
cad/exports/v2rad/step/Controller-Plug-Cover.SLDPRT
cad/exports/v2rad/step/Forearm-Cover.SLDPRT
cad/exports/v2rad/step/Forearm-Main.SLDPRT
cad/exports/v2rad/stl/Base-Cover.stl
cad/exports/v2rad/stl/Base-Main.stl
cad/exports/v2rad/stl/Controller-Plug-Cover.stl
cad/exports/v2rad/stl/Forearm-Cover.stl
cad/exports/v2rad/stl/Forearm-Left.stl
cad/exports/v2rad/stl/Forearm-Main.stl
cad/exports/v2rad/stl/Forearm-Right.stl
cad/exports/v2rad/stl/Gripper-Gear.stl
cad/exports/v2rad/stl/Gripper-Left.stl
cad/exports/v2rad/stl/Gripper-Rack-Left.stl
cad/exports/v2rad/stl/Gripper-Rack-Right.stl
cad/exports/v2rad/stl/Gripper-Right.stl
cad/exports/v2rad/stl/Main-Arm-Cover.stl
cad/exports/v2rad/stl/Main-Arm-Left.stl
cad/exports/v2rad/stl/Main-Arm-Main.stl
cad/exports/v2rad/stl/Main-Arm-Right.stl
cad/exports/v2rad/stl/Pulley-Servo-Horn.stl
cad/exports/v2rad/stl/Shoulder-Base.stl
cad/exports/v2rad/stl/Shoulder-Left.stl
cad/exports/v2rad/stl/Shoulder-Right.stl
cad/exports/v2rad/stl/Shoulder-Ring.stl
cad/exports/v2rad/stl/Wrist-Left.stl
cad/exports/v2rad/stl/Wrist-Pulley.stl
cad/exports/v2rad/stl/Wrist-Right.stl
hardware/reference/cots_parts/698zz Bearing.SLDPRT
hardware/reference/cots_parts/Arduino Uno.SLDPRT
hardware/reference/cots_parts/Assembly SERVO.SLDASM
hardware/reference/cots_parts/Axixi Servo Disc.SLDPRT
hardware/reference/cots_parts/DS3225SG 25KG + Its Horns.SLDASM
hardware/reference/cots_parts/KR3 R540.SLDPRT
hardware/reference/cots_parts/kuka scale 0.49/01_Base_TopCap.SLDPRT
hardware/reference/cots_parts/kuka scale 0.49/kuka scaled.SLDASM
hardware/reference/cots_parts/m3-insert-m3x574-insert.SLDPRT
