nguyenthanhthe/uet-robotic-arm/docs/interference detection robot j1j2 assembly.xlsx

Interference ID | Interference volume (in^3) | Component 1 name | Component 2 name | Component 1 full reference | Component 2 full reference
Interference1 | 0.0015 | Servo horn v2-6 | DS3225SG-1 | Servo horn v2-6 | DS3225SG-1
Interference2 | 5.5e-05 | 04_Forearm_ForkKuka-1 | 04_Forearm_CoverPivot-1 | 04_Forearm_ForkKuka-1 | 04_Forearm_CoverPivot-1
Interference3 | 1.7e-05 | servoMotorMG996R-7 | PCA9685_Servo_Shield-1 | servoMotorMG996R-7 | PCA9685_Servo_Shield-1
Interference4 | 7e-06 | servoMotorMG996R-11 | Servo horn v2-7 | servoMotorMG996R-11 | Servo horn v2-7
Interference5 | 7e-06 | servoMotorMG996R-7 | Servo horn v2-4 | servoMotorMG996R-7 | Servo horn v2-4
Interference6 | 7e-06 | servoMotorMG996R-7 | Servo horn v2-4 | servoMotorMG996R-7 | Servo horn v2-4
Interference7 | 7e-06 | servoMotorMG996R-11 | Servo horn v2-7 | servoMotorMG996R-11 | Servo horn v2-7
Interference8 | 7e-06 | servoMotorMG996R-11 | Servo horn v2-7 | servoMotorMG996R-11 | Servo horn v2-7
Interference9 | 6.9e-06 | servoMotorMG996R-7 | Servo horn v2-4 | servoMotorMG996R-7 | Servo horn v2-4
Interference10 | 6.9e-06 | servoMotorMG996R-7 | Servo horn v2-4 | servoMotorMG996R-7 | Servo horn v2-4
Interference11 | 6.9e-06 | servoMotorMG996R-11 | Servo horn v2-7 | servoMotorMG996R-11 | Servo horn v2-7
Interference12 | 6.8e-06 | servoMotorMG996R-11 | Servo horn v2-7 | servoMotorMG996R-11 | Servo horn v2-7
Interference13 | 6.8e-06 | servoMotorMG996R-7 | Servo horn v2-4 | servoMotorMG996R-7 | Servo horn v2-4
Interference14 | 6.8e-06 | servoMotorMG996R-7 | Servo horn v2-4 | servoMotorMG996R-7 | Servo horn v2-4
Interference15 | 6.7e-06 | servoMotorMG996R-11 | Servo horn v2-7 | servoMotorMG996R-11 | Servo horn v2-7
Interference16 | 6.6e-06 | servoMotorMG996R-11 | Servo horn v2-7 | servoMotorMG996R-11 | Servo horn v2-7
Interference17 | 6.5e-06 | servoMotorMG996R-7 | Servo horn v2-4 | servoMotorMG996R-7 | Servo horn v2-4
Interference18 | 6.5e-06 | servoMotorMG996R-7 | Servo horn v2-4 | servoMotorMG996R-7 | Servo horn v2-4
Interference19 | 6.4e-06 | servoMotorMG996R-11 | Servo horn v2-7 | servoMotorMG996R-11 | Servo horn v2-7
Interference20 | 6.4e-06 | servoMotorMG996R-11 | Servo horn v2-7 | servoMotorMG996R-11 | Servo horn v2-7
Interference21 | 6.2e-06 | servoMotorMG996R-7 | Servo horn v2-4 | servoMotorMG996R-7 | Servo horn v2-4
Interference22 | 6.2e-06 | servoMotorMG996R-7 | Servo horn v2-4 | servoMotorMG996R-7 | Servo horn v2-4
Interference23 | 6.1e-06 | servoMotorMG996R-11 | Servo horn v2-7 | servoMotorMG996R-11 | Servo horn v2-7
Interference24 | 6e-06 | servoMotorMG996R-11 | Servo horn v2-7 | servoMotorMG996R-11 | Servo horn v2-7
Interference25 | 5.8e-06 | servoMotorMG996R-7 | Servo horn v2-4 | servoMotorMG996R-7 | Servo horn v2-4
Interference26 | 5.8e-06 | servoMotorMG996R-7 | Servo horn v2-4 | servoMotorMG996R-7 | Servo horn v2-4
Interference27 | 5.7e-06 | servoMotorMG996R-11 | Servo horn v2-7 | servoMotorMG996R-11 | Servo horn v2-7
Interference28 | 5.6e-06 | servoMotorMG996R-11 | Servo horn v2-7 | servoMotorMG996R-11 | Servo horn v2-7
Interference29 | 5.4e-06 | servoMotorMG996R-7 | Servo horn v2-4 | servoMotorMG996R-7 | Servo horn v2-4
Interference30 | 5.4e-06 | servoMotorMG996R-7 | Servo horn v2-4 | servoMotorMG996R-7 | Servo horn v2-4
Interference31 | 5.2e-06 | servoMotorMG996R-11 | Servo horn v2-7 | servoMotorMG996R-11 | Servo horn v2-7
Interference32 | 5.1e-06 | servoMotorMG996R-11 | Servo horn v2-7 | servoMotorMG996R-11 | Servo horn v2-7
Interference33 | 4.9e-06 | servoMotorMG996R-7 | Servo horn v2-4 | servoMotorMG996R-7 | Servo horn v2-4
Interference34 | 4.9e-06 | servoMotorMG996R-7 | Servo horn v2-4 | servoMotorMG996R-7 | Servo horn v2-4
Interference35 | 4.6e-06 | servoMotorMG996R-11 | Servo horn v2-7 | servoMotorMG996R-11 | Servo horn v2-7
Interference36 | 4.5e-06 | servoMotorMG996R-11 | Servo horn v2-7 | servoMotorMG996R-11 | Servo horn v2-7
Interference37 | 4.2e-06 | servoMotorMG996R-7 | Servo horn v2-4 | servoMotorMG996R-7 | Servo horn v2-4
Interference38 | 4.2e-06 | servoMotorMG996R-7 | Servo horn v2-4 | servoMotorMG996R-7 | Servo horn v2-4
Interference39 | 4e-06 | servoMotorMG996R-11 | Servo horn v2-7 | servoMotorMG996R-11 | Servo horn v2-7
Interference40 | 3.9e-06 | 06_Gripper_Pinion-1 | 06_Gripper_Jaw-2 | 06_Gripper_Pinion-1 | 06_Gripper_Jaw-2
Interference41 | 3.9e-06 | 06_Gripper_Pinion-1 | 06_Gripper_Jaw-1 | 06_Gripper_Pinion-1 | 06_Gripper_Jaw-1
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
Interference82 | 1.7e-07 | servoMotorMG996R-7 | Servo horn v2-4 | servoMotorMG996R-7 | Servo horn v2-4
Interference83 | 1.1e-07 | servoMotorMG996R-11 | Servo horn v2-7 | servoMotorMG996R-11 | Servo horn v2-7
Interference84 | 8e-08 | servoMotorMG996R-11 | Servo horn v2-7 | servoMotorMG996R-11 | Servo horn v2-7
Interference85 | 4e-08 | servoMotorMG996R-7 | Servo horn v2-4 | servoMotorMG996R-7 | Servo horn v2-4
Interference86 | 4e-08 | servoMotorMG996R-7 | Servo horn v2-4 | servoMotorMG996R-7 | Servo horn v2-4
Interference87 | 2e-08 | servoMotorMG996R-11 | Servo horn v2-7 | servoMotorMG996R-11 | Servo horn v2-7
Interference88 | 1e-08 | servoMotorMG996R-11 | Servo horn v2-7 | servoMotorMG996R-11 | Servo horn v2-7
