nguyenthanhthe/uet-robotic-arm/docs/media/frames_assembly_check/frame_13.0s.jpg

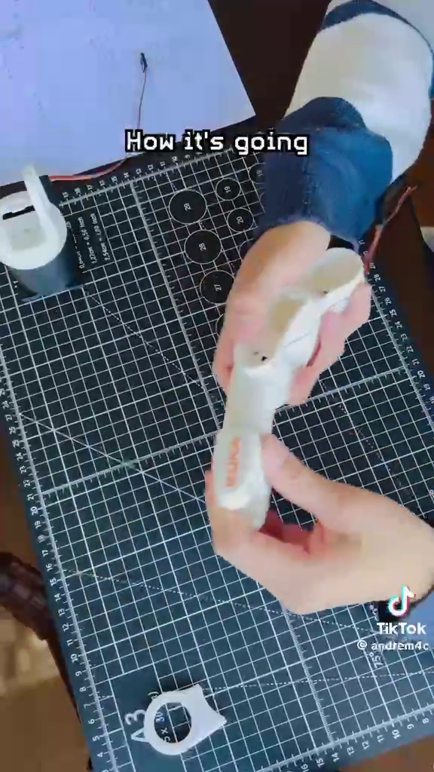
docs/media/frames_assembly_check/frame_13.0s.jpg
