nguyenthanhthe/uet-robotic-arm/docs/media/frames_assembly_check/frame_14.5s.jpg

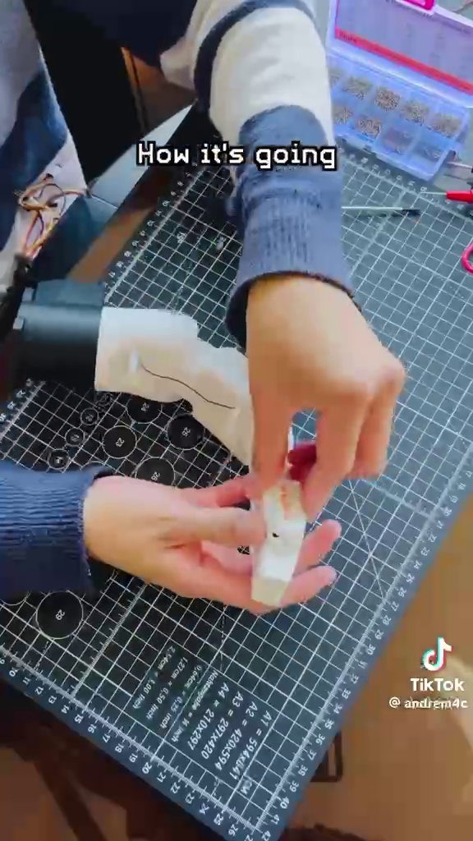
docs/media/frames_assembly_check/frame_14.5s.jpg
