nguyenthanhthe/uet-robotic-arm/docs/media/frames_assembly_check/frame_15.0s.jpg

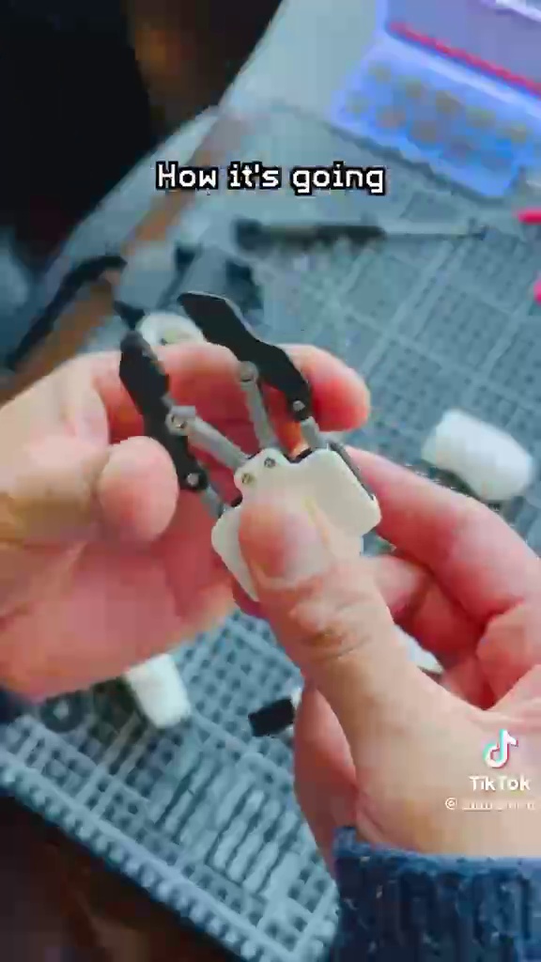
docs/media/frames_assembly_check/frame_15.0s.jpg
