nguyenthanhthe/uet-robotic-arm/docs/media/frames_assembly_check/frame_16.0s.jpg

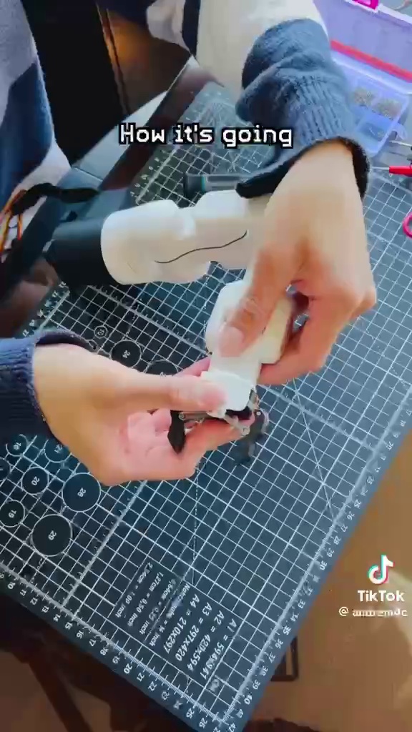
docs/media/frames_assembly_check/frame_16.0s.jpg
