nguyenthanhthe/uet-robotic-arm/docs/media/frames_base/asm_step2_2_12.0s.jpg

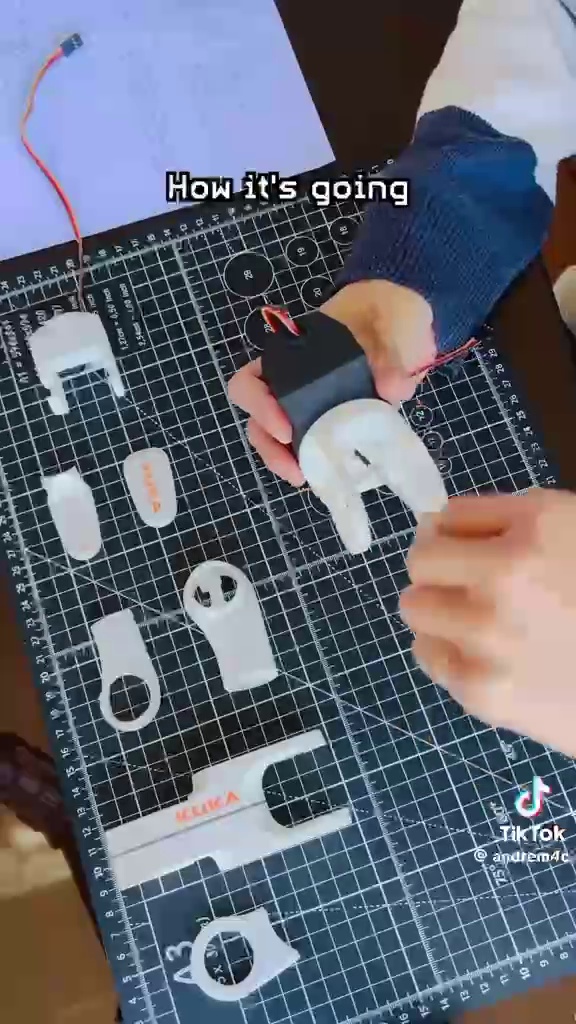
docs/media/frames_base/asm_step2_2_12.0s.jpg
