nguyenthanhthe/uet-robotic-arm/wiring-diagram.webp

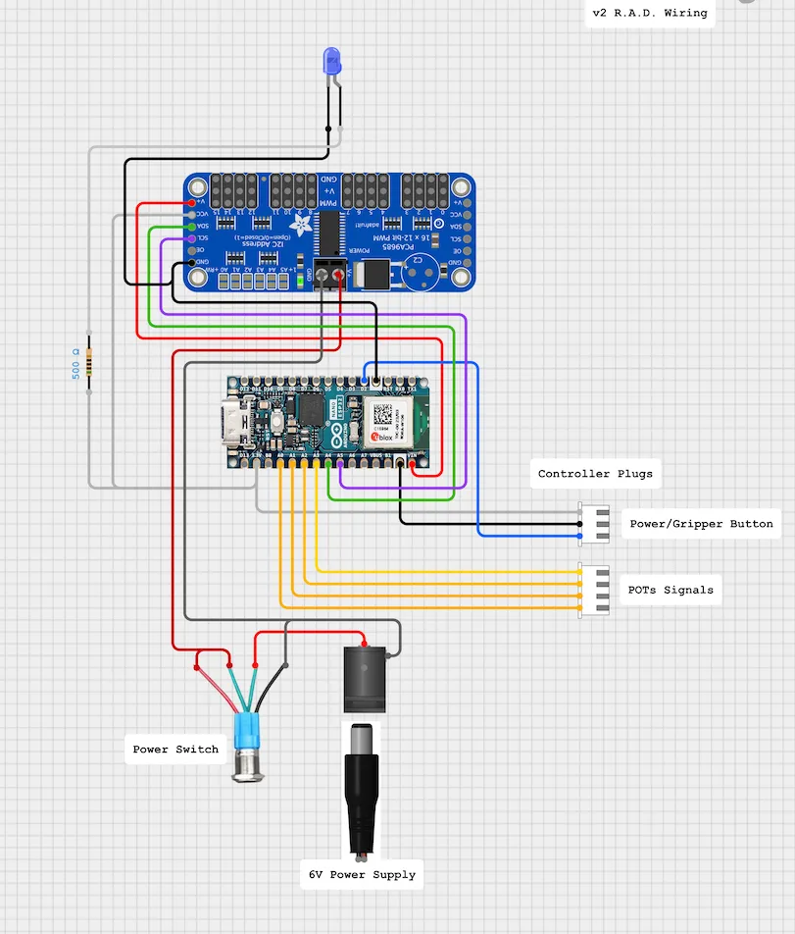
wiring-diagram.webp
