nguyenthanhthe/uet-robotic-arm/(commit log)

2026-09-19 khởi tạo dự án: tài liệu yêu cầu kỹ thuật và file tham khảo
2026-09-19 thêm chuỗi công cụ CAD/Typst: AGENTS.md, khung báo cáo typst, cấu trúc cad/
2026-09-25 add 5-dof kinematic model, cad tools, firmware and technical documentation
2026-09-25 add cad modeling and mcp workflow documentation
2026-09-27 feat(cad): complete J1 base assembly, reorganize project structure, add agent guidelines
    - Complete J1 Base pedestal redesign (concentric MG996R mounting, 698ZZ bearing pocket, 25T disc flush alignment)
    - Add 60mm deep rear electronics bay for Arduino Uno & PCA9685 with dedicated wire tunnel
    - Fix 4x M3 heat-set insert holes (dia 4.2mm x 5.5mm depth)
    - Reorganize project directory tree (cad/parts, cad/reference, docs/media, hardware/reference/cults3d_kuka, v2rad_parts)
    - Add CLAUDE.md, AGENTS.md, .skill.md, .agent/rules.md with SolidWorks MCP, /plan, /goal protocols
2026-10-10 feat: update KUKA 5-DOF CAD models, routing skills, kinematics and documentation
2026-10-10 feat(cad): lock wrist body in assembly and update KUKA CAD guide
2026-10-11 feat(cad): add parallel gripper, recentre J5 wrist servo, route cabling
    - Gripper: four new parts (base, guide, jaw, pinion) for a rack-and-pinion
    parallel gripper; base and guide form one 39 x 44.5 mm shell
    - Wrist: J5 servo moved onto the KUKA wrist nose centre so the J5 axis
    intersects the J4 axis
    - Forearm: J4 servo pocket and servo cover updates
    - Cabling: clip-in duct on the upper arm back, cable hole in the turret lug
    - Assembly: gripper and wrist mates added
    - Docs: CAD guide, robot-cad file inventory and AGENTS.md working rules
2026-10-11 fix(cad): clear assembly interferences and sync docs with the assembly
    - 04_Forearm_CoverPivot: 0.3 mm relief notch on the rear edge (fork lug)
    - 03_J2_BearingSpacer: length 5.6 -> 5.55 mm
    - 06_Gripper_Jaw: rack flanks relieved 0.12 mm for backlash
    - 01_Base_Tray + assembly: Arduino/PCA9685 stack shifted 0.2 mm off the
    J1 servo, standoff pilot holes moved with it
    - Docs: kinematic lengths measured on the assembly (L2 = 127.8, L3 = 86.8,
    reach 342 mm) in the kinematics docs, Typst report, README and goal.md;
    CAD guide mates/components section; file inventories
    - Add the SolidWorks Interference Detection exports (before / after)
2026-10-11 feat: sync kinematics code to assembly lengths and make gripper jaws movable
    - matlab + verify_kinematics_5dof.py: L2 = 127.8, L3 = 86.8 mm, wider plot axes
    - assembly: replace fixed jaw-opening mates with 0-23.6 mm limit-distance
    mates and rack-pinion mates (pitch dia 15 mm), 35 mates
    - add cad/tools/gripper_motion_mates.swb macro that creates those mates
    - update CAD guide, README and robot-cad routing
2026-10-11 fix(matlab): recompute joint torques from assembly masses and fix FK joint axes
    Torque check now uses part volumes and centres of gravity measured on the
    assembly, with the servos actually fitted (25 kg digital on J2, MG996R on J3,
    MG90S on J4). Pitch joints rotate about -Y so FK matches the IK convention.
    Docs and report updated to the new torque figures.
2026-10-11 fix(matlab): align joint limits with the D-H table and check IK results against them
    J2 is now -45..105 deg and J3 -90..75 deg in both the model script and the GUI
    sliders. The model script reports when an IK solution leaves the joint limits,
    and the GUI refuses such a solution instead of pushing it to the sliders.
2026-10-11 fix(cad): centre the gripper finger on the J5 axis so both jaws coincide
    The finger is now 34 mm tall (z 284..318) with a 15 mm tip centred on z = 301,
    so the second jaw, which is the same part turned 180 deg about J5, lines up
    with the first when closed. Guide and inventory text updated to match.
2026-10-11 docs: record DfAM findings, print orientations and open work; sync torque figures
    README progress now lists the printability issues found on the STL check (loose
    body in the turret, thin cover rim, gripper base wall), the gripper finger fix,
    the MATLAB status and the wrist camera task. The CAD guide gains a per-part
    print orientation and support table. Torque figures follow the taller jaw
    (J2 static 10.62 kg.cm) in the MATLAB mass table, the kinematics doc and the report.
2026-10-11 fix(cad): remove the loose turret body and thicken the cover rim and gripper collar
    02_Turret_ForkKuka: cut away the detached tip of the rear boss (57.6 mm3 second
    body left by the wire-slot cut); the part is one solid again and the wire slot is
    open at the back.
    04_Forearm_CoverServo: add a 1.2 mm flat rim band along the inner-face outline
    (y = 28.45 to 29.65 mm) so the perimeter is no longer a knife edge; window, wire
    channel and screw holes stay open.
    06_Gripper_Base: step the collar bore to R17.7 for x = 163.4 to 169.4 mm (1.8 mm
    wall); the rear 1.9 mm lip keeps R18.3 to clear the J5 servo body corner.
    README, the CAD guide (part descriptions, print table, thin-wall note) and the
    robot-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
2026-10-11 feat(cad): add a macro that colours the printed parts in the main assembly
    robot_appearance.swb sets component-level colour and gloss (KUKA orange links,
    black base/covers/gripper body, silver jaws and small parts) without touching the
    part files or the COTS components. Routed in the robot-cad skill and inventory.
2026-10-11 feat(cad): place the three MG90S two-arm horns in the main assembly
    MG90S_Horn_2arm is inserted for J4 (wrist side recess), J5 (gripper base rear
    recess) and the gripper pinion (carrier-disc recess), arm face on the recess
    floor and hub towards the servo, each locked to its host part. The assembly now
    has 31 components and 38 mates and carries the component appearances.
    The two-arm horn STEP is recorded as the dimension source for the three horn
    recesses; README, the CAD guide and the robot-cad / robot-hardware inventories
    follow.
